BDR16/ARCHIBALD-the-battery-box/README.md

# ARCHIBALD-the-battery-box
*Before attempting to modify or alter any part or file within this assembly, please be sure to sync before and after any changes are made. After modification please be sure to commit changes as well.*
