BDR16/ARCHIBALD-the-battery-box/CURRENT.16-17/Accumulator/Stacks/Stack Design.xls

Sheet: Pressure
Pressure
The cells need to be compressed between 4 – 18 psi according to the A123 Amp20 Battery Pack Design Guide. This is particularly difficult because the cells expand as they are charged and as they age. In the design outlined below, an expansion limiter is used to fix the length of the stack, and compliant pads are placed between every other cell such that a pressure within the 4 – 18 psi range is maintained. The compliant pads need to be as thin as possible while still being able to expand and contract enough to keep a suitable pressure on the cell face. Additionally the compliant pad should be electrically insulating.
Repeating Cell Module
A two cell module is pictured to the right. The bottom part of the picture shows the module consisting of (left to right) an aluminum heat spreader, cell, compliant pad, cell, and Kapton tape. An analysis of the compliant pad's properties can be carried out at the two cell module level. The addition of an end module in the 21 cell stack will change the stack properties slightly, but not enough to warrant an analysis on the entire stack.
Cell Constants
Thickness (mm) | SOC expansion (mm) | Age expansion (mm) | Total expansion (mm) | Minimum pressure (kPa) | Maximum pressure (kPa)
7.1 | 0.05 | 0.36 | 0.41 | 27.58 | 124.11
Aluminum Constants
Thickness (mm) | Young's Modulus (kPa)
0.3 | 65000
Kapton Tape Constants
Thickness (mm) | Young's Modulus (kPa)
0.07 | 2500
Stack Constants
Minimum pressure (kPa) | Maximum pressure (kPa) | Total Length (mm)
35 | 100 | 15.4
System of Equations
We get the following system of equations by looking at the minimum pressure and maximum pressure operating points of the two cell stack module. We want to solve for compliant pad thickness and compliant pad Young's modulus. The following two equations are based off of Hooke's law, namely P = Eε. The aluminum, compliant pad, and Kapton tape thicknesses are calculated through Hooke's law, while the cell thickness is based on state of charge (SOC). The first equation is for 0% SOC with all new cells (minimum thickness), and the second equation is for 100% SOC with all old cells (maximum thickness).
(1 - P_min/E_aluminum) * L_aluminum + 2 * L_cell + (1 - P_min/E_kapton) * L_kapton + (1 – P_min/E_pad) * L_pad = L_total
(1 - P_max/E_aluminum) * L_aluminum + 2 * (L_cell + dL_cell_age + dL_cell_SOC) + (1 - P_max/E_kapton) * L_kapton + (1 – P_max/E_pad) * L_pad = L_total
Intermediate constant | E_pad (kPa) | L_pad (kPa)
0.0159558124 | 101.0539443 | 1.271538462
Design Choice
Neoprene and Polyurethane foam are two good choices for this application. However neoprene foam is much cheaper at the cost of slightly worse characteristics. A neoprene foam 1/16” thick and with a 9-13 psi firmness at 25% deflection was chosen. Its P_min and P_max are calculated below. Keep in mind that these batteries will not have time to age to the point that they have 3% to 5% deflection, therefore designing for only 1% or 2% to account for SOC is good enough.
E_pad (kPa) | L_pad (kPa)
75.8 | 1.5875
Minimum pressure (kPa) | 36.11289451
Maximum pressure (kPa) | 75.20540078
Size | 42” x 72”
Cost ($) | 16.06
Firmness (25%) | 9-13 psi (firm)
Link | http://www.mcmaster.com/#8647k109/=y4ipnx

Sheet: Thermal
Thermal
The cells will have hundreds of amperes of current running through them continuously. This means that they will heat up due to their internal resistance. This heat needs to be dissipated such that the cells do not overheat. Note that a two cell module will be used in the following design. The results can then be extended to the stack design because the stack is modular about the two cell module (for the most part).
Cell Constants
Internal Resistance (mOhm) | Preferred Temperature (ºC) | Max Temperature (ºC) | Continuous Current (A) | Peak Current (A)
3 | 50 | 60 | 200 | 600
Environment Constants
Ambient Temperature (ºC)
30
Thermal Design
The thermal load can be calculated from the continuous current and internal resistance. Then the required thermal resistance between the cells and their environment can be calculated for steady state. Note that this is for a two cell module, hence the constant factor of two.
Thermal Load (W) | Thermal Resistance (ºC/W) | Water Mass Flow (kg/s) | Water Volume Flow (L/min)
P = 2 * I^2 * R | R = ΔT / P | m/t = P / (c * ΔT) | V/t = m/t * 60
240 | 0.125 | 1.904761905 | 114.2857143
