BDR16/ARCHIBALD-the-battery-box/old.15-16/Firewall/Timeline.docx

Timeline for Firewall and Seat fabrication

Joshua Chang and Jordan Gardner

Updated February 20, 2016: Bullet points indicate actual completion of work.

Feb 3 – Feb 5: Fabricating firewall, ordering insulating material

- Feb 3 – 11: Fabrication
  - Cut and fit both firewalls

Feb 6 – Feb 7: Test fit firewalls, designate tab locations

- February 11: Test fit

Feb 9 – Feb 13: Acquire foam, glue it together, preliminary cut/shape

- Feb 13 – Feb 19: Foam acquired, individual sheets cut

Feb 14 – Feb 20: Refine shape, ensure we have vacuum bagging, other materials

Feb 21: Cover in fiberglass to create male mold

Feb 23 – Feb 25: Finish fiberglass, first layer of carbon

Feb 25 – Mar 1: More layers of carbon

Mar 1 – Mar 6: Finish carbon construction, test fit seat

Other tasks: Install tabs

Foam bead kit for seat

Fabrication times:
Tuesdays 10:15a – 11:30a

Tuesday and/or Thursday evenings
