BDR16/ARCHIBALD-the-battery-box/CURRENT.16-17/Accumulator/Battery Management System/BMS Controller/BMS Controller.SLDASM

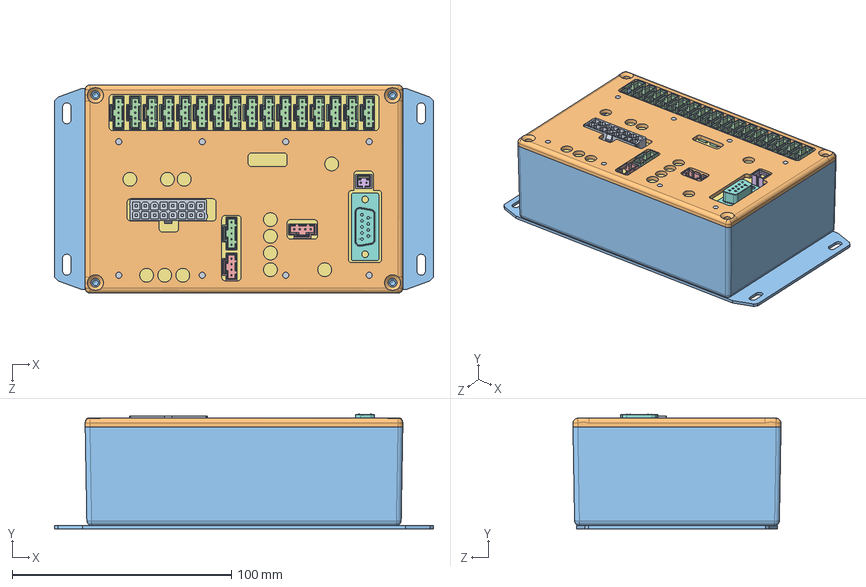
[picture p1: CAD file, 2016-11-20]
CURRENT.16-17/Accumulator/Battery Management System/BMS Controller/BMS Controller.SLDASM
173.0 x 52.3 x 95.0 mm
PEM FHS-440-4ZI x 8
1590J Lid
1590JF Box
Molex 705430004 x 17
Molex 705430003 x 2
Molex 705430001
Lithiumate Board
NorComp 171-009-213
Molex 039281163
