BDR16/ARCHIBALD-the-battery-box/CURRENT.16-17/Accumulator/Stacks/Cell Modules/Negative End Module Even.SLDASM

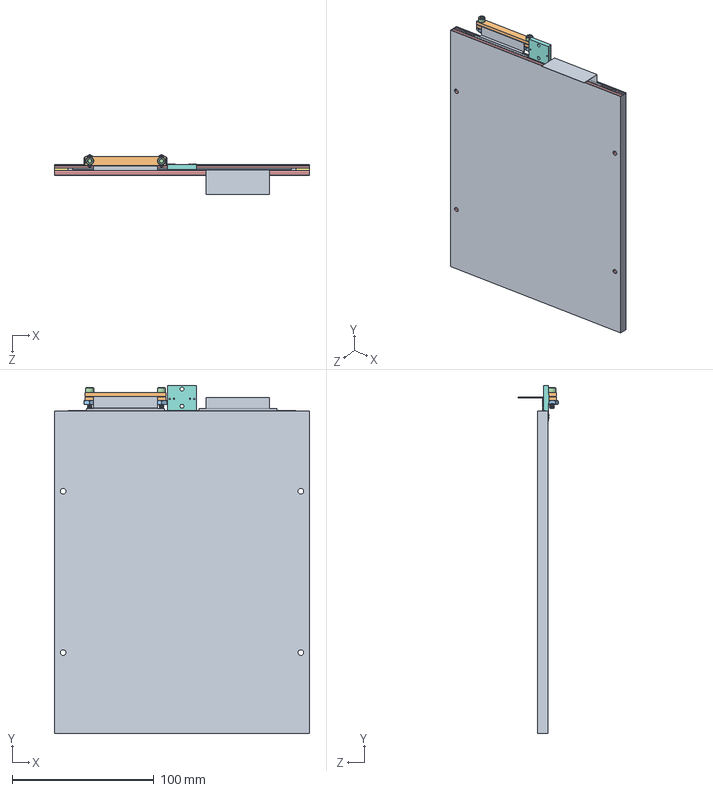
[picture p2: CAD file, 2016-11-20]
CURRENT.16-17/Accumulator/Stacks/Cell Modules/Negative End Module Even.SLDASM
179.7 x 245.1 x 28.3 mm
Cell Tab Config A Negative End
Tab Load Spreader x 2
Steel Toplock 6-32 Grade 2 x 2
Steel 6-32 0.4375in x 2
Repeating Frame Outer x 3
Insulation Film Back
Insulation Film Half
Cell Board End
Heat Sink Half
