BDR16/ARCHIBALD-the-battery-box/CURRENT.16-17/Accumulator/Stacks/Stack Parts/Insulation Film/Insulation Film Full.SLDPRT

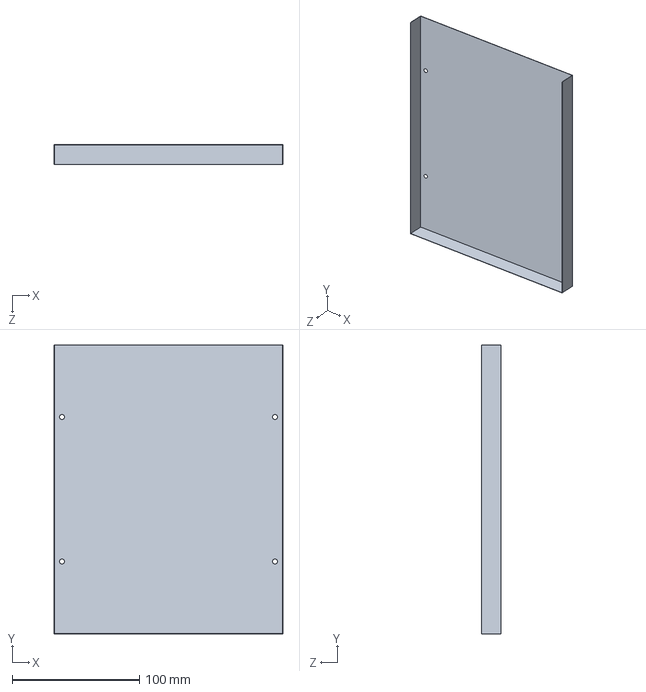
[picture p3: CAD file, 2016-11-20]
CURRENT.16-17/Accumulator/Stacks/Stack Parts/Insulation Film/Insulation Film Full.SLDPRT
179.7 x 227.2 x 15.5 mm
