BDR16/ARCHIBALD-the-battery-box/CURRENT.16-17/Accumulator/Charging/Charging.SLDASM

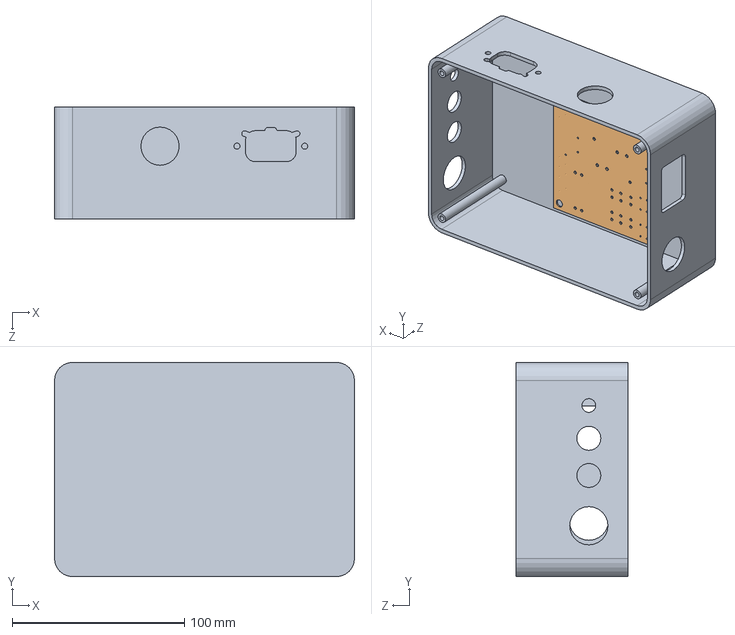
[picture p4: CAD file, 2016-11-20]
CURRENT.16-17/Accumulator/Charging/Charging.SLDASM
174.3 x 124.5 x 65.3 mm
Charging Box
Charging Board
