BDR16/ARCHIBALD-the-battery-box/CURRENT.16-17/Accumulator/HV Control/Current Sensor/Current Sensor.SLDASM

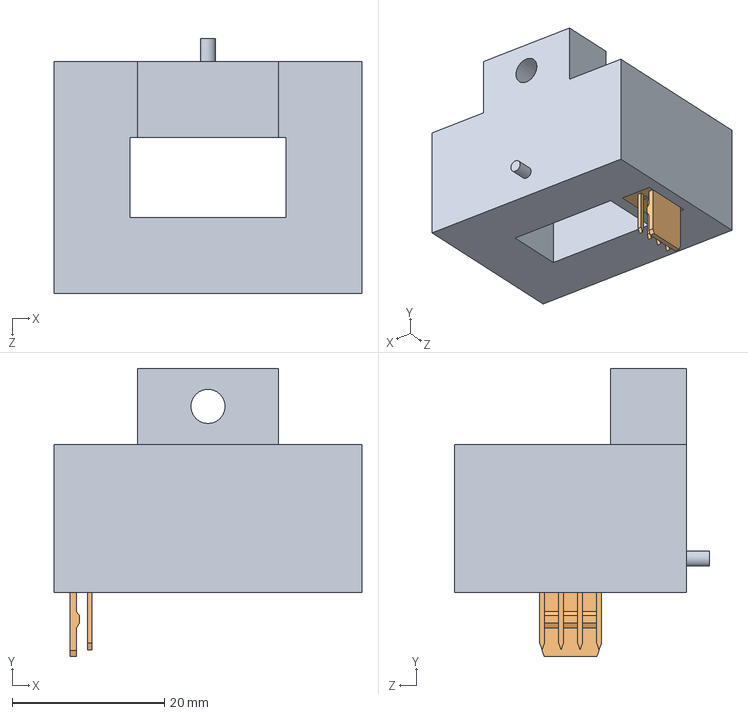
[picture p5: CAD file, 2016-11-20]
CURRENT.16-17/Accumulator/HV Control/Current Sensor/Current Sensor.SLDASM
40.5 x 37.9 x 33.5 mm
Current Sensor
Current Sensor Connector
