BDR16/ARCHIBALD-the-battery-box/CURRENT.16-17/Accumulator/Motor Controller/Motor Controller.SLDASM

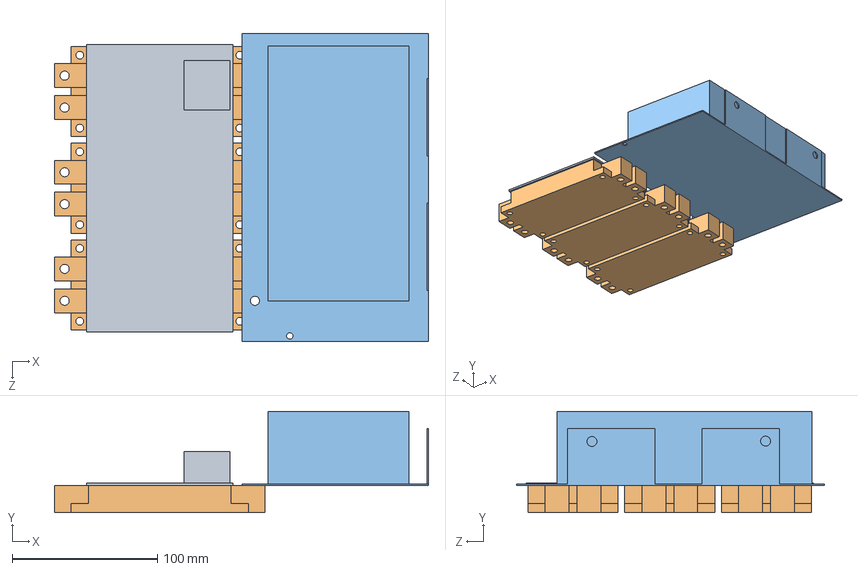
[picture p6: CAD file, 2016-11-20]
CURRENT.16-17/Accumulator/Motor Controller/Motor Controller.SLDASM
257.5 x 69.8 x 212.0 mm
HV Board
IGBT x 3
Capacitor Board
