BDR16/ARCHIBALD-the-battery-box/CURRENT.16-17/Accumulator/HV Control/HV Fusing/HV Fusing.SLDASM

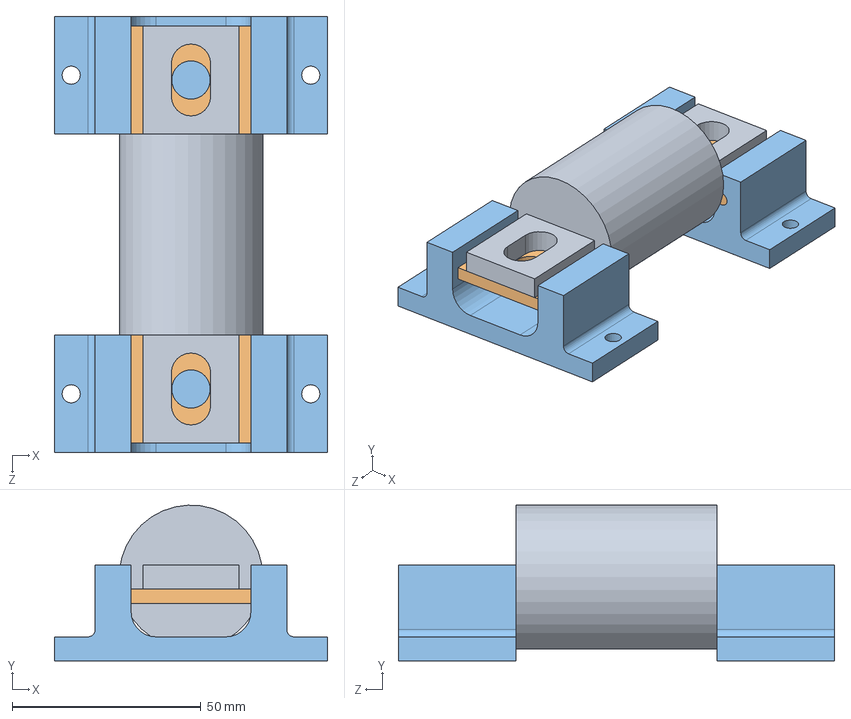
[picture p9: CAD file, 2016-11-20]
CURRENT.16-17/Accumulator/HV Control/HV Fusing/HV Fusing.SLDASM
72.4 x 41.3 x 115.6 mm
HV Fuse
HV Fuseholder Plate x 2
HV Fuseholder x 2
