BDR16/ARCHIBALD-the-battery-box/CURRENT.16-17/Accumulator/HV Control/Segment Maintenance Disconnect.SLDPRT

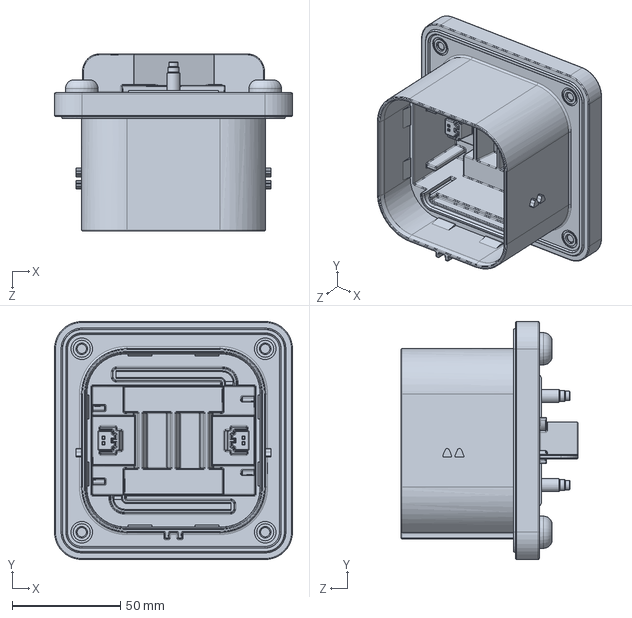
[picture p10: CAD file, 2016-11-20]
CURRENT.16-17/Accumulator/HV Control/Segment Maintenance Disconnect.SLDPRT
110.0 x 110.0 x 82.0 mm
