BDR16/ARCHIBALD-the-battery-box/new.16-17/BOX-LID-MOD.SLDASM

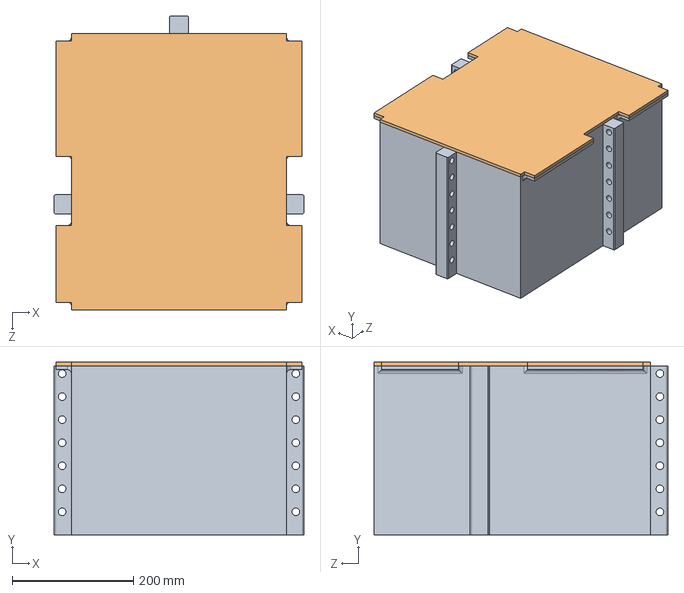
[picture p12: CAD file, 2016-12-18]
new.16-17/BOX-LID-MOD.SLDASM
412.8 x 285.8 x 485.8 mm
