BDR16/ARCHIBALD-the-battery-box/CURRENT.16-17/Accumulator/Covers/Covers.SLDASM

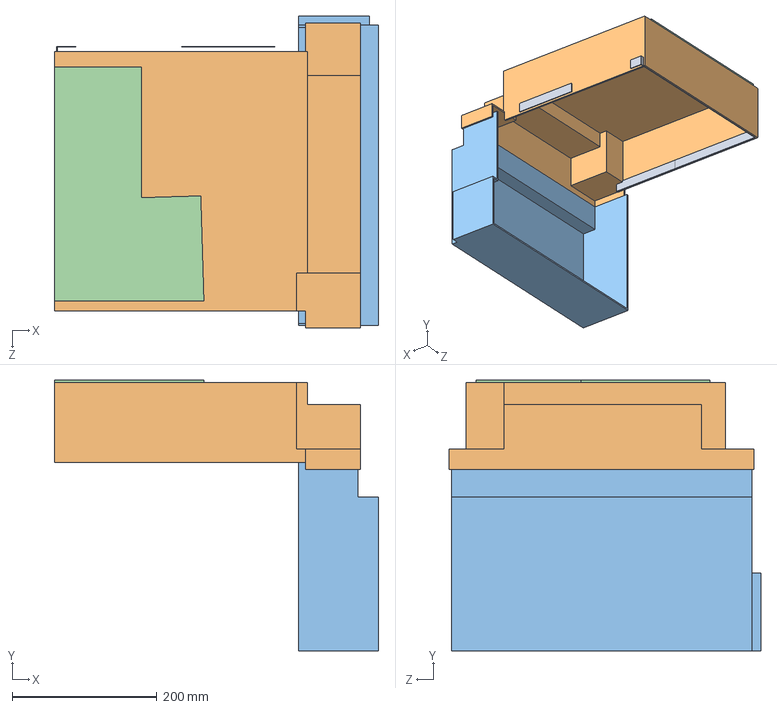
[picture p13: CAD file, 2016-11-20]
CURRENT.16-17/Accumulator/Covers/Covers.SLDASM
448.9 x 374.6 x 431.8 mm
Top Cover
Back Cover
