BDR16/ARCHIBALD-the-battery-box/CURRENT.16-17/Accumulator/Stacks/Cell Modules/Two Cell Module.SLDASM

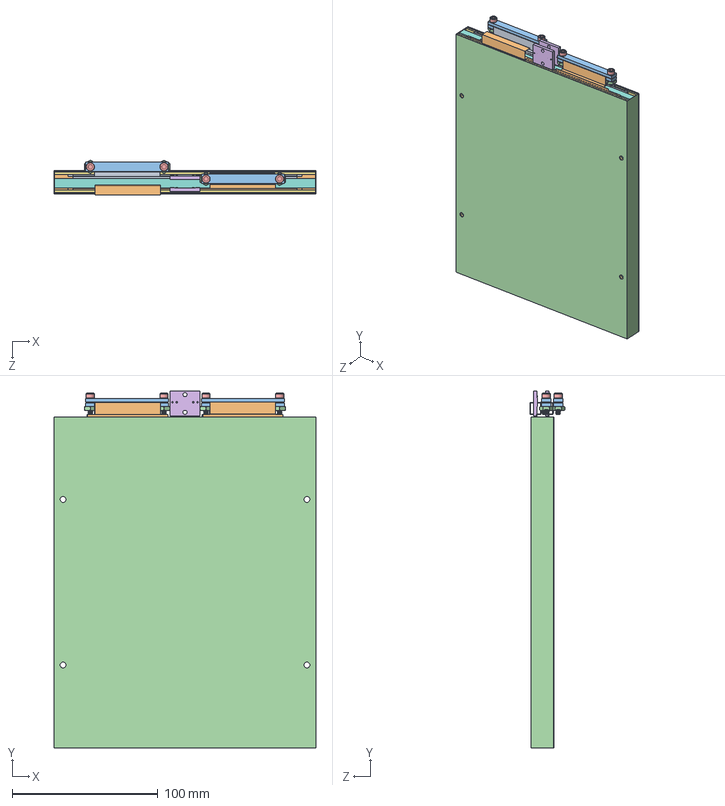
[picture p14: CAD file, 2016-11-20]
CURRENT.16-17/Accumulator/Stacks/Cell Modules/Two Cell Module.SLDASM
179.7 x 245.1 x 23.8 mm
Cell Tab Config A
Cell Tab Config B
Tab Load Spreader x 4
Steel Toplock 6-32 Grade 2 x 4
Steel 6-32 0.4375in x 4
Cell Board Middle x 2
Repeating Frame Outer x 2
Repeating Frame Inner
Insulation Film Back
Insulation Film Full
Cell Load Spreader
Heat Sink Full
