BDR16/ARCHIBALD-the-battery-box/CURRENT.16-17/Accumulator/Stacks/Thermal Simulation/Solidworks Model/Cell.SLDASM

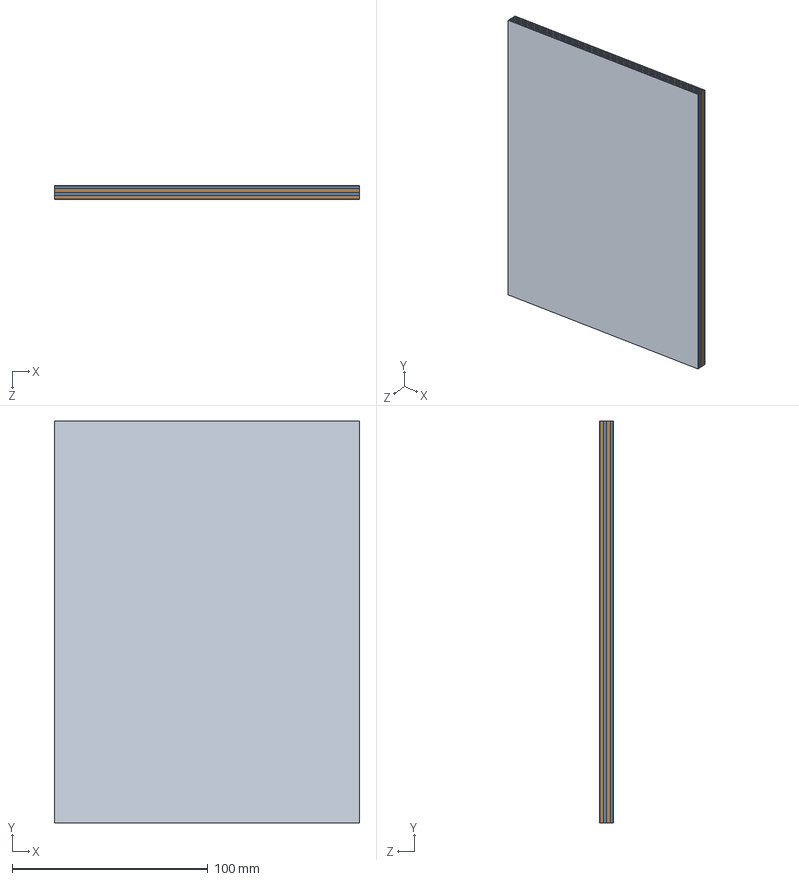
[picture p15: CAD file, 2016-11-20]
CURRENT.16-17/Accumulator/Stacks/Thermal Simulation/Solidworks Model/Cell.SLDASM
156.1 x 205.5 x 7.10 mm
Pouch x 2
Positive Layer x 25
Negative Layer x 25
