BDR16/ARCHIBALD-the-battery-box/new.16-17/BOX4simulatingmount2chassis.SLDASM

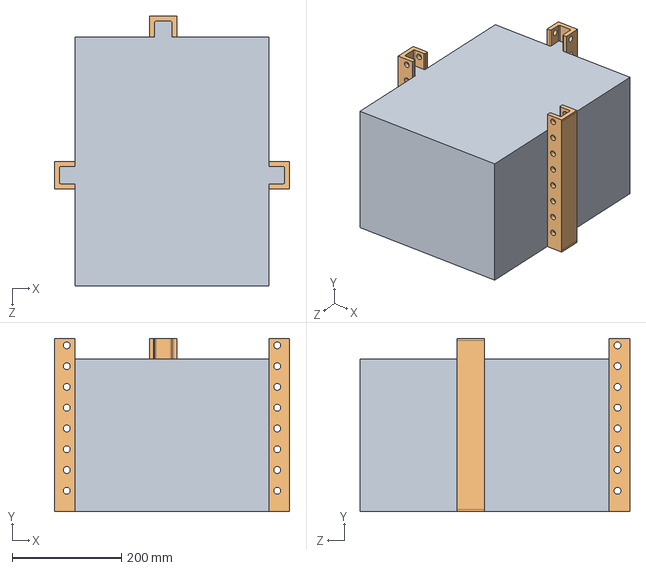
[picture p16: CAD file, 2016-12-18]
new.16-17/BOX4simulatingmount2chassis.SLDASM
431.8 x 317.5 x 495.3 mm
Aydin_working_box
Rail x 3
