BDR16/ARCHIBALD-the-battery-box/CURRENT.16-17/Accumulator/Motor Controller/Bamocar.SLDASM

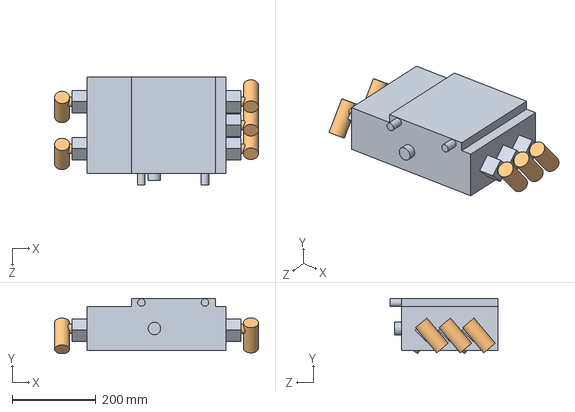
[picture p17: CAD file, 2016-11-20]
CURRENT.16-17/Accumulator/Motor Controller/Bamocar.SLDASM
486.0 x 132.1 x 258.0 mm
BamoCar
Pfisterer Elbow x 5
