BDR16/ARCHIBALD-the-battery-box/new.16-17/Chassis box working model.SLDASM

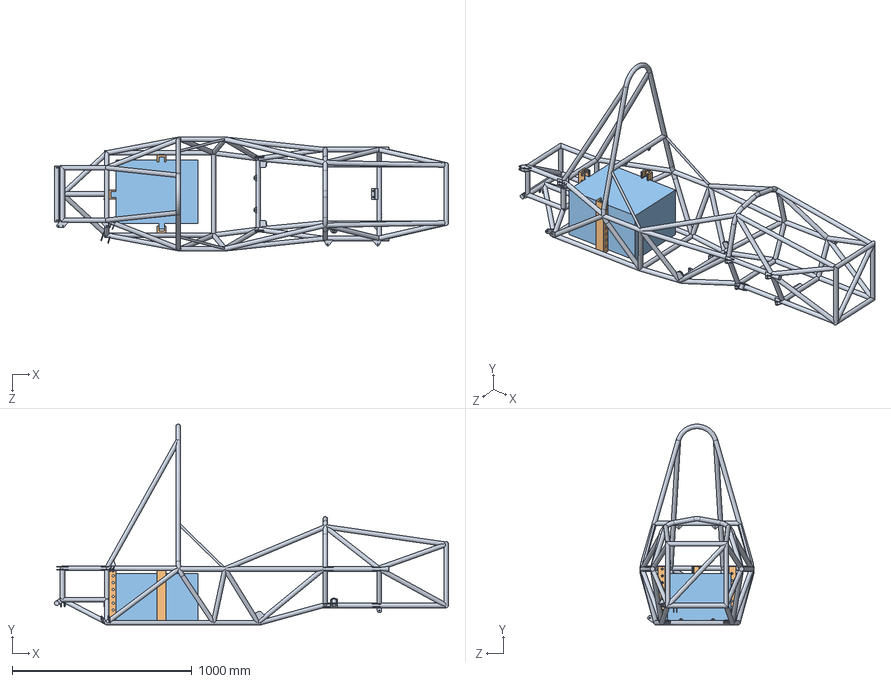
[picture p18: CAD file, 2016-12-18]
new.16-17/Chassis box working model.SLDASM
2192.5 x 1117.8 x 635.0 mm
Chassis
Rail x 3
Aydin_working_box
