BDR16/ARCHIBALD-the-battery-box/new.16-17/AccumulatorDesigns_12-18/Stack_Dividers.SLDASM

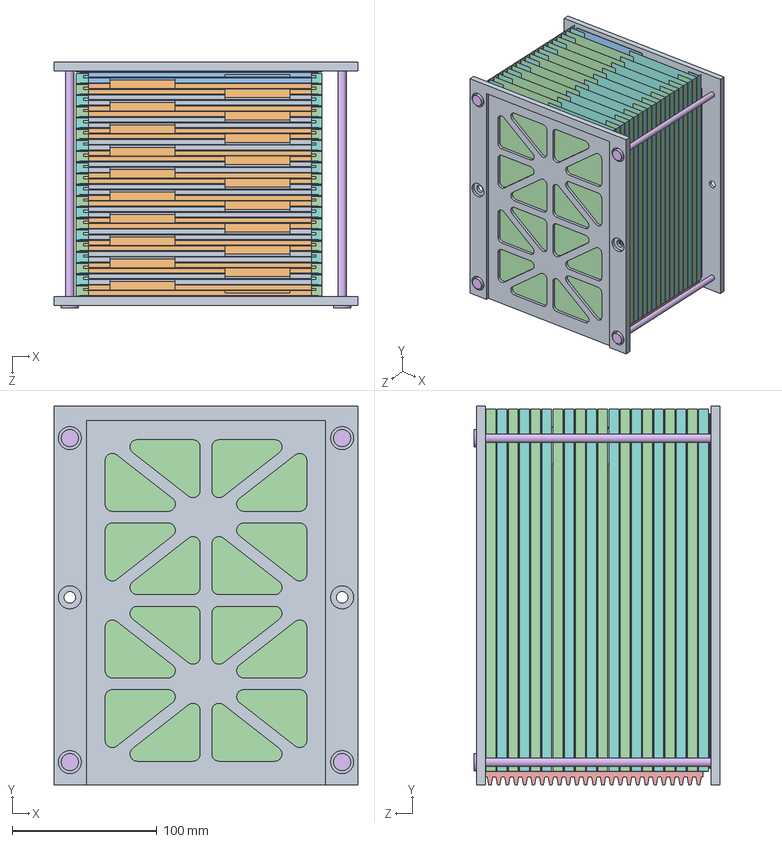
[picture p19: CAD file, 2016-12-18]
new.16-17/AccumulatorDesigns_12-18/Stack_Dividers.SLDASM
209.5 x 261.6 x 170.1 mm
End_Plate x 2
Cell_B_End
Neoprene_Insulation_B x 21
Copper_Divider_B x 10
Heatsink
Connecting_Rod x 4
Spacer
Copper_Divider_A x 10
Cell_A x 9
Cell_B x 9
Cell_A_End
