BDR16/ARCHIBALD-the-battery-box/new.16-17/AccumulatorDesigns/Stack.SLDASM

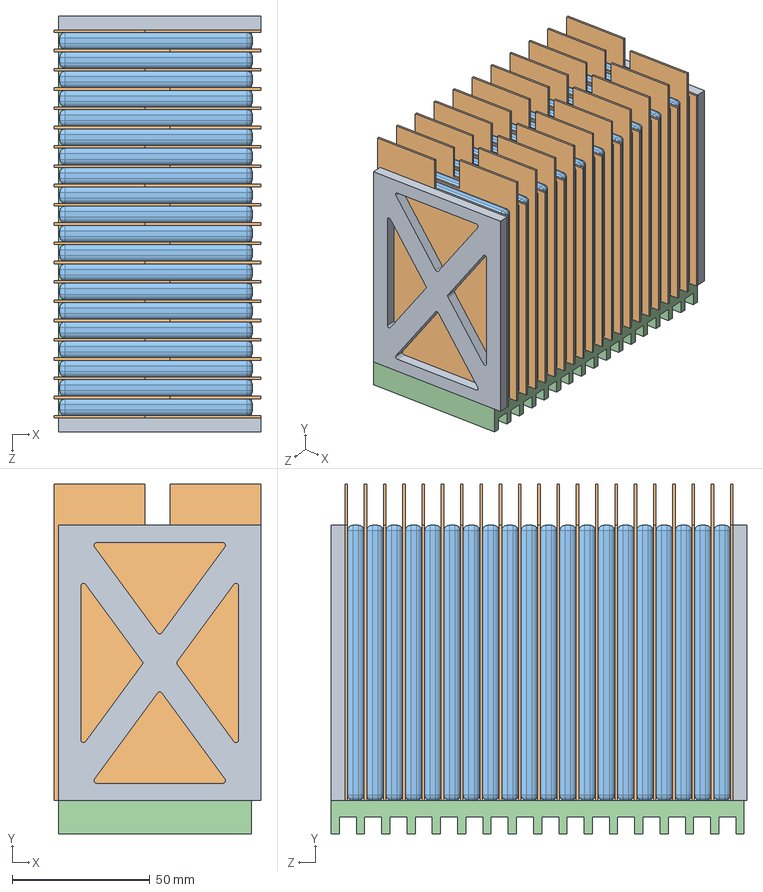
[picture p20: CAD file, 2016-12-09]
new.16-17/AccumulatorDesigns/Stack.SLDASM
75.0 x 126.9 x 151.0 mm
End_Plate x 2
Wall x 21
Cell x 20
Heatsink
