BDR16/ARCHIBALD-the-battery-box/new.16-17/Even Stack.SLDASM

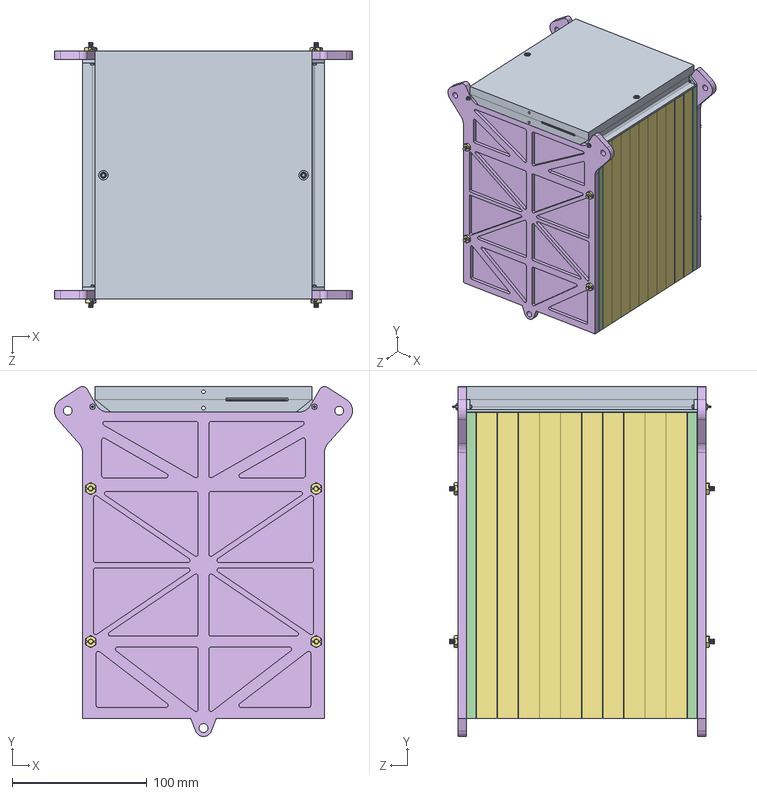
[picture p22: CAD file, 2016-11-20]
new.16-17/Even Stack.SLDASM
221.6 x 260.1 x 196.7 mm
Tab Cover Even
Steel Hex 4-40 Grade 2 x 2
Socket 4-40 0.625in x 2
Cell Tab Config A x 10
Cell Tab Config B x 10
Tab Load Spreader x 42
Steel Toplock 6-32 Grade 2 x 50
Steel 6-32 0.4375in x 42
Cell Board Middle x 20
Repeating Frame Outer x 26
Repeating Frame Inner x 10
Insulation Film Back x 11
Insulation Film Full x 10
Cell Load Spreader x 10
Heat Sink Full x 10
Cell Tab Config B Positive End
Cell Board End x 2
Insulation Film Half x 2
Insulation Film End
Heat Sink Half x 2
Cell Tab Config A Negative End
End Plate x 2
Even Threaded Rod x 4
Steel 0-80 1_2in x 4
Steel Hex 0-80 Grade 2 x 4
