BDR16/ARCHIBALD-the-battery-box/new.16-17/Sixer Stack.SLDASM

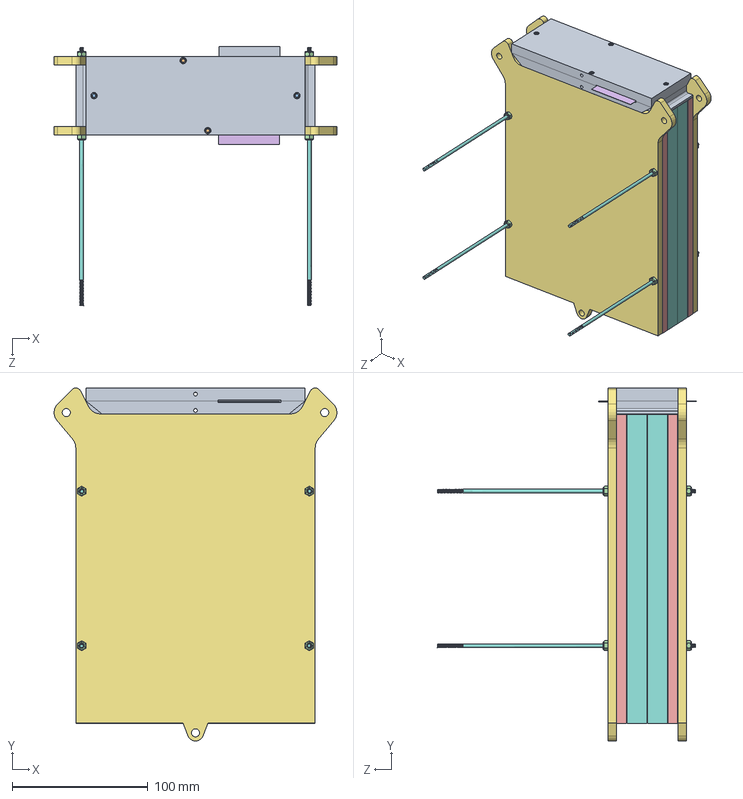
[picture p23: CAD file, 2016-11-20]
new.16-17/Sixer Stack.SLDASM
208.0 x 259.6 x 190.5 mm
Tab Cover Sixer
Steel 4-40 1in x 2
Socket 4-40 0.625in x 2
Steel Nylon-Insert Locknut 4-40 x 10
Cell Tab Config A x 2
Cell Tab Config B x 2
Tab Load Spreader x 10
Steel Toplock 6-32 Grade 2 x 10
Steel 6-32 0.4375in x 10
Cell Board Middle x 4
Repeating Frame Outer x 10
Repeating Frame Inner x 2
Insulation Film Back x 3
Insulation Film Full x 2
Cell Load Spreader x 2
Heat Sink Full x 2
Cell Tab Config B Positive End
Cell Board End x 2
Insulation Film Half x 2
Insulation Film End
Heat Sink Half x 2
Cell Tab Config A Negative End
End Plate x 2
Threaded Rod x 4
