BDR16/ARCHIBALD-the-battery-box/CURRENT.16-17/Accumulator/Battery Box Handle.SLDPRT

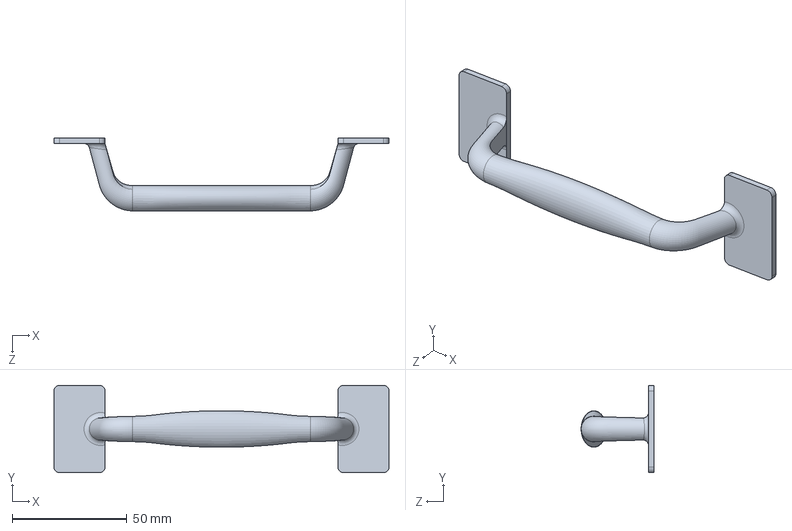
[picture p24: CAD file, 2016-11-20]
CURRENT.16-17/Accumulator/Battery Box Handle.SLDPRT
146.1 x 38.1 x 31.7 mm
