BDR16/ARCHIBALD-the-battery-box/CURRENT.16-17/Accumulator/Battery Management System/Cell Boards/Cell Board End.SLDPRT

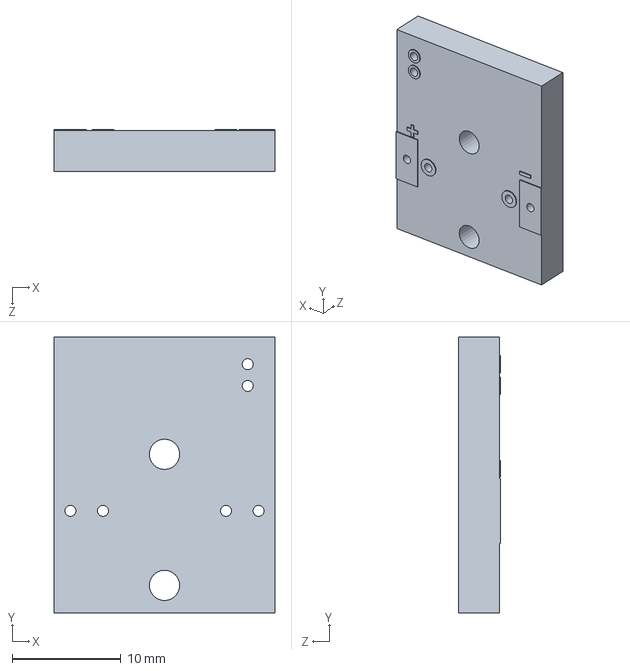
[picture p25: CAD file, 2016-11-20]
CURRENT.16-17/Accumulator/Battery Management System/Cell Boards/Cell Board End.SLDPRT
20.3 x 25.4 x 3.91 mm
