BDR16/ARCHIBALD-the-battery-box/CURRENT.16-17/Accumulator/Connectors/Amphenol Triple PowerLok/Amphenol Triple PowerLok Connector.SLDPRT

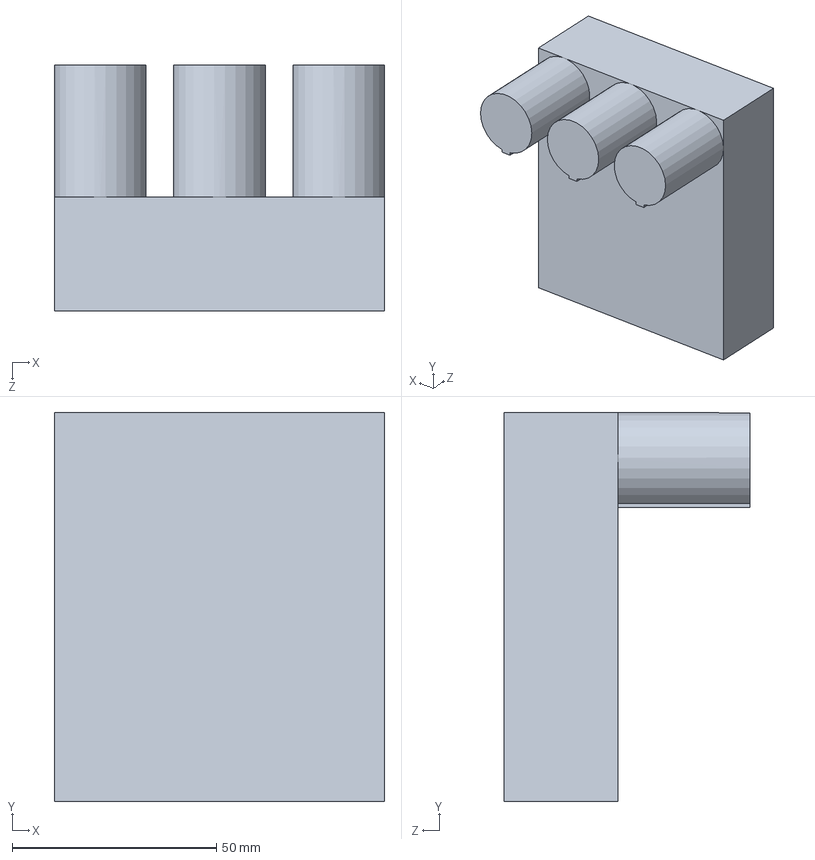
[picture p26: CAD file, 2016-11-20]
CURRENT.16-17/Accumulator/Connectors/Amphenol Triple PowerLok/Amphenol Triple PowerLok Connector.SLDPRT
80.8 x 95.2 x 60.3 mm
