BDR16/ARCHIBALD-the-battery-box/CURRENT.16-17/Accumulator/Covers/Bottom Seal.SLDPRT

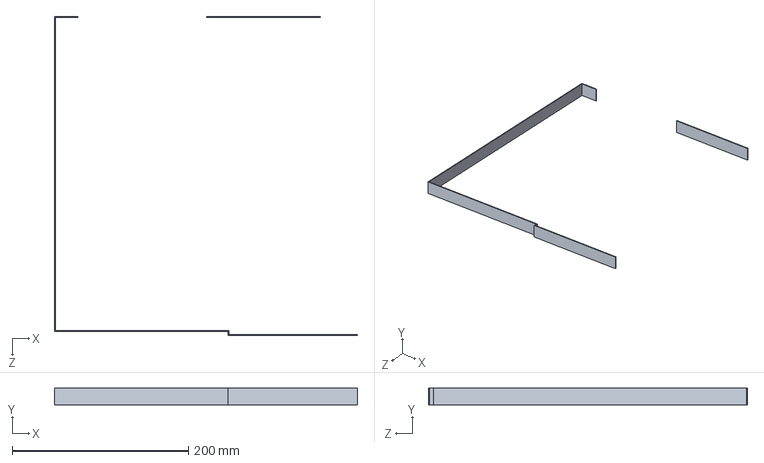
[picture p27: CAD file, 2016-11-20]
CURRENT.16-17/Accumulator/Covers/Bottom Seal.SLDPRT
344.2 x 19.1 x 362.9 mm
