BDR16/ARCHIBALD-the-battery-box/CURRENT.16-17/Accumulator/HV Control/Bus Bars/Positive Stack to HV Fuse.SLDPRT

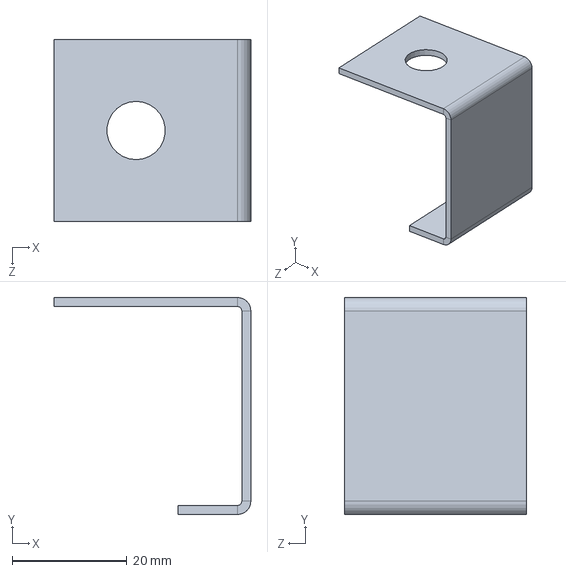
[picture p28: CAD file, 2016-11-20]
CURRENT.16-17/Accumulator/HV Control/Bus Bars/Positive Stack to HV Fuse.SLDPRT
34.3 x 37.8 x 31.8 mm
