BDR16/ARCHIBALD-the-battery-box/CURRENT.16-17/Accumulator/HV Control/Current Sensor/Current Sensor Connector.SLDPRT

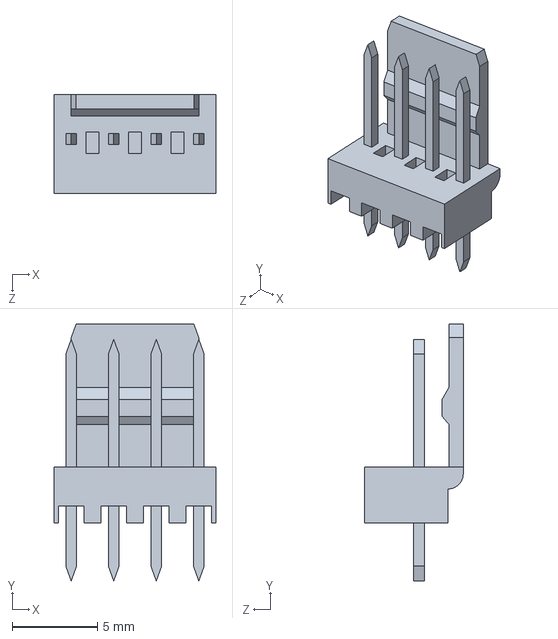
[picture p29: CAD file, 2016-11-20]
CURRENT.16-17/Accumulator/HV Control/Current Sensor/Current Sensor Connector.SLDPRT
9.50 x 15.1 x 5.80 mm
