BDR16/ARCHIBALD-the-battery-box/CURRENT.16-17/Accumulator/HV Control/HV Fusing/HV Fuse.SLDPRT

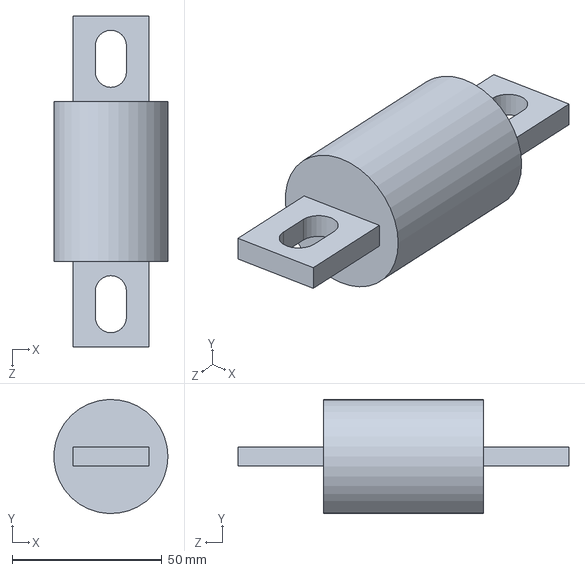
[picture p30: CAD file, 2016-11-20]
CURRENT.16-17/Accumulator/HV Control/HV Fusing/HV Fuse.SLDPRT
38.0 x 38.1 x 110.5 mm
