BDR16/ARCHIBALD-the-battery-box/CURRENT.16-17/Accumulator/Motor Controller/Current Shunt Bent Shorter.SLDPRT

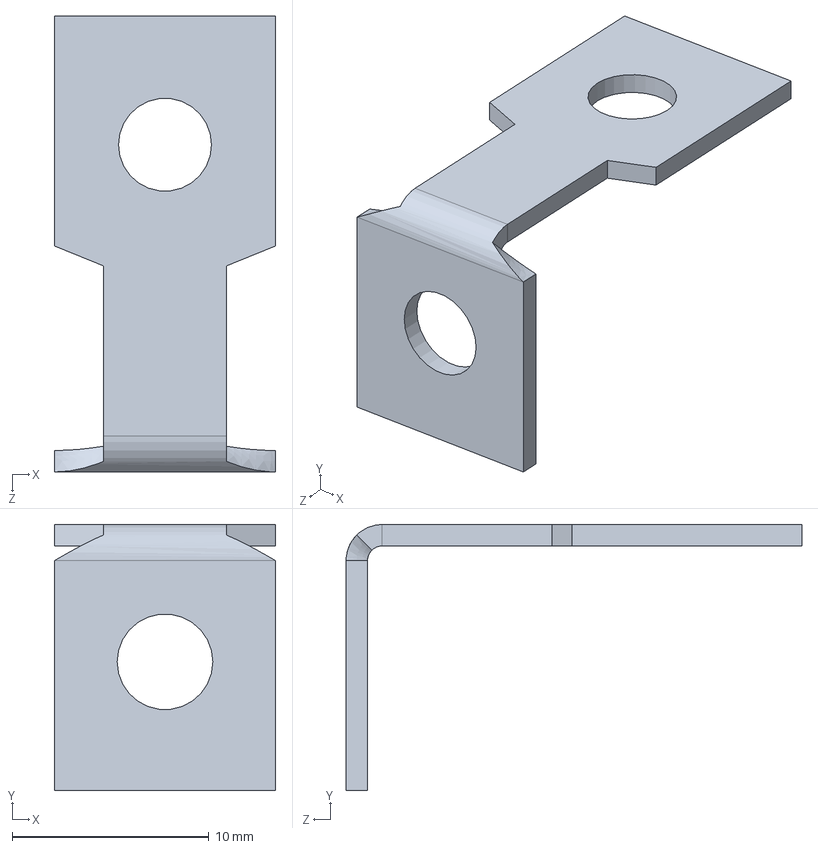
[picture p32: CAD file, 2016-11-20]
CURRENT.16-17/Accumulator/Motor Controller/Current Shunt Bent Shorter.SLDPRT
11.3 x 13.5 x 23.2 mm
