BDR16/ARCHIBALD-the-battery-box/CURRENT.16-17/Accumulator/Motor Controller/Motor Controller Board/Regular Tab.SLDPRT

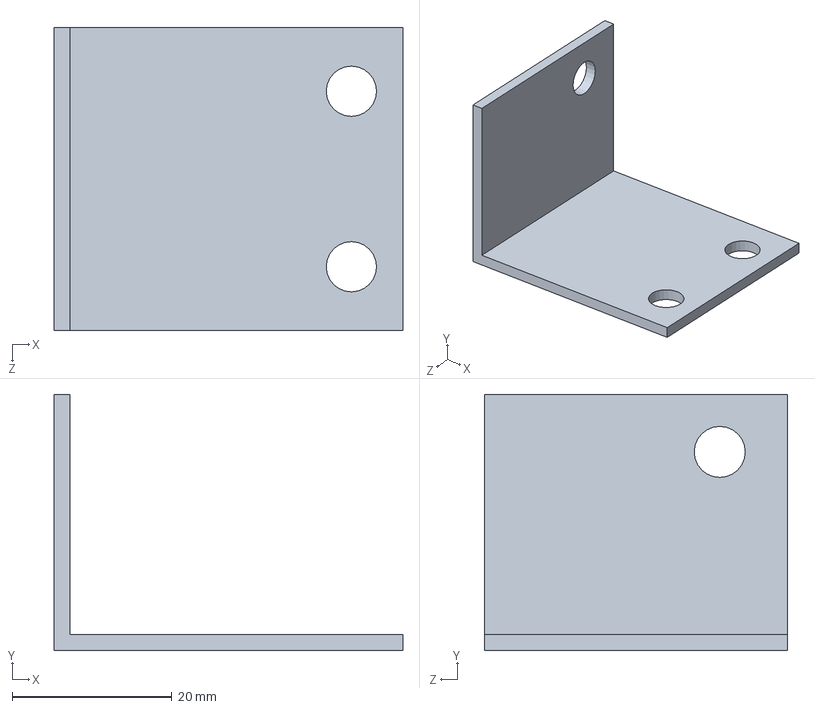
[picture p33: CAD file, 2016-11-20]
CURRENT.16-17/Accumulator/Motor Controller/Motor Controller Board/Regular Tab.SLDPRT
43.8 x 32.1 x 38.0 mm
