BDR16/ARCHIBALD-the-battery-box/CURRENT.16-17/Accumulator/Stacks/Cells/Cell Tab Config B Negative End.SLDPRT

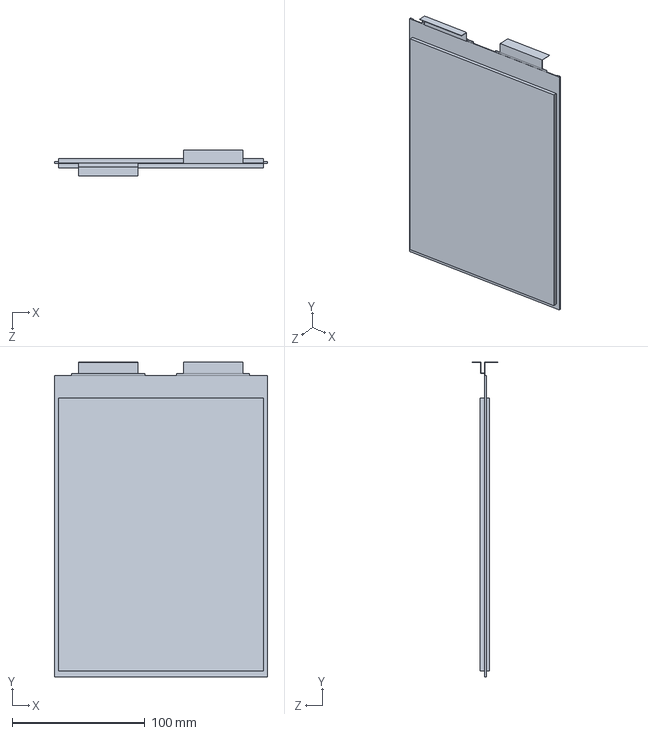
[picture p34: CAD file, 2016-11-20]
CURRENT.16-17/Accumulator/Stacks/Cells/Cell Tab Config B Negative End.SLDPRT
160.6 x 237.2 x 19.8 mm
