BDR16/ARCHIBALD-the-battery-box/CURRENT.16-17/Accumulator/Stacks/Stack Parts/Expansion Limiter/Even Threaded Rod.SLDPRT

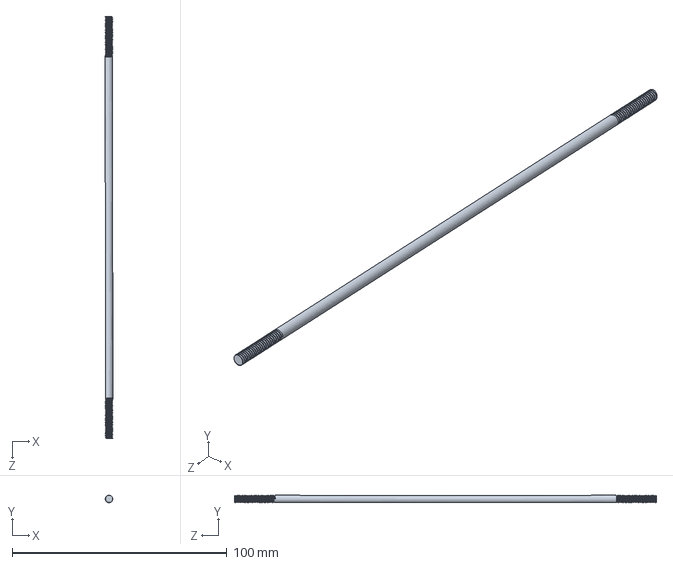
[picture p35: CAD file, 2016-11-20]
CURRENT.16-17/Accumulator/Stacks/Stack Parts/Expansion Limiter/Even Threaded Rod.SLDPRT
3.51 x 3.51 x 196.7 mm
