BDR16/ARCHIBALD-the-battery-box/CURRENT.16-17/Accumulator/Stacks/Stack Parts/Heat Sink/Heat Sink Half.SLDPRT

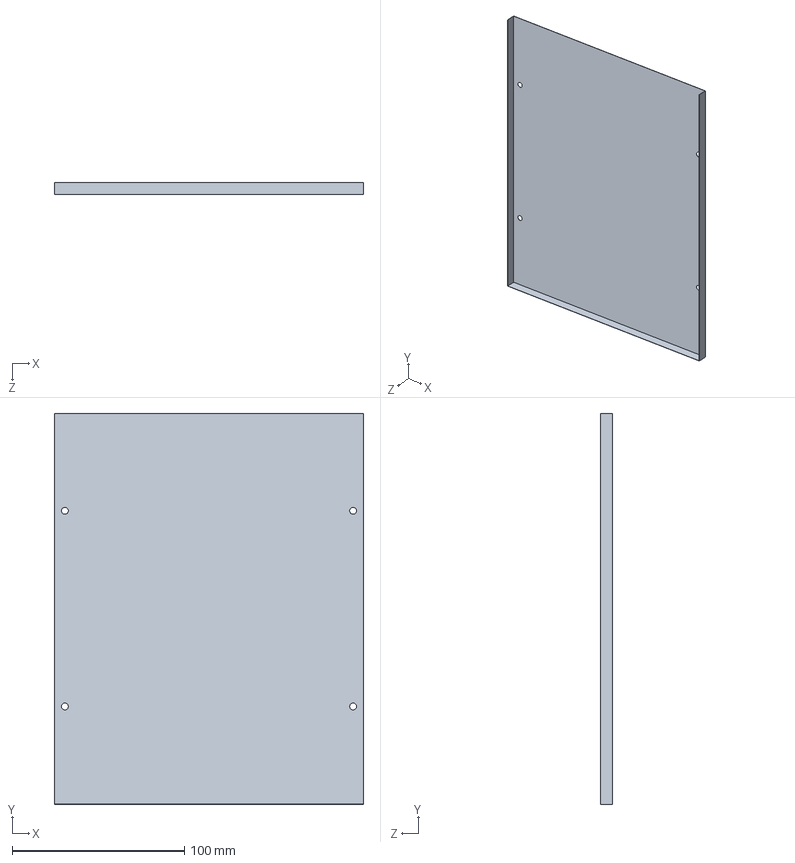
[picture p36: CAD file, 2016-11-20]
CURRENT.16-17/Accumulator/Stacks/Stack Parts/Heat Sink/Heat Sink Half.SLDPRT
179.7 x 227.2 x 7.20 mm
