BDR16/ARCHIBALD-the-battery-box/CURRENT.16-17/Accumulator/Stacks/Stack Parts/Repeating Frame/Repeating Frame Outer.SLDPRT

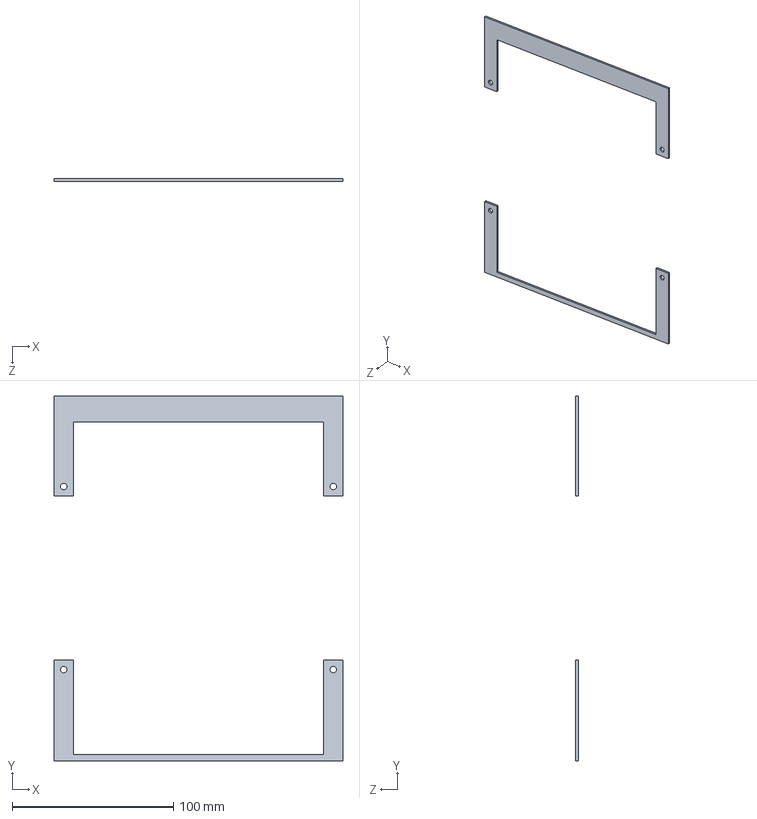
[picture p37: CAD file, 2016-11-20]
CURRENT.16-17/Accumulator/Stacks/Stack Parts/Repeating Frame/Repeating Frame Outer.SLDPRT
179.3 x 226.6 x 1.59 mm
