BDR16/ARCHIBALD-the-battery-box/CURRENT.16-17/Accumulator/Stacks/Stack Parts/Tab Cover/Tab Cover Even.SLDPRT

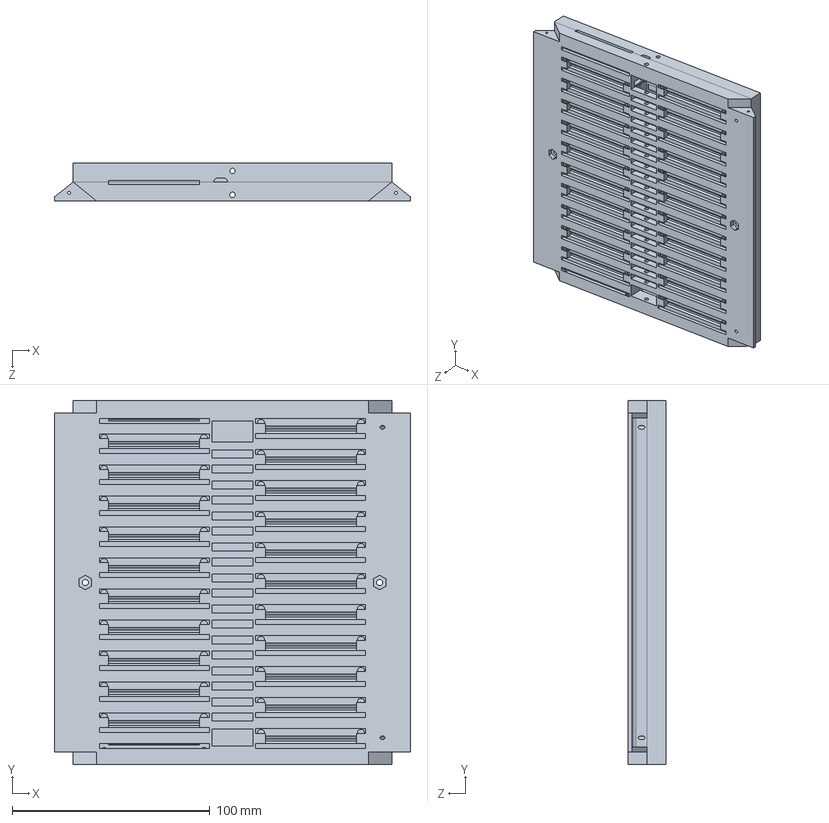
[picture p38: CAD file, 2016-11-20]
CURRENT.16-17/Accumulator/Stacks/Stack Parts/Tab Cover/Tab Cover Even.SLDPRT
180.0 x 184.3 x 19.1 mm
