BDR16/ARCHIBALD-the-battery-box/CURRENT.16-17/Accumulator/Stacks/Stack Parts/Tab Load Spreader.SLDPRT

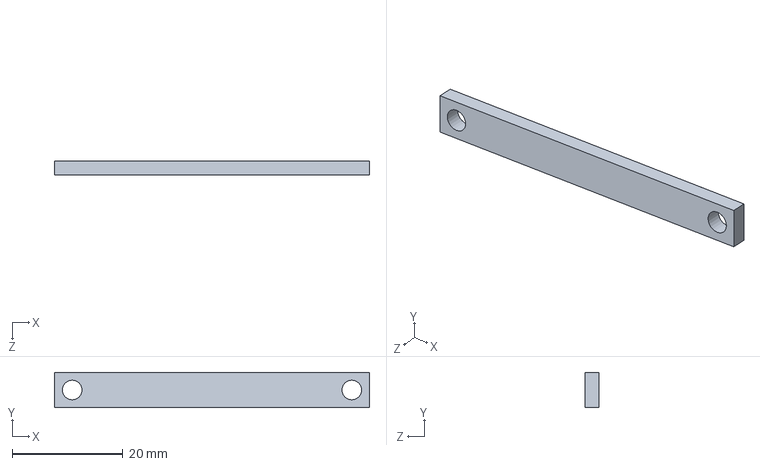
[picture p39: CAD file, 2016-11-20]
CURRENT.16-17/Accumulator/Stacks/Stack Parts/Tab Load Spreader.SLDPRT
57.0 x 6.41 x 2.54 mm
