BDR16/ARCHIBALD-the-battery-box/CURRENT.16-17/Accumulator/Thermal Analysis/Accumulator Box Thermal.SLDPRT

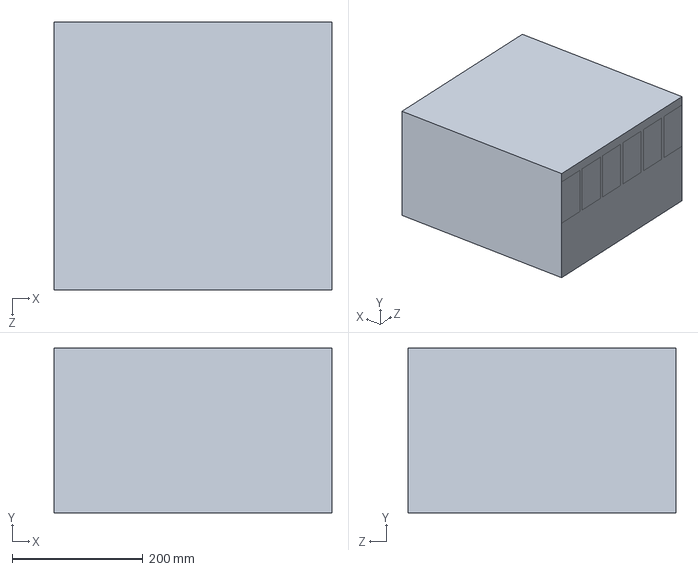
[picture p41: CAD file, 2016-11-20]
CURRENT.16-17/Accumulator/Thermal Analysis/Accumulator Box Thermal.SLDPRT
425.0 x 252.1 x 410.0 mm
