BDR16/ARCHIBALD-the-battery-box/CURRENT.16-17/Accumulator/Water Block/Water Block.SLDPRT

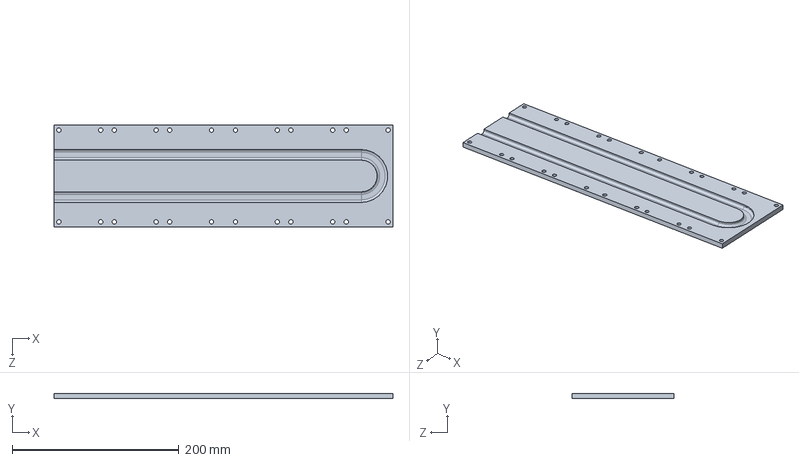
[picture p42: CAD file, 2016-11-20]
CURRENT.16-17/Accumulator/Water Block/Water Block.SLDPRT
407.0 x 6.35 x 122.0 mm
