BDR16/ARCHIBALD-the-battery-box/new.16-17/AccumulatorDesigns_12-18/Neoprene_Insulation_A.SLDPRT

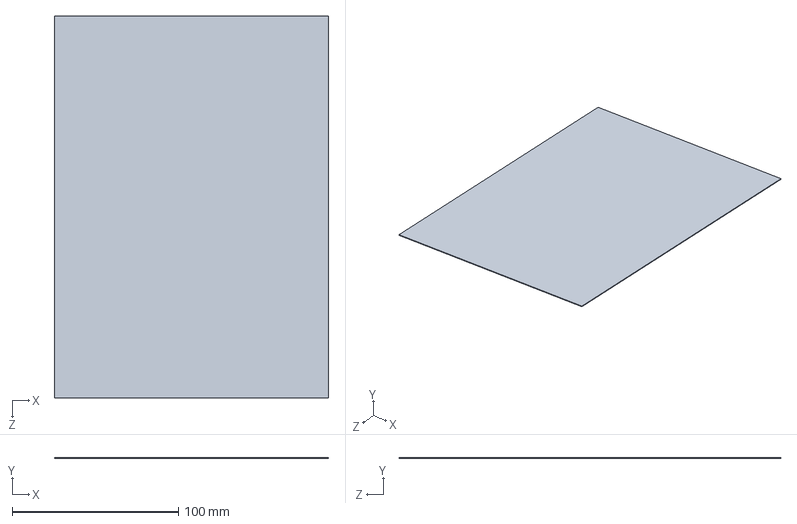
[picture p43: CAD file, 2016-12-18]
new.16-17/AccumulatorDesigns_12-18/Neoprene_Insulation_A.SLDPRT
165.0 x 0.5 x 230.0 mm
