BDR16/ARCHIBALD-the-battery-box/new.16-17/LID.SLDPRT

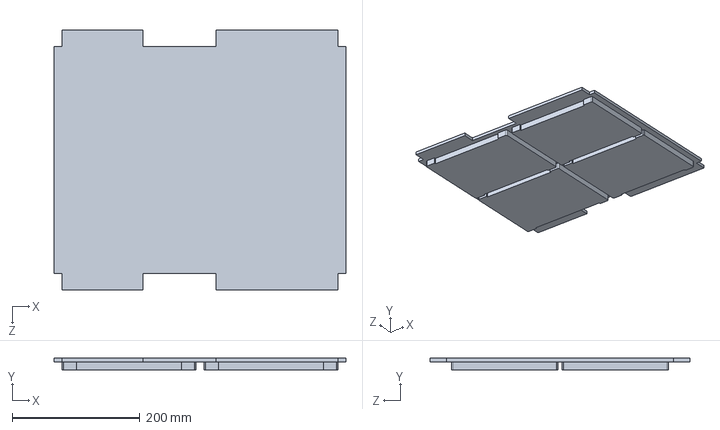
[picture p44: CAD file, 2016-12-18]
new.16-17/LID.SLDPRT
457.2 x 19.0 x 406.4 mm
