BDR16/ARCHIBALD-the-battery-box/CURRENT.16-17/Accumulator/Accumulator Box LV Panel CAM.SLDPRT

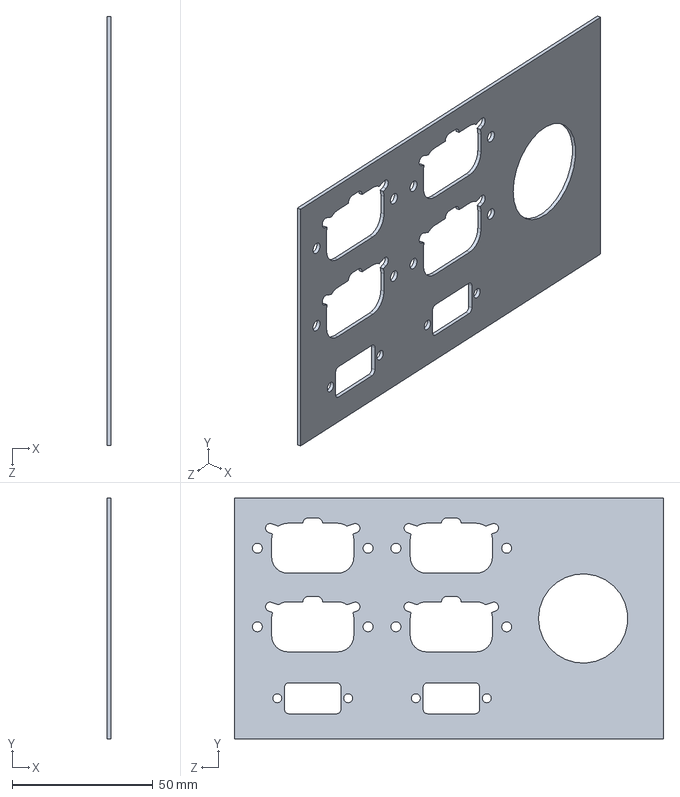
[picture p45: CAD file, 2016-11-20]
CURRENT.16-17/Accumulator/Accumulator Box LV Panel CAM.SLDPRT
1.27 x 85.5 x 152.5 mm
