BDR16/ARCHIBALD-the-battery-box/CURRENT.16-17/Accumulator/Battery Management System/Cell Boards/Cell Board Middle.SLDPRT

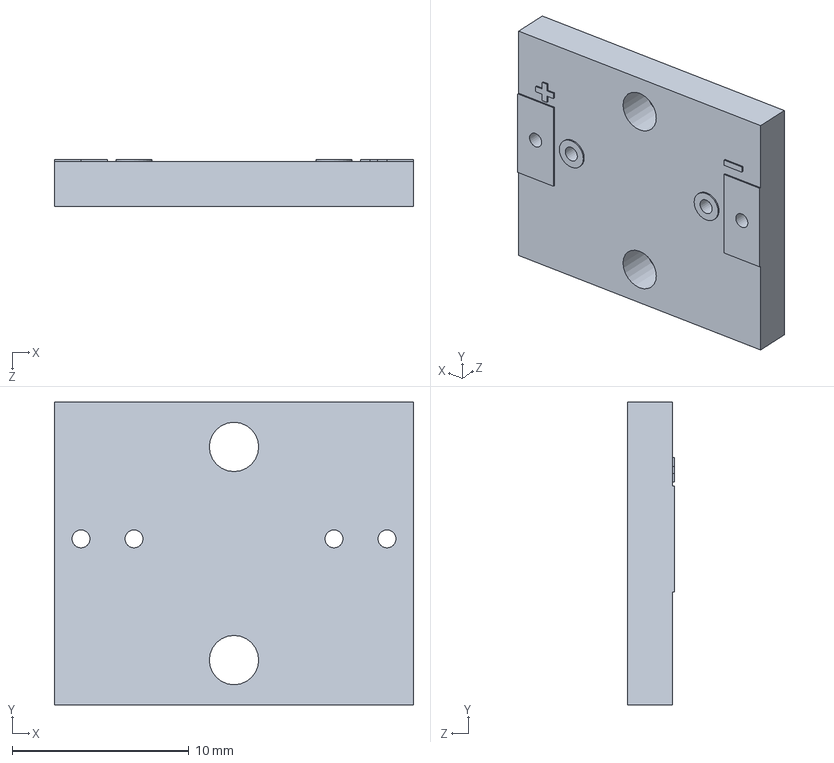
[picture p46: CAD file, 2016-11-20]
CURRENT.16-17/Accumulator/Battery Management System/Cell Boards/Cell Board Middle.SLDPRT
20.3 x 17.1 x 2.64 mm
