BDR16/ARCHIBALD-the-battery-box/CURRENT.16-17/Accumulator/Connectors/Amphenol Triple PowerLok/Amphenol Triple PowerLok Receptacle.SLDPRT

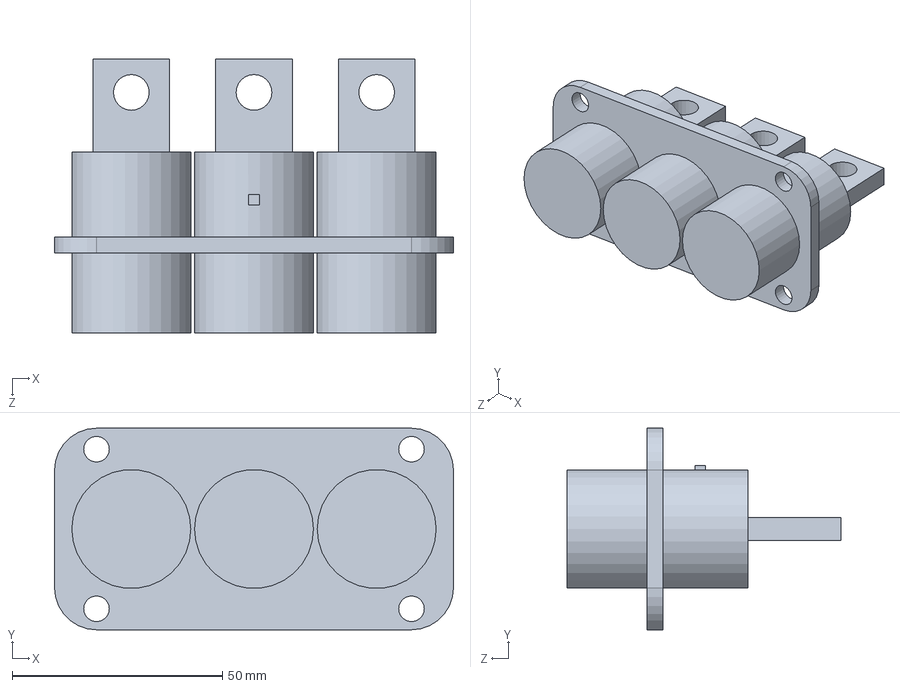
[picture p47: CAD file, 2016-11-20]
CURRENT.16-17/Accumulator/Connectors/Amphenol Triple PowerLok/Amphenol Triple PowerLok Receptacle.SLDPRT
95.0 x 48.0 x 65.3 mm
