BDR16/ARCHIBALD-the-battery-box/CURRENT.16-17/Accumulator/HV Control/Bus Bars/HV Fuse to Positive AIR.SLDPRT

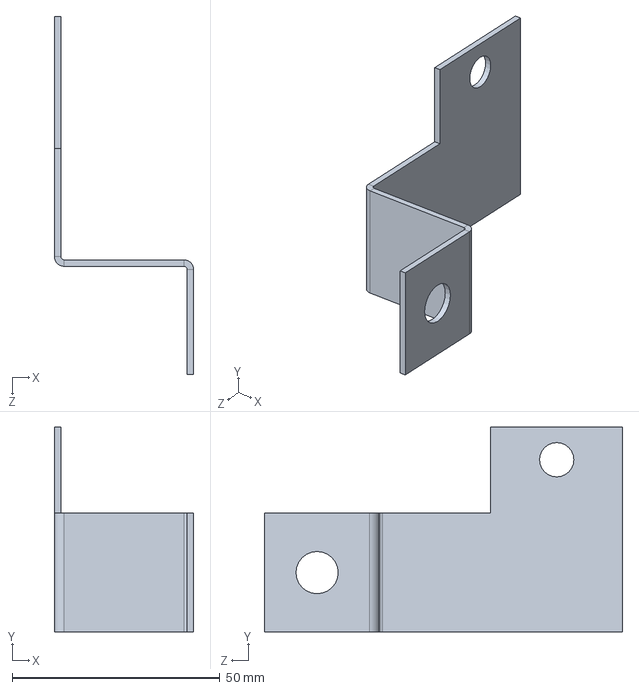
[picture p48: CAD file, 2016-11-20]
CURRENT.16-17/Accumulator/HV Control/Bus Bars/HV Fuse to Positive AIR.SLDPRT
33.5 x 49.3 x 86.2 mm
