BDR16/ARCHIBALD-the-battery-box/CURRENT.16-17/Accumulator/HV Control/High Voltage Disconnect.SLDPRT

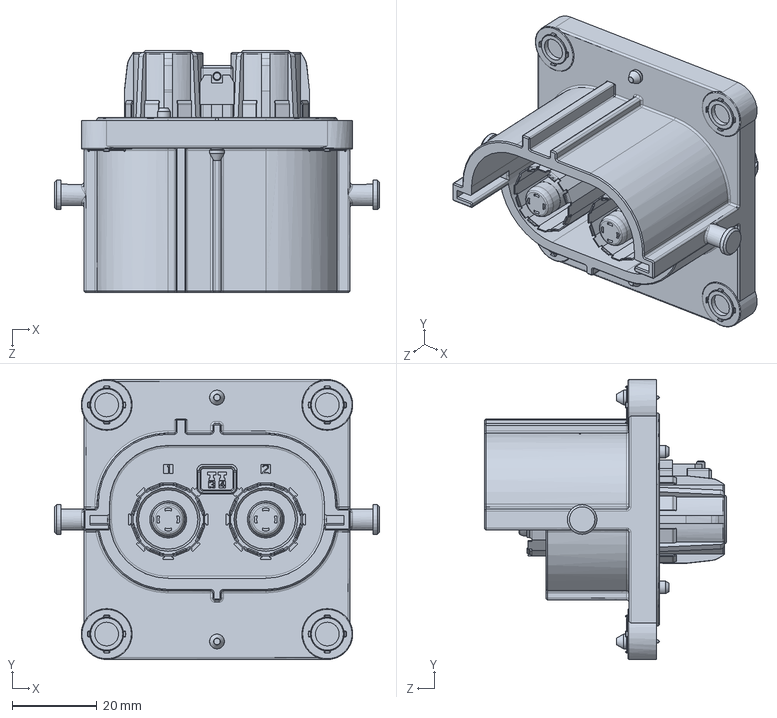
[picture p49: CAD file, 2016-11-20]
CURRENT.16-17/Accumulator/HV Control/High Voltage Disconnect.SLDPRT
76.6 x 66.0 x 57.0 mm
