BDR16/ARCHIBALD-the-battery-box/CURRENT.16-17/Accumulator/HV Control/HV Fusing/HV Fuseholder.SLDPRT

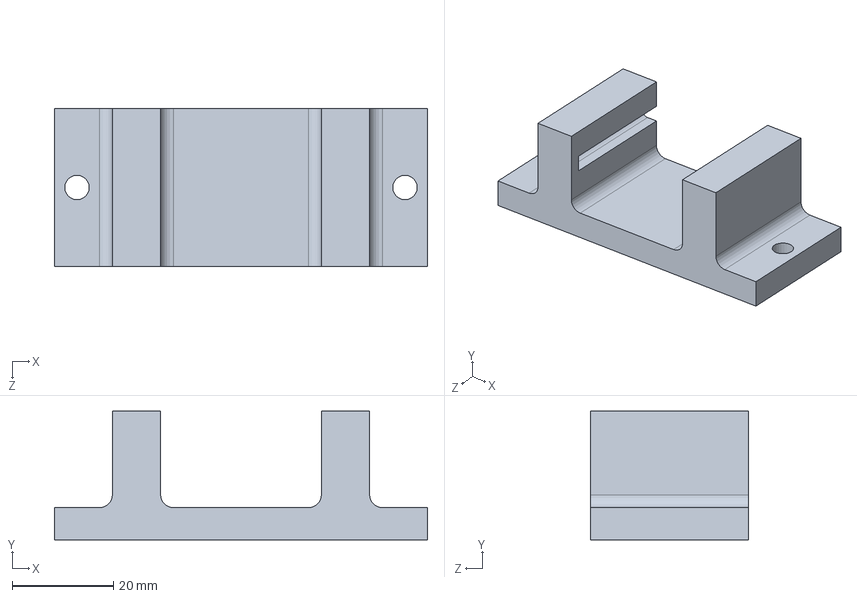
[picture p50: CAD file, 2016-11-20]
CURRENT.16-17/Accumulator/HV Control/HV Fusing/HV Fuseholder.SLDPRT
73.7 x 25.4 x 31.1 mm
