BDR16/ARCHIBALD-the-battery-box/CURRENT.16-17/Accumulator/Motor Controller/Motor Controller Board/HV Board.SLDPRT

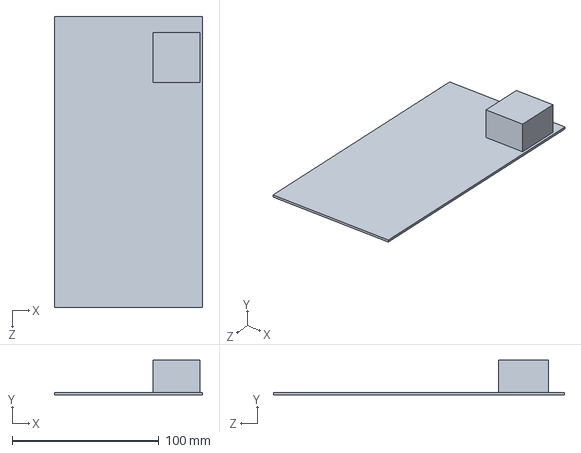
[picture p51: CAD file, 2016-11-20]
CURRENT.16-17/Accumulator/Motor Controller/Motor Controller Board/HV Board.SLDPRT
101.0 x 23.6 x 198.0 mm
