BDR16/ARCHIBALD-the-battery-box/CURRENT.16-17/Accumulator/Stacks/Cells/Cell Tab Config B Positive End.SLDPRT

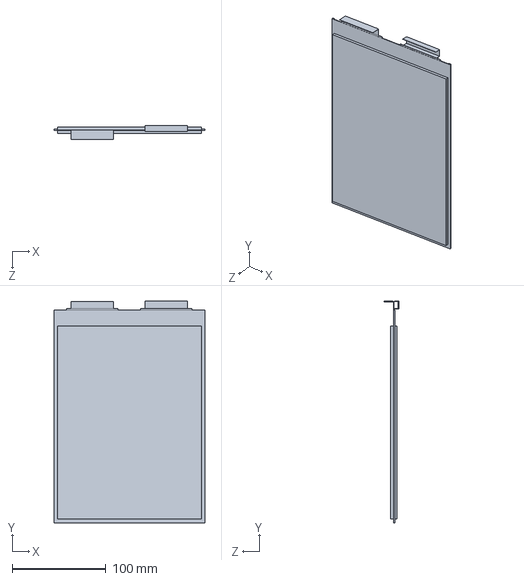
[picture p52: CAD file, 2016-11-20]
CURRENT.16-17/Accumulator/Stacks/Cells/Cell Tab Config B Positive End.SLDPRT
160.6 x 236.9 x 15.0 mm
