BDR16/ARCHIBALD-the-battery-box/CURRENT.16-17/Accumulator/Stacks/Stack Parts/Expansion Limiter/Odd Threaded Rod.SLDPRT

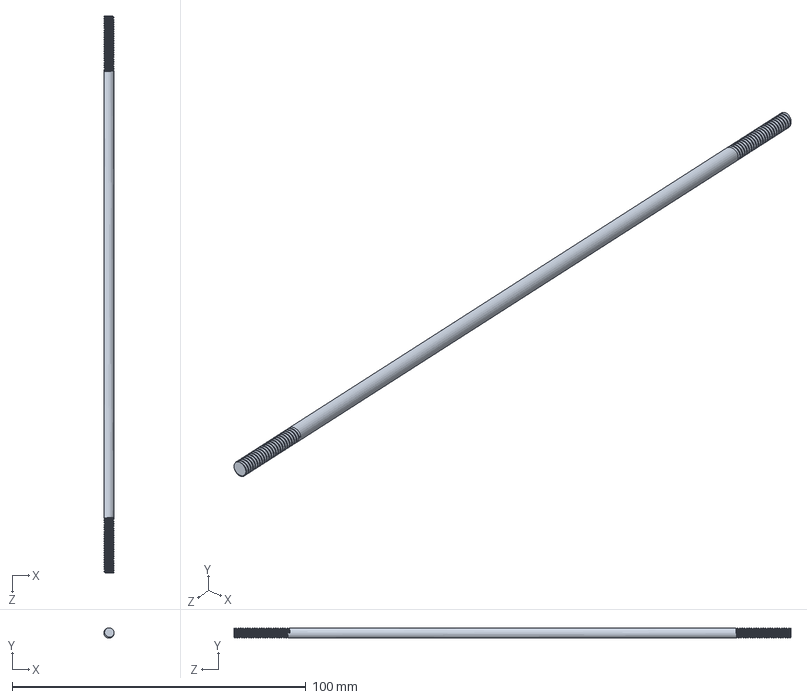
[picture p53: CAD file, 2016-11-20]
CURRENT.16-17/Accumulator/Stacks/Stack Parts/Expansion Limiter/Odd Threaded Rod.SLDPRT
3.51 x 3.51 x 189.6 mm
