BDR16/ARCHIBALD-the-battery-box/CURRENT.16-17/Accumulator/Stacks/Stack Parts/Insulation Film/Insulation Film Half.SLDPRT

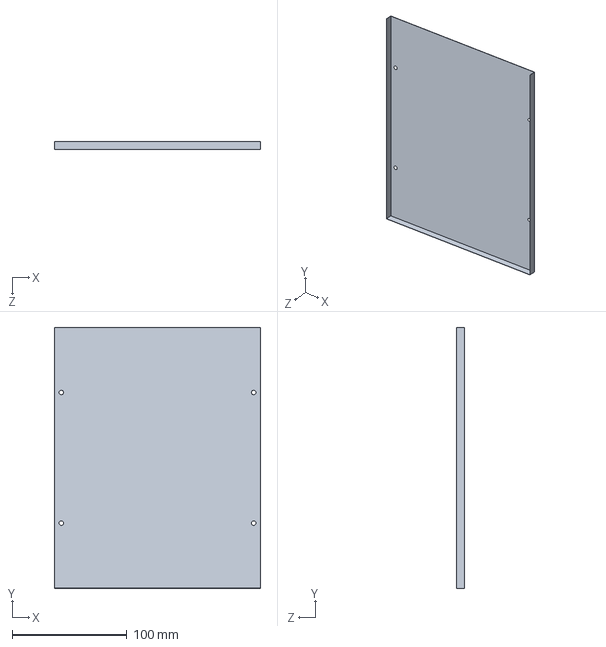
[picture p54: CAD file, 2016-11-20]
CURRENT.16-17/Accumulator/Stacks/Stack Parts/Insulation Film/Insulation Film Half.SLDPRT
179.7 x 227.2 x 7.27 mm
