BDR16/ARCHIBALD-the-battery-box/CURRENT.16-17/Accumulator/Stacks/Stack Parts/Repeating Frame/Repeating Frame Inner.SLDPRT

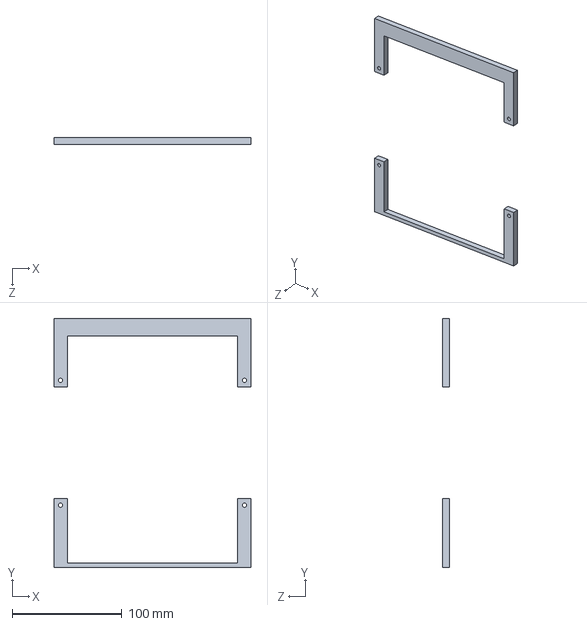
[picture p55: CAD file, 2016-11-20]
CURRENT.16-17/Accumulator/Stacks/Stack Parts/Repeating Frame/Repeating Frame Inner.SLDPRT
179.3 x 226.7 x 6.35 mm
