BDR16/ARCHIBALD-the-battery-box/CURRENT.16-17/Accumulator/Stacks/Stack Parts/Tab Cover/Tab Cover Odd.SLDPRT

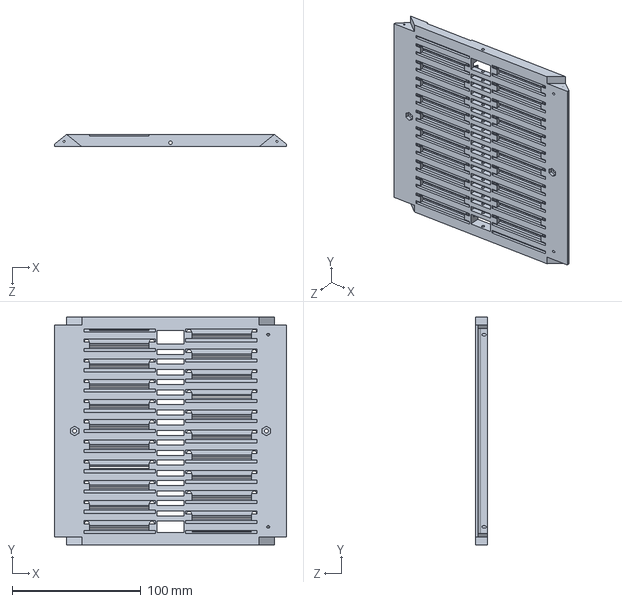
[picture p56: CAD file, 2016-11-20]
CURRENT.16-17/Accumulator/Stacks/Stack Parts/Tab Cover/Tab Cover Odd.SLDPRT
180.0 x 176.9 x 9.53 mm
