BDR16/ARCHIBALD-the-battery-box/CURRENT.16-17/Accumulator/Stacks/Thermal Simulation/Solidworks Model/Pouch.SLDPRT

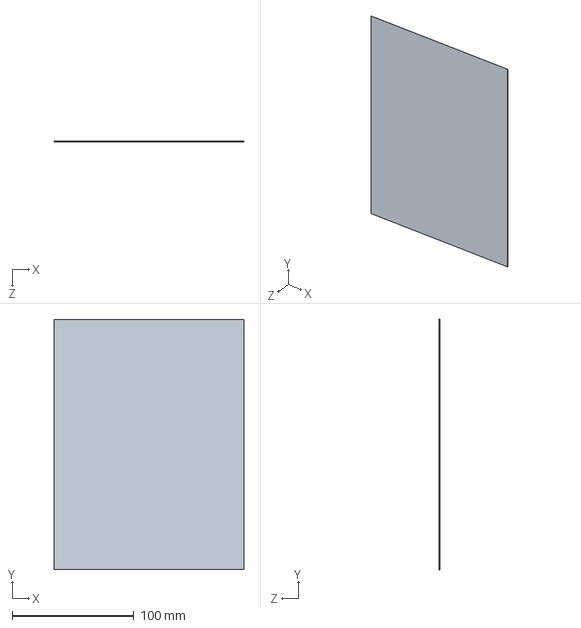
[picture p57: CAD file, 2016-11-20]
CURRENT.16-17/Accumulator/Stacks/Thermal Simulation/Solidworks Model/Pouch.SLDPRT
156.1 x 205.5 x 0.112 mm
