BDR16/ARCHIBALD-the-battery-box/CURRENT.16-17/Accumulator/Water Block/Pipe Press Test.SLDPRT

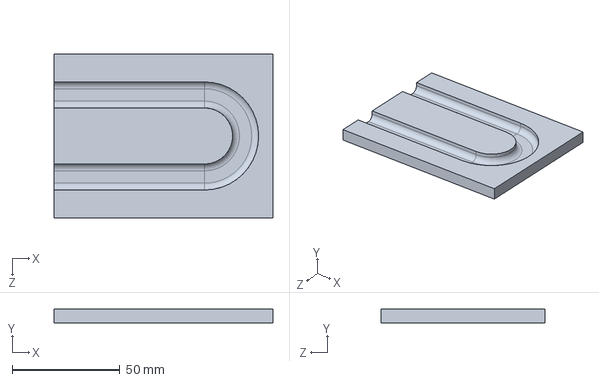
[picture p58: CAD file, 2016-11-20]
CURRENT.16-17/Accumulator/Water Block/Pipe Press Test.SLDPRT
101.6 x 6.35 x 76.2 mm
