BDR16/ARCHIBALD-the-battery-box/new.16-17/AccumulatorDesigns_12-18/Cell_B_End.sldprt

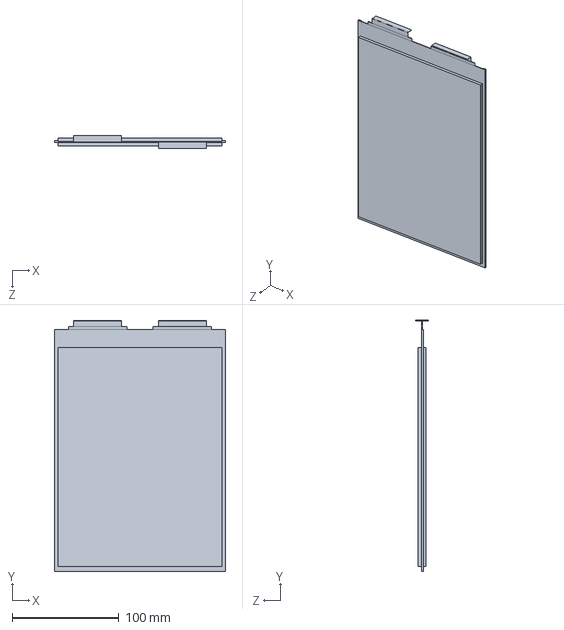
[picture p59: CAD file, 2016-12-18]
new.16-17/AccumulatorDesigns_12-18/Cell_B_End.sldprt
160.6 x 235.4 x 12.0 mm
