BDR16/ARCHIBALD-the-battery-box/new.16-17/Aydin_boxmodulefit.SLDPRT

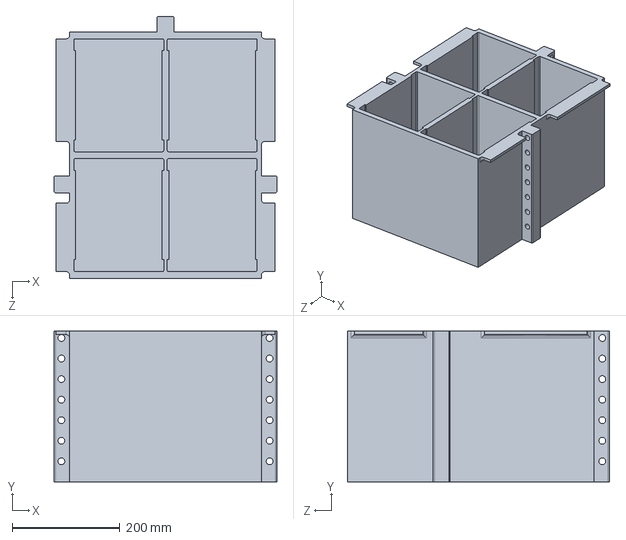
[picture p60: CAD file, 2016-12-18]
new.16-17/Aydin_boxmodulefit.SLDPRT
412.8 x 279.4 x 485.8 mm
