BDR16/ARCHIBALD-the-battery-box/CURRENT.16-17/Accumulator/Accumulator Box HV HC Panel CAM.SLDPRT

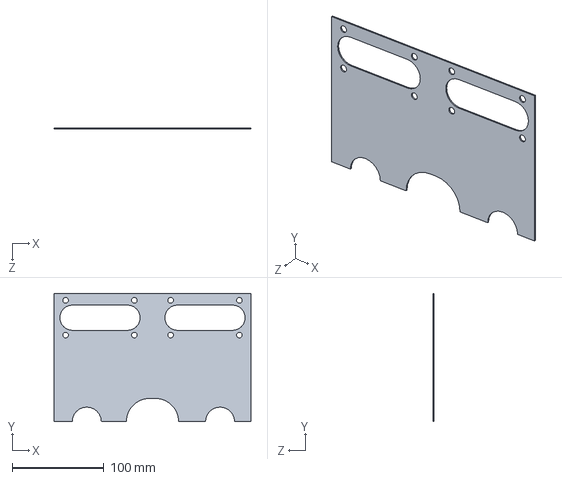
[picture p61: CAD file, 2016-11-20]
CURRENT.16-17/Accumulator/Accumulator Box HV HC Panel CAM.SLDPRT
215.0 x 140.0 x 1.24 mm
