BDR16/ARCHIBALD-the-battery-box/CURRENT.16-17/Accumulator/Charging/Charging Box.SLDPRT

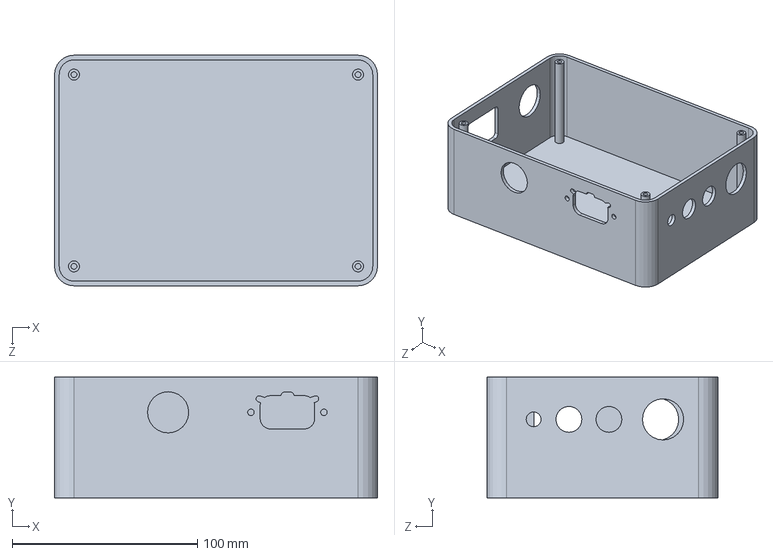
[picture p62: CAD file, 2016-11-20]
CURRENT.16-17/Accumulator/Charging/Charging Box.SLDPRT
174.3 x 65.3 x 124.5 mm
