BDR16/ARCHIBALD-the-battery-box/CURRENT.16-17/Accumulator/Covers/Top Cover.SLDPRT

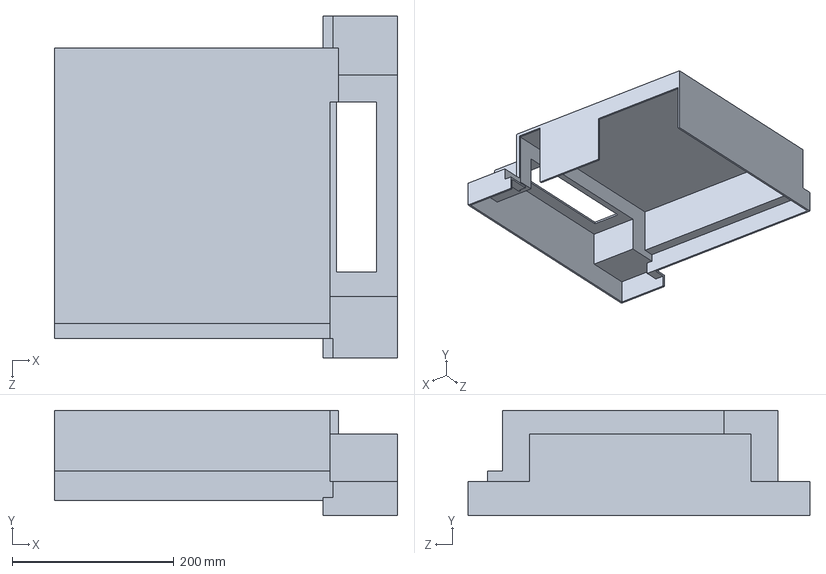
[picture p63: CAD file, 2016-11-20]
CURRENT.16-17/Accumulator/Covers/Top Cover.SLDPRT
423.5 x 130.2 x 422.3 mm
