BDR16/ARCHIBALD-the-battery-box/CURRENT.16-17/Accumulator/HV Control/Bus Bars/MC Negative.SLDPRT

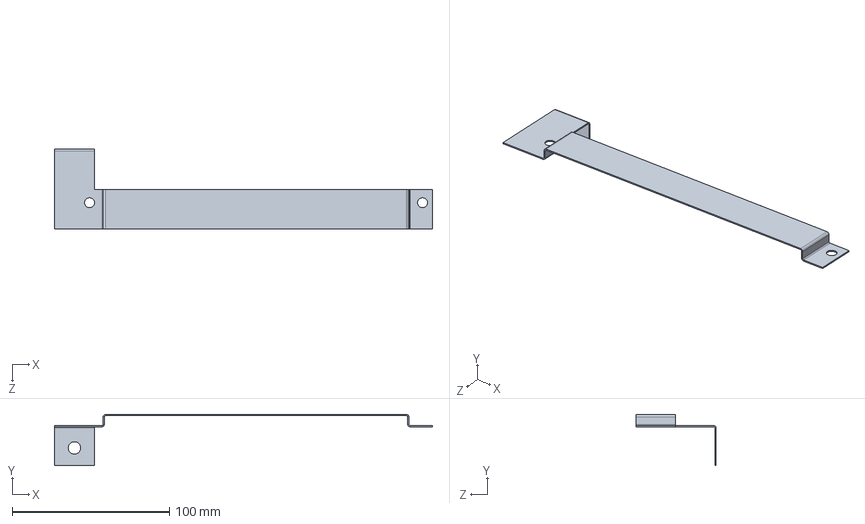
[picture p64: CAD file, 2016-11-20]
CURRENT.16-17/Accumulator/HV Control/Bus Bars/MC Negative.SLDPRT
240.7 x 32.5 x 51.2 mm
