BDR16/ARCHIBALD-the-battery-box/CURRENT.16-17/Accumulator/Motor Controller/Motor Controller Board/Control Board.SLDPRT

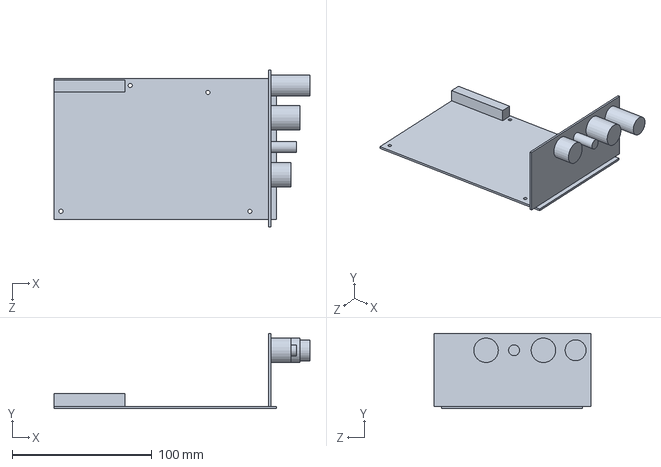
[picture p65: CAD file, 2016-11-20]
CURRENT.16-17/Accumulator/Motor Controller/Motor Controller Board/Control Board.SLDPRT
183.0 x 53.6 x 112.2 mm
