BDR16/ARCHIBALD-the-battery-box/CURRENT.16-17/Accumulator/Motor Controller/Right Side End Bus Bar.SLDPRT

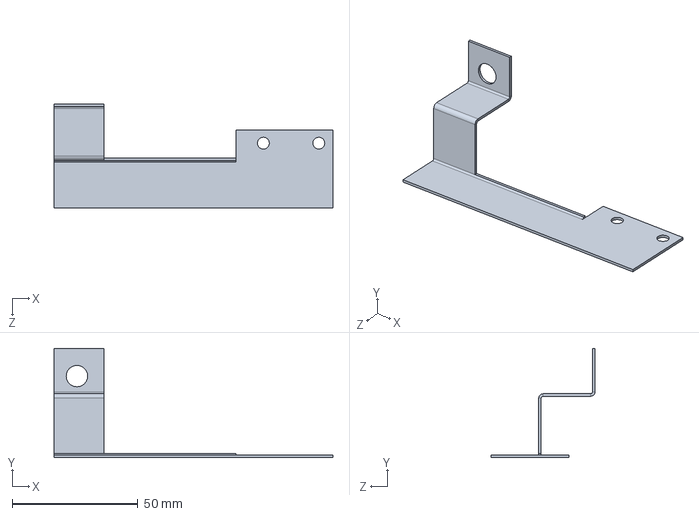
[picture p66: CAD file, 2016-11-20]
CURRENT.16-17/Accumulator/Motor Controller/Right Side End Bus Bar.SLDPRT
110.7 x 43.4 x 41.3 mm
