BDR16/ARCHIBALD-the-battery-box/CURRENT.16-17/Accumulator/Stacks/Cells/Cell.SLDPRT

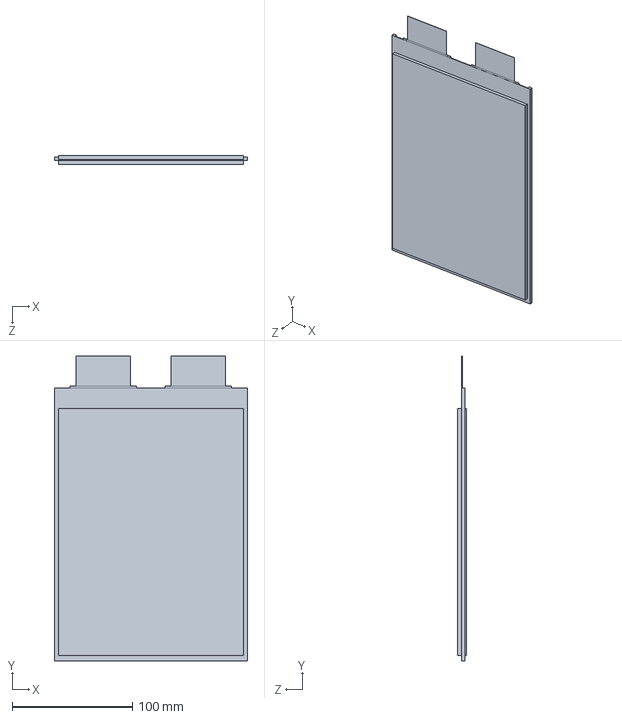
[picture p67: CAD file, 2016-11-20]
CURRENT.16-17/Accumulator/Stacks/Cells/Cell.SLDPRT
160.6 x 253.5 x 7.10 mm
