BDR16/ARCHIBALD-the-battery-box/CURRENT.16-17/Accumulator/Stacks/Stack Parts/Expansion Limiter/Cell Load Spreader.SLDPRT

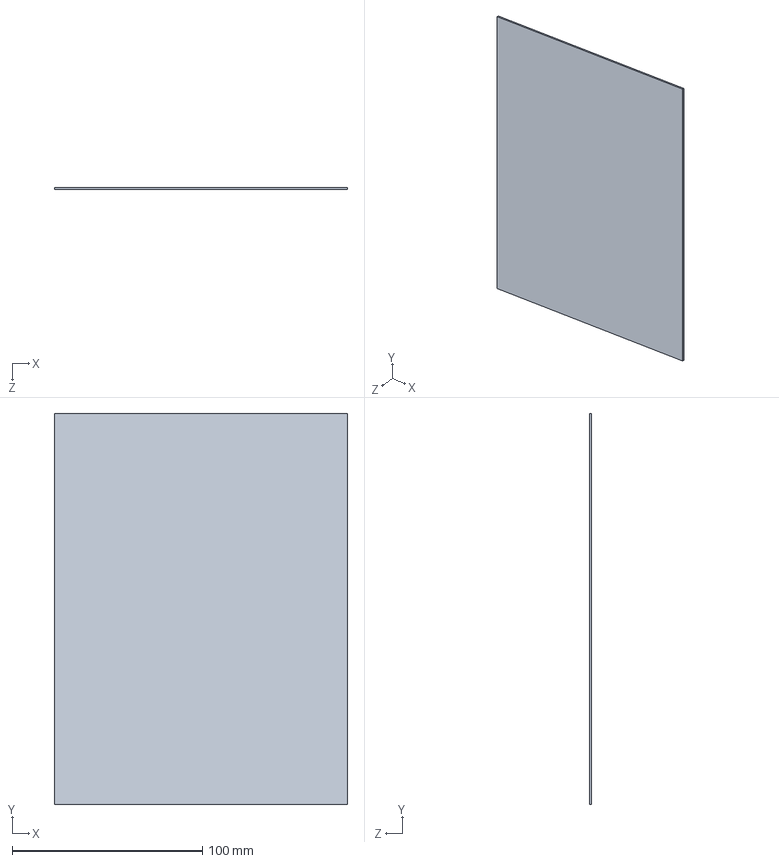
[picture p68: CAD file, 2016-11-20]
CURRENT.16-17/Accumulator/Stacks/Stack Parts/Expansion Limiter/Cell Load Spreader.SLDPRT
154.0 x 205.5 x 1.19 mm
