BDR16/ARCHIBALD-the-battery-box/CURRENT.16-17/Accumulator/Stacks/Stack Parts/Insulation Film/Insulation Film End.SLDPRT

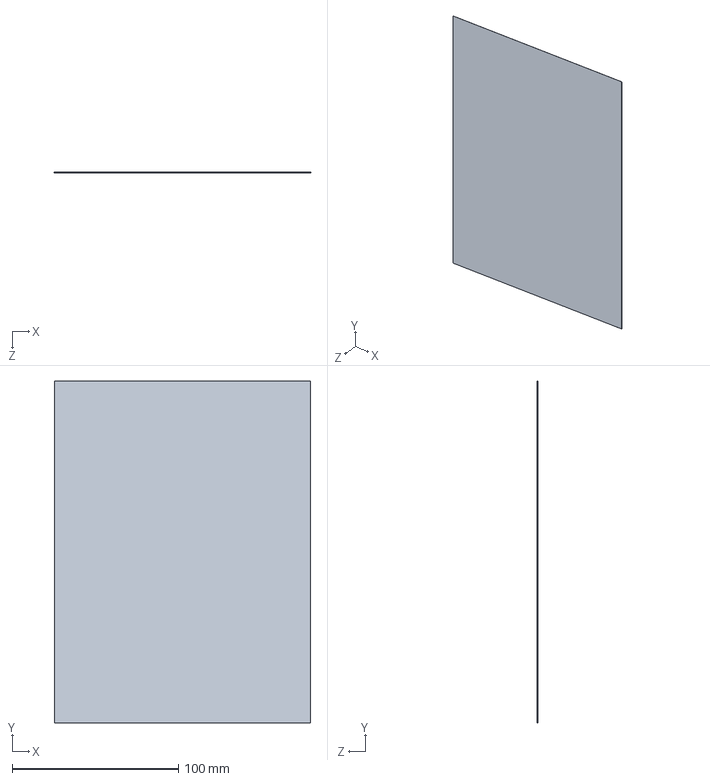
[picture p69: CAD file, 2016-11-20]
CURRENT.16-17/Accumulator/Stacks/Stack Parts/Insulation Film/Insulation Film End.SLDPRT
154.0 x 205.5 x 0.0686 mm
