BDR16/ARCHIBALD-the-battery-box/CURRENT.16-17/Accumulator/Stacks/Stack Parts/Tab Cover/ASTM D149 IEC 60243 Specimen.SLDPRT

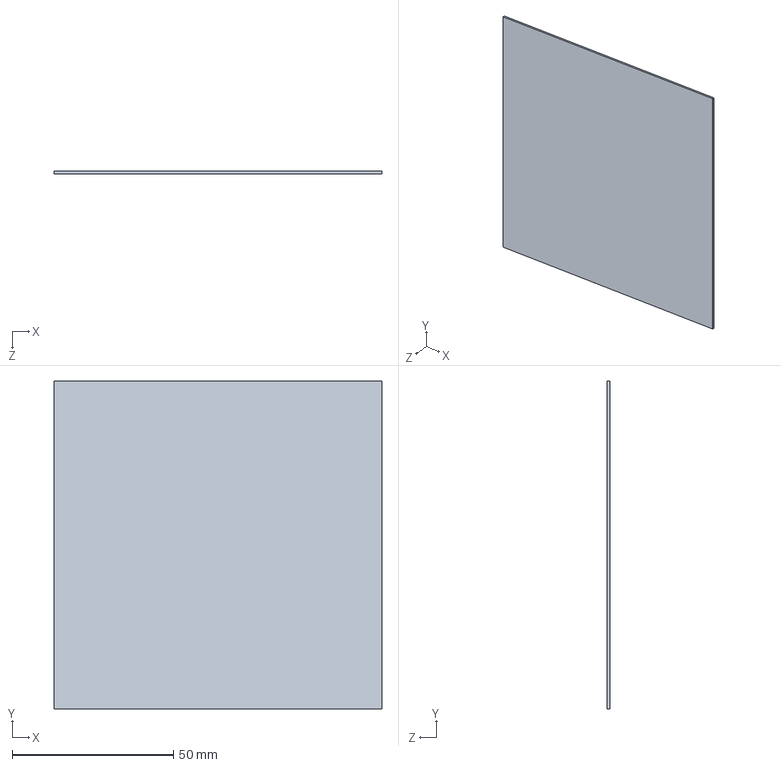
[picture p70: CAD file, 2016-11-20]
CURRENT.16-17/Accumulator/Stacks/Stack Parts/Tab Cover/ASTM D149 IEC 60243 Specimen.SLDPRT
101.6 x 101.6 x 0.794 mm
