BDR16/ARCHIBALD-the-battery-box/CURRENT.16-17/Accumulator/Stacks/Thermal Simulation/Solidworks Model/Positive Layer.SLDPRT

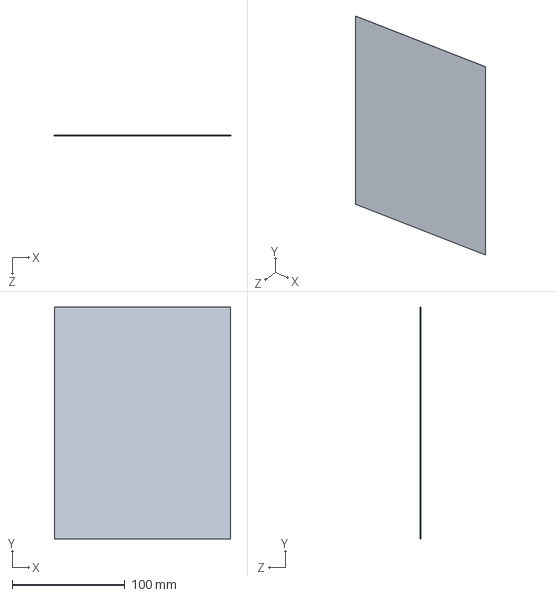
[picture p71: CAD file, 2016-11-20]
CURRENT.16-17/Accumulator/Stacks/Thermal Simulation/Solidworks Model/Positive Layer.SLDPRT
156.1 x 205.5 x 0.159 mm
