BDR16/ARCHIBALD-the-battery-box/new.16-17/AccumulatorDesigns_12-18/Connecting_Rod.SLDPRT

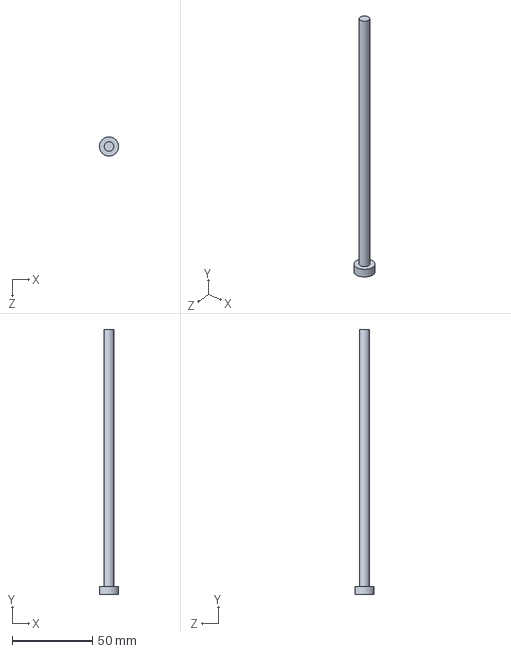
[picture p72: CAD file, 2016-12-18]
new.16-17/AccumulatorDesigns_12-18/Connecting_Rod.SLDPRT
12.0 x 165.0 x 12.0 mm
