BDR16/ARCHIBALD-the-battery-box/CURRENT.16-17/Accumulator/Accumulator Box.SLDPRT

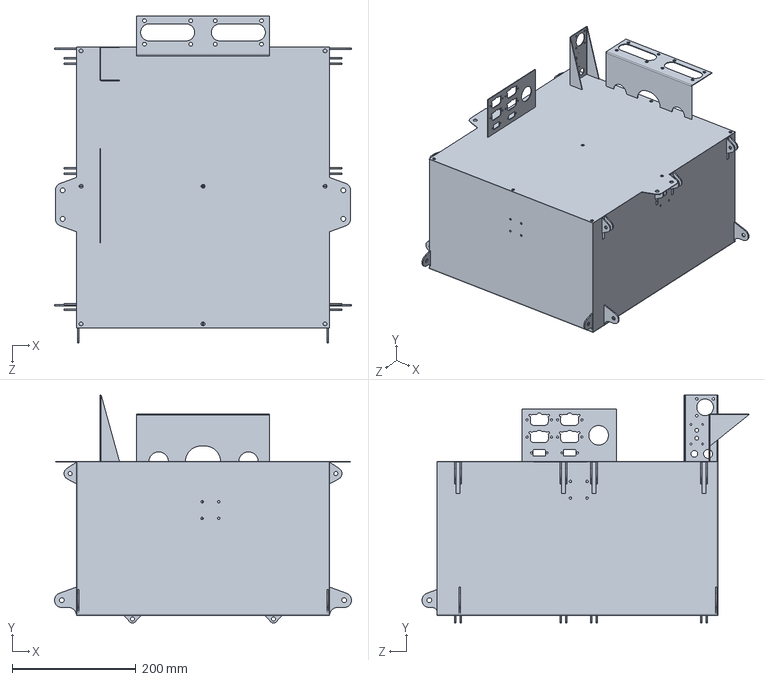
[picture p73: CAD file, 2016-11-20]
CURRENT.16-17/Accumulator/Accumulator Box.SLDPRT
481.0 x 369.1 x 529.5 mm
