BDR16/ARCHIBALD-the-battery-box/CURRENT.16-17/Accumulator/HV Control/Bus Bars/HVD to Negative Stack.SLDPRT

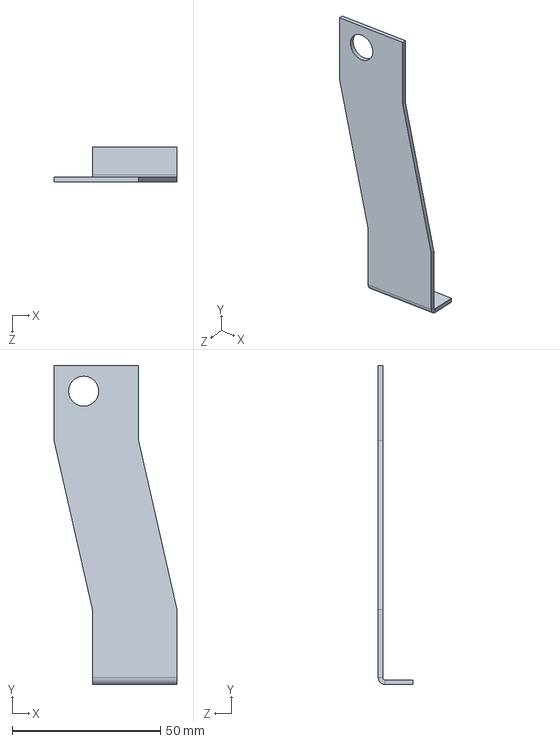
[picture p74: CAD file, 2016-11-20]
CURRENT.16-17/Accumulator/HV Control/Bus Bars/HVD to Negative Stack.SLDPRT
41.5 x 107.7 x 11.7 mm
