BDR16/ARCHIBALD-the-battery-box/CURRENT.16-17/Accumulator/HV Control/End Middle Bus Bar.SLDPRT

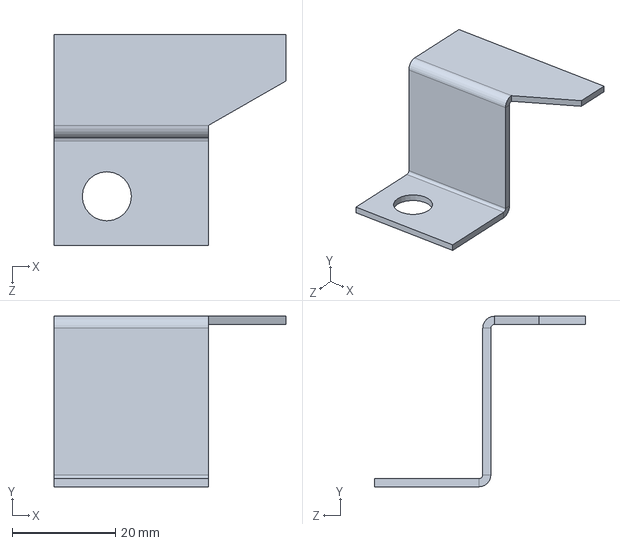
[picture p75: CAD file, 2016-11-20]
CURRENT.16-17/Accumulator/HV Control/End Middle Bus Bar.SLDPRT
45.0 x 33.1 x 40.9 mm
