BDR16/ARCHIBALD-the-battery-box/CURRENT.16-17/Accumulator/HV Control/HV Fusing/HV Fuseholder Plate.SLDPRT

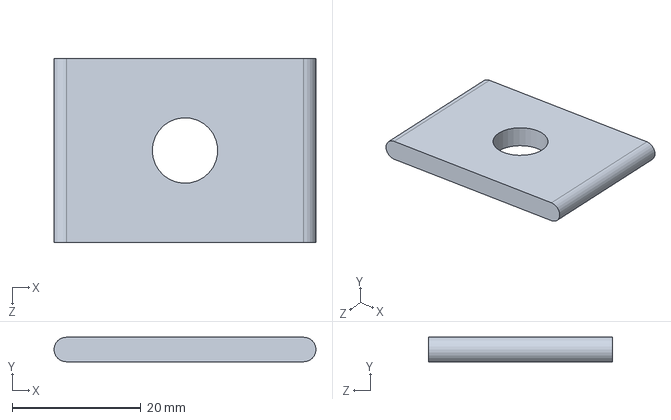
[picture p76: CAD file, 2016-11-20]
CURRENT.16-17/Accumulator/HV Control/HV Fusing/HV Fuseholder Plate.SLDPRT
40.6 x 3.81 x 28.6 mm
