BDR16/ARCHIBALD-the-battery-box/CURRENT.16-17/Accumulator/Motor Controller/Motor Controller Board/Current Shunt Tab.SLDPRT

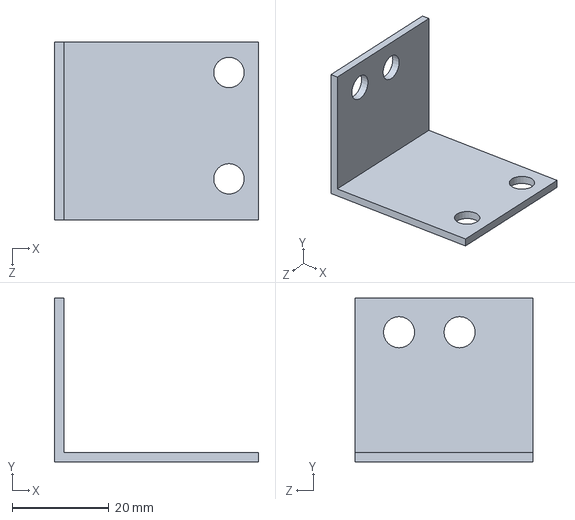
[picture p77: CAD file, 2016-11-20]
CURRENT.16-17/Accumulator/Motor Controller/Motor Controller Board/Current Shunt Tab.SLDPRT
42.2 x 33.9 x 36.8 mm
