BDR16/ARCHIBALD-the-battery-box/CURRENT.16-17/Accumulator/Motor Controller/Pfisterer Elbow.SLDPRT

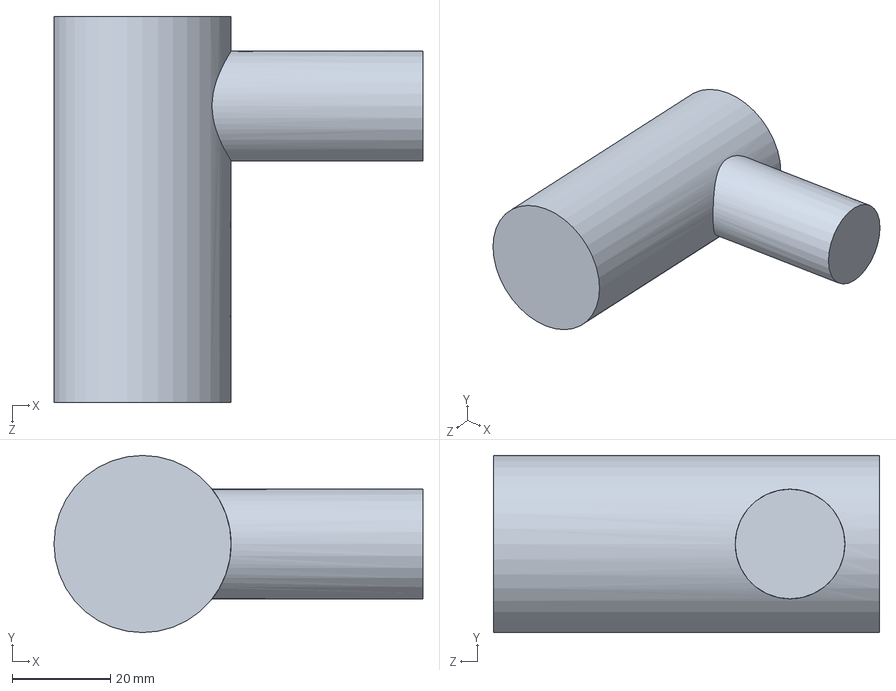
[picture p78: CAD file, 2016-11-20]
CURRENT.16-17/Accumulator/Motor Controller/Pfisterer Elbow.SLDPRT
75.0 x 36.0 x 78.5 mm
