BDR16/ARCHIBALD-the-battery-box/CURRENT.16-17/Accumulator/Stacks/Cells/Cell Tab Config A.SLDPRT

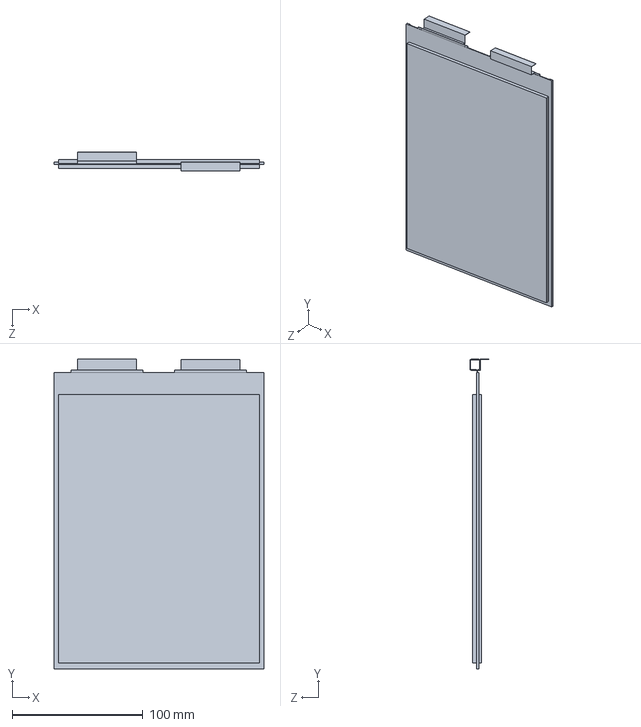
[picture p79: CAD file, 2016-11-20]
CURRENT.16-17/Accumulator/Stacks/Cells/Cell Tab Config A.SLDPRT
160.6 x 237.2 x 14.3 mm
