BDR16/ARCHIBALD-the-battery-box/CURRENT.16-17/Accumulator/Stacks/Stack Parts/Expansion Limiter/End Plate.SLDPRT

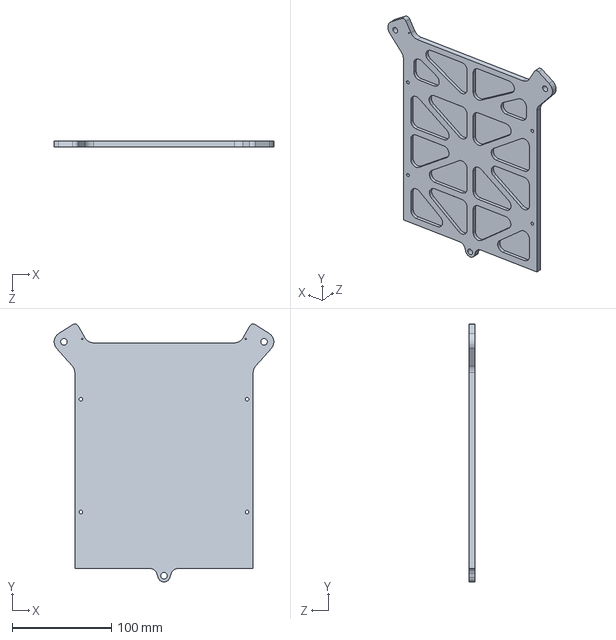
[picture p80: CAD file, 2016-11-20]
CURRENT.16-17/Accumulator/Stacks/Stack Parts/Expansion Limiter/End Plate.SLDPRT
221.6 x 260.0 x 6.35 mm
