BDR16/ARCHIBALD-the-battery-box/CURRENT.16-17/Accumulator/Stacks/Stack Parts/Insulation Film/Insulation Film Back.SLDPRT

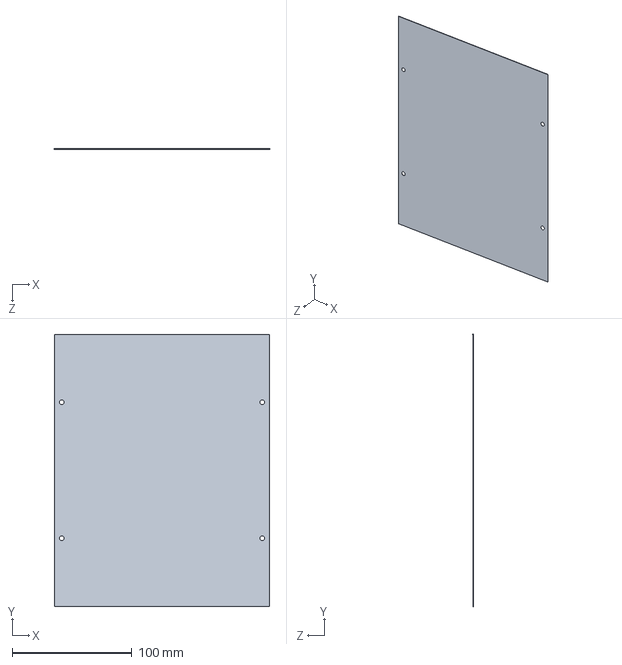
[picture p81: CAD file, 2016-11-20]
CURRENT.16-17/Accumulator/Stacks/Stack Parts/Insulation Film/Insulation Film Back.SLDPRT
179.7 x 227.3 x 0.358 mm
