BDR16/ARCHIBALD-the-battery-box/CURRENT.16-17/Accumulator/Stacks/Stack Parts/Tab Cover/UL94 Specimen.SLDPRT

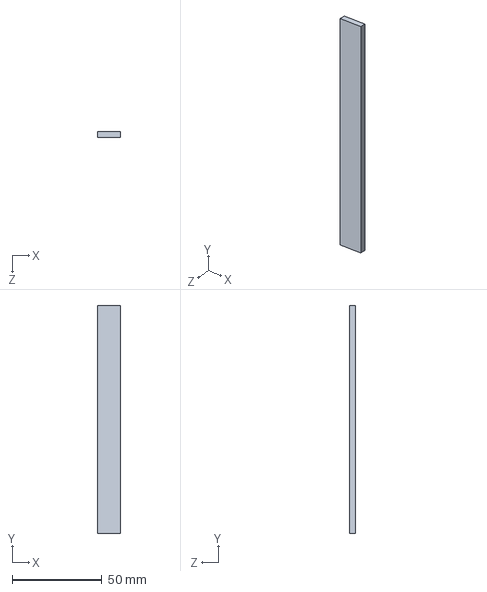
[picture p82: CAD file, 2016-11-20]
CURRENT.16-17/Accumulator/Stacks/Stack Parts/Tab Cover/UL94 Specimen.SLDPRT
12.7 x 127.0 x 3.17 mm
