BDR16/ARCHIBALD-the-battery-box/new.16-17/AccumulatorDesigns_12-18/Neoprene_Insulation_B.SLDPRT

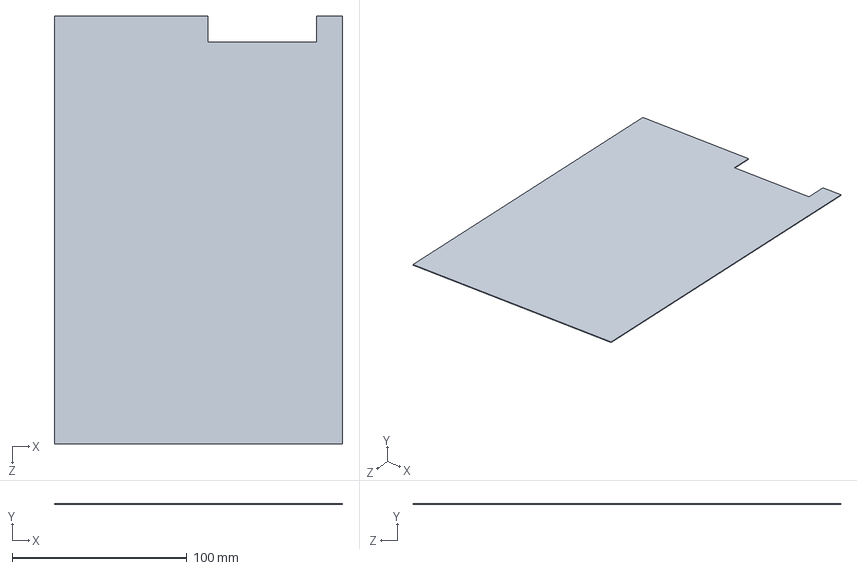
[picture p83: CAD file, 2016-12-18]
new.16-17/AccumulatorDesigns_12-18/Neoprene_Insulation_B.SLDPRT
165.0 x 0.5 x 245.0 mm
