BDR16/ARCHIBALD-the-battery-box/CURRENT.16-17/Accumulator/Covers/Back Cover.SLDPRT

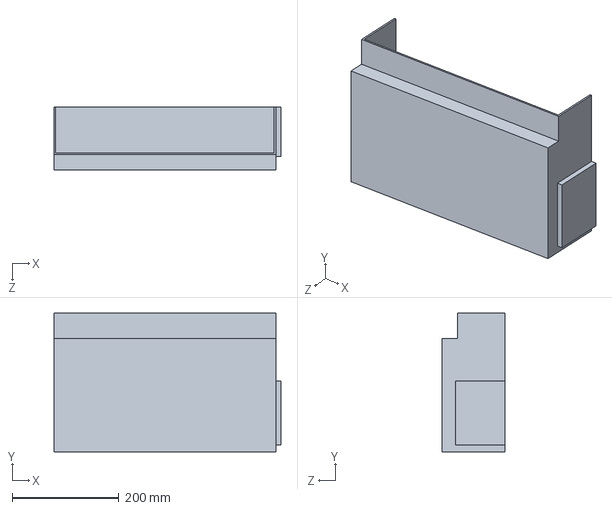
[picture p84: CAD file, 2016-11-20]
CURRENT.16-17/Accumulator/Covers/Back Cover.SLDPRT
425.5 x 260.4 x 117.5 mm
