BDR16/ARCHIBALD-the-battery-box/CURRENT.16-17/Accumulator/HV Control/Bus Bars/MC Positive.SLDPRT

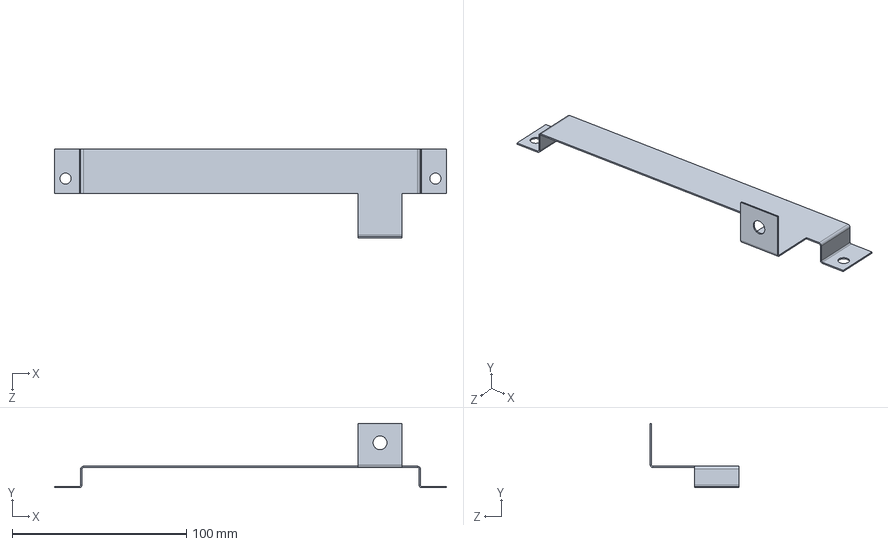
[picture p85: CAD file, 2016-11-20]
CURRENT.16-17/Accumulator/HV Control/Bus Bars/MC Positive.SLDPRT
224.7 x 36.9 x 50.8 mm
