BDR16/ARCHIBALD-the-battery-box/CURRENT.16-17/Accumulator/HV Control/End Lug Connector.SLDPRT

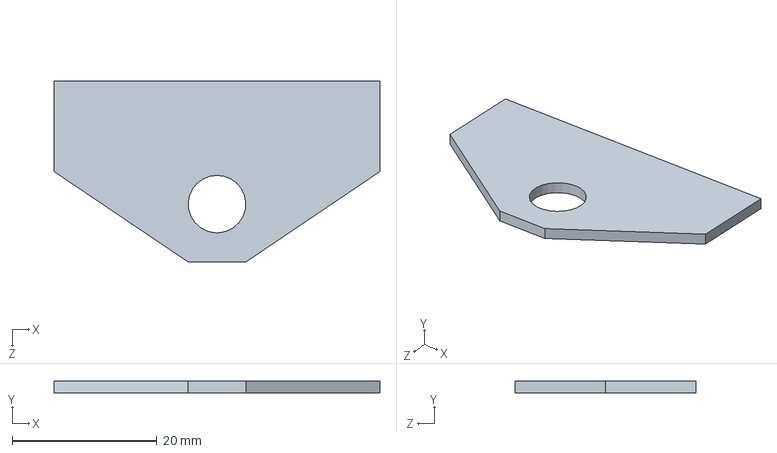
[picture p86: CAD file, 2016-11-20]
CURRENT.16-17/Accumulator/HV Control/End Lug Connector.SLDPRT
45.0 x 1.59 x 25.0 mm
