BDR16/ARCHIBALD-the-battery-box/CURRENT.16-17/Accumulator/Motor Controller/Motor Controller Board/IGBT.SLDPRT

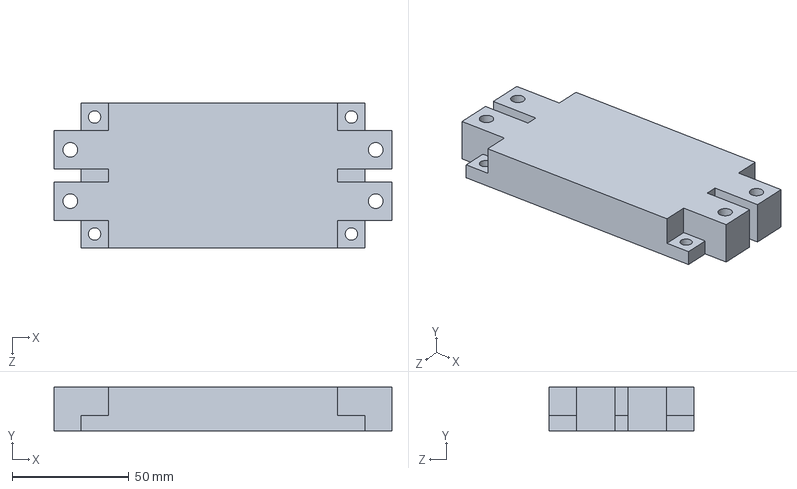
[picture p87: CAD file, 2016-11-20]
CURRENT.16-17/Accumulator/Motor Controller/Motor Controller Board/IGBT.SLDPRT
145.0 x 18.7 x 62.0 mm
