BDR16/ARCHIBALD-the-battery-box/CURRENT.16-17/Accumulator/Stacks/Stack Parts/Tab Cover/Tab Cover Sixer.SLDPRT

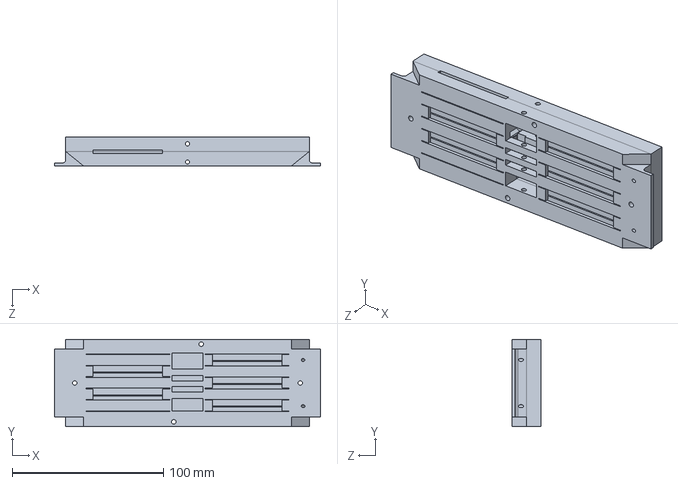
[picture p89: CAD file, 2016-11-20]
CURRENT.16-17/Accumulator/Stacks/Stack Parts/Tab Cover/Tab Cover Sixer.SLDPRT
176.0 x 57.9 x 19.1 mm
