BDR16/ARCHIBALD-the-battery-box/CURRENT.16-17/Accumulator/HV Control/Energy Meter.SLDPRT

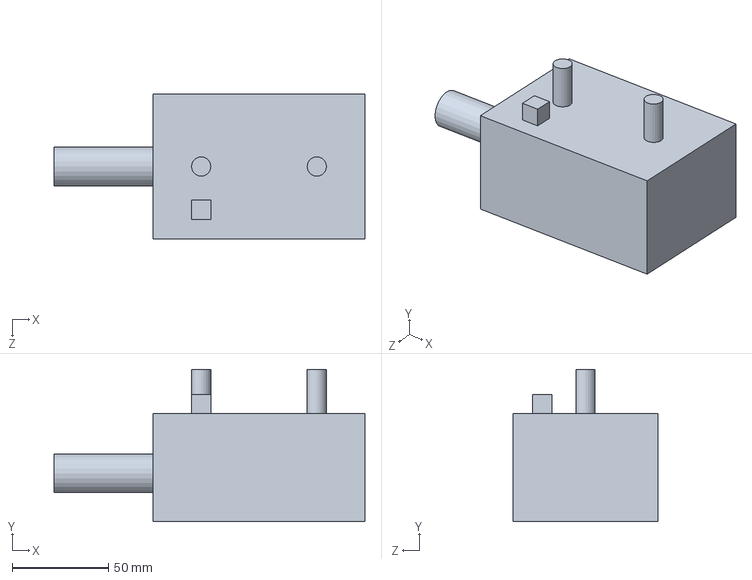
[picture p90: CAD file, 2016-11-20]
CURRENT.16-17/Accumulator/HV Control/Energy Meter.SLDPRT
161.4 x 79.0 x 75.0 mm
