BDR16/ARCHIBALD-the-battery-box/CURRENT.16-17/Accumulator/Motor Controller/Current Tab T.SLDPRT

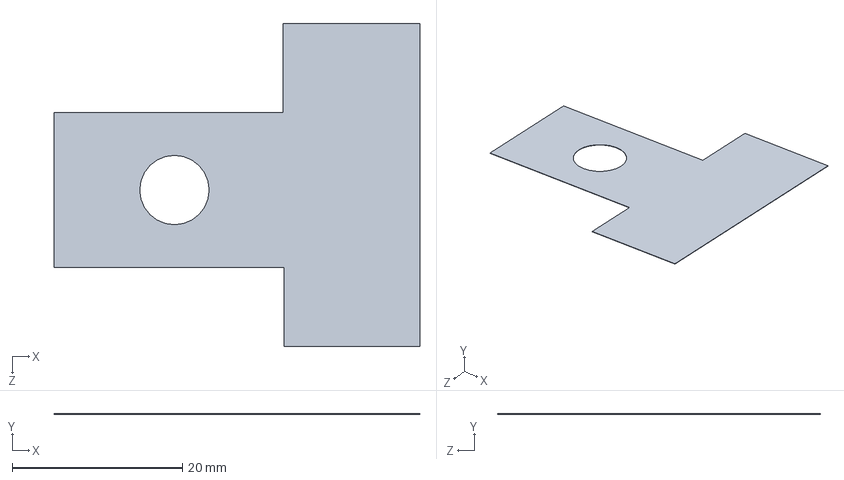
[picture p91: CAD file, 2016-11-20]
CURRENT.16-17/Accumulator/Motor Controller/Current Tab T.SLDPRT
43.0 x 0.0625 x 37.9 mm
