BDR16/ARCHIBALD-the-battery-box/CURRENT.16-17/Accumulator/Motor Controller/Motor Controller Board/Capacitor Board.SLDPRT

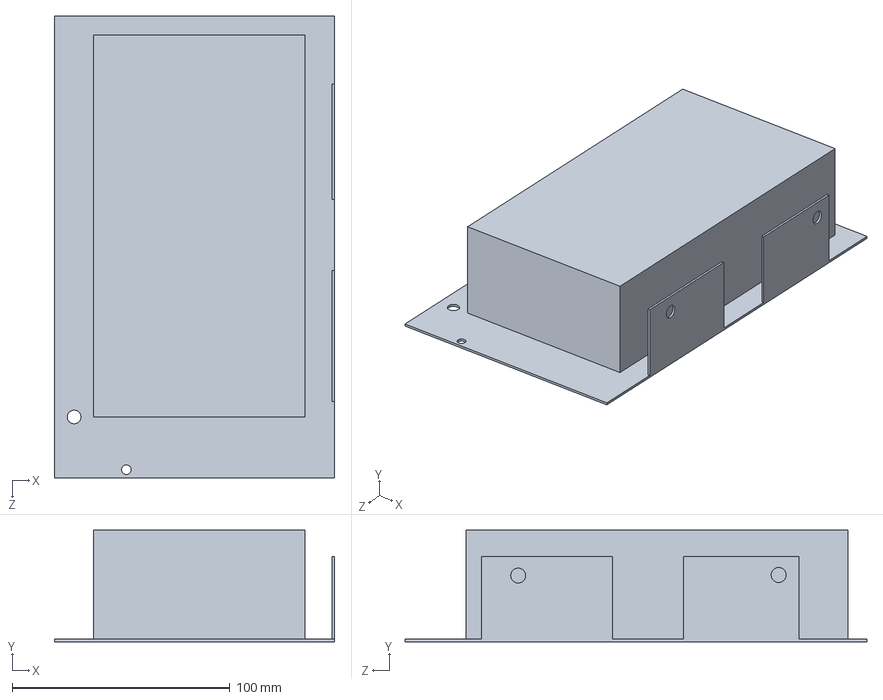
[picture p92: CAD file, 2016-11-20]
CURRENT.16-17/Accumulator/Motor Controller/Motor Controller Board/Capacitor Board.SLDPRT
128.5 x 51.2 x 212.0 mm
