BDR16/ARCHIBALD-the-battery-box/CURRENT.16-17/Accumulator/HV Control/IMD.SLDPRT

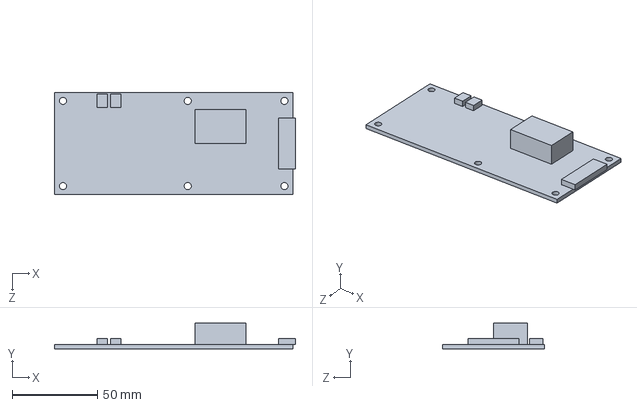
[picture p94: CAD file, 2016-11-20]
CURRENT.16-17/Accumulator/HV Control/IMD.SLDPRT
141.5 x 15.0 x 60.0 mm
