BDR16/ARCHIBALD-the-battery-box/CURRENT.16-17/Accumulator/Motor Controller/Current Shunt Cover.SLDPRT

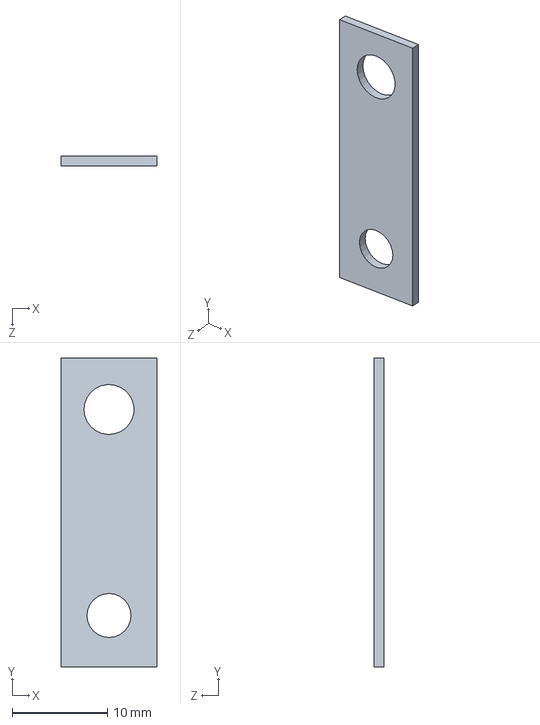
[picture p95: CAD file, 2016-11-20]
CURRENT.16-17/Accumulator/Motor Controller/Current Shunt Cover.SLDPRT
10.1 x 32.4 x 1.02 mm
