BDR16/ARCHIBALD-the-battery-box/new.16-17/AccumulatorDesigns_12-18/Spacer.SLDPRT

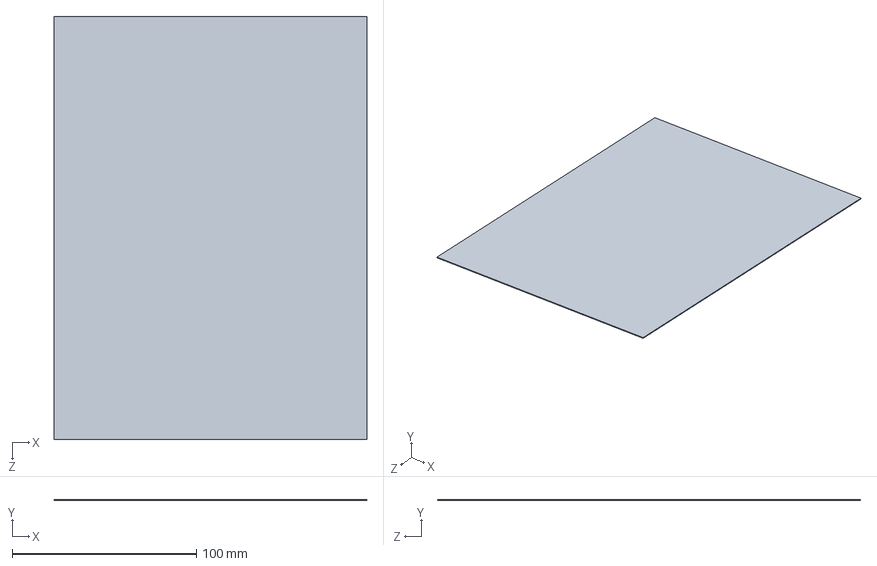
[picture p96: CAD file, 2016-12-18]
new.16-17/AccumulatorDesigns_12-18/Spacer.SLDPRT
170.0 x 0.535 x 230.0 mm
