BDR16/ARCHIBALD-the-battery-box/new.16-17/Rail.SLDPRT

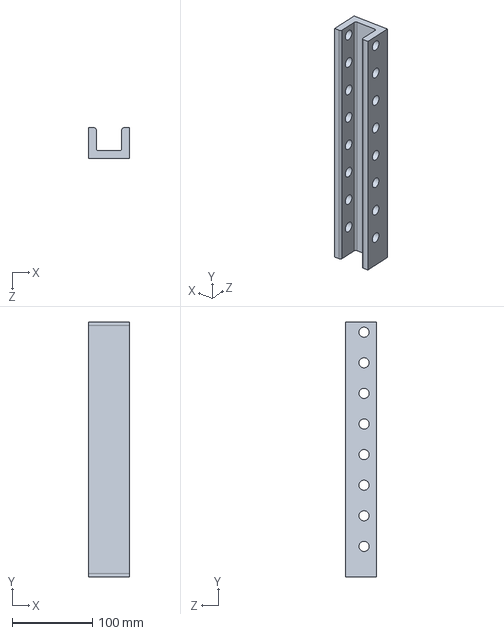
[picture p97: CAD file, 2016-12-18]
new.16-17/Rail.SLDPRT
50.8 x 317.5 x 38.1 mm
