BDR16/ARCHIBALD-the-battery-box/CURRENT.16-17/Accumulator/HV Control/Contactor.SLDPRT

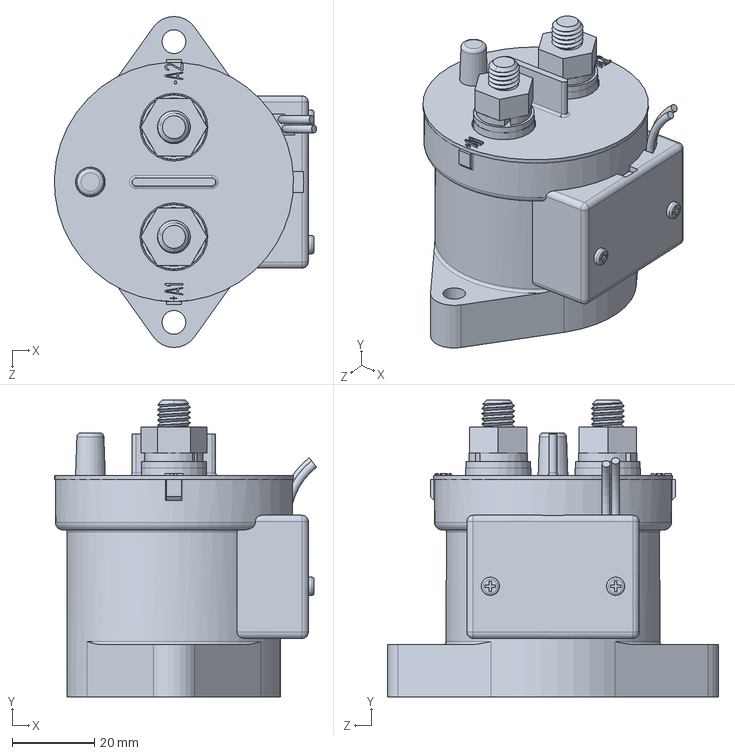
[picture p98: CAD file, 2016-11-20]
CURRENT.16-17/Accumulator/HV Control/Contactor.SLDPRT
63.8 x 72.2 x 80.5 mm
