BDR16/ARCHIBALD-the-battery-box/CURRENT.16-17/Accumulator/Motor Controller/Left Side End Bus Bar.SLDPRT

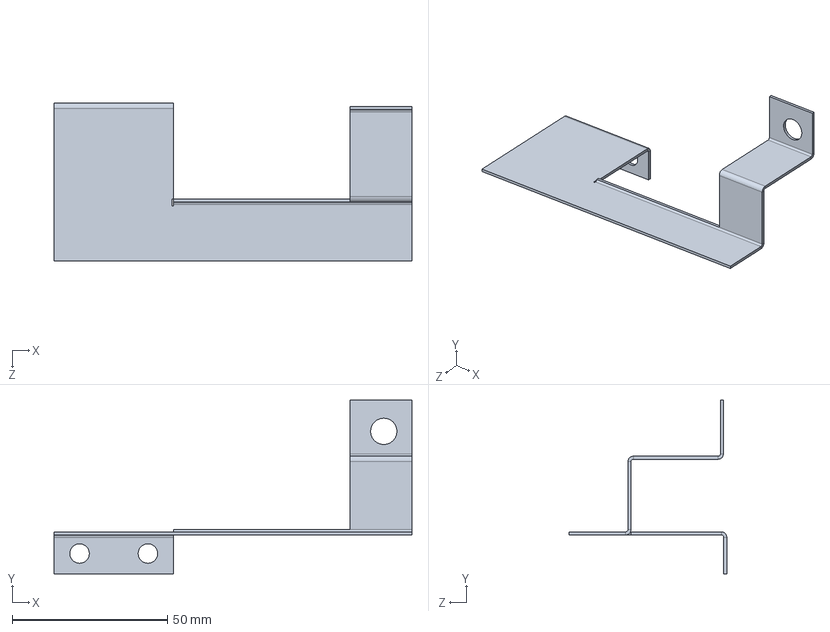
[picture p99: CAD file, 2016-11-20]
CURRENT.16-17/Accumulator/Motor Controller/Left Side End Bus Bar.SLDPRT
115.3 x 56.0 x 50.8 mm
