BDR16/ARCHIBALD-the-battery-box/new.16-17/AccumulatorDesigns_12-18/Heatsink.SLDPRT

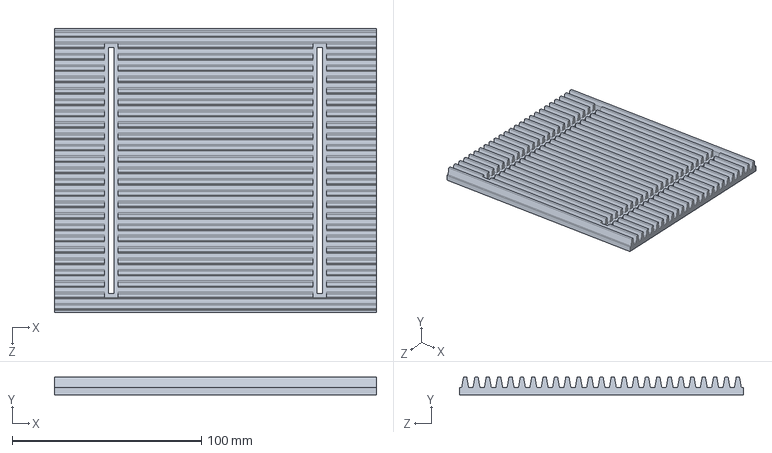
[picture p100: CAD file, 2016-12-18]
new.16-17/AccumulatorDesigns_12-18/Heatsink.SLDPRT
170.0 x 9.43 x 150.0 mm
