BDR16/ARCHIBALD-the-battery-box/CURRENT.16-17/Accumulator/HV Control/Precharge Relay.SLDPRT

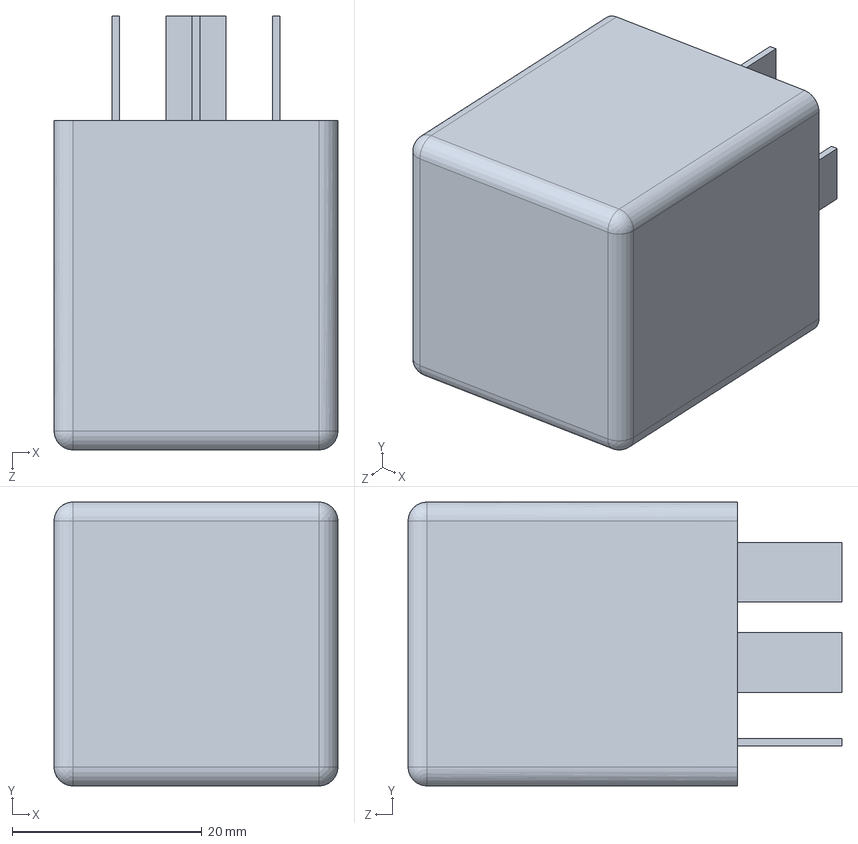
[picture p101: CAD file, 2016-11-20]
CURRENT.16-17/Accumulator/HV Control/Precharge Relay.SLDPRT
29.9 x 29.9 x 45.7 mm
