BDR16/ARCHIBALD-the-battery-box/CURRENT.16-17/Accumulator/Motor Controller/Bamocar Box.SLDPRT

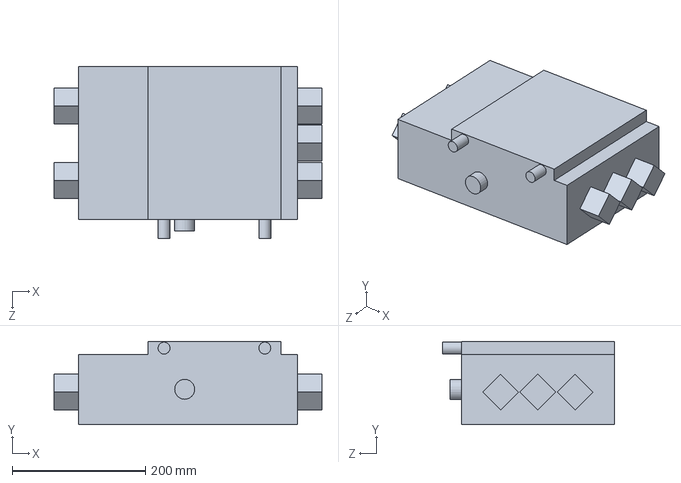
[picture p102: CAD file, 2016-11-20]
CURRENT.16-17/Accumulator/Motor Controller/Bamocar Box.SLDPRT
403.0 x 125.0 x 258.0 mm
