BDR16/ARCHIBALD-the-battery-box/new.16-17/AccumulatorDesigns/Copper_Divider.SLDPRT

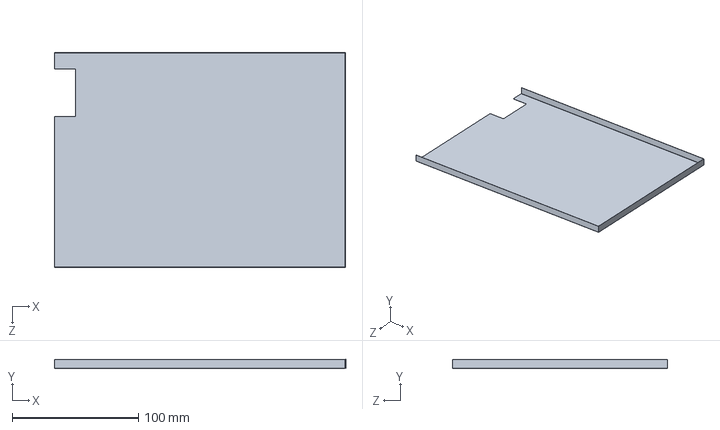
[picture p103: CAD file, 2016-12-13]
new.16-17/AccumulatorDesigns/Copper_Divider.SLDPRT
230.1 x 7.13 x 170.0 mm
