BDR16/ARCHIBALD-the-battery-box/new.16-17/AccumulatorDesigns_12-18/End_Plate.SLDPRT

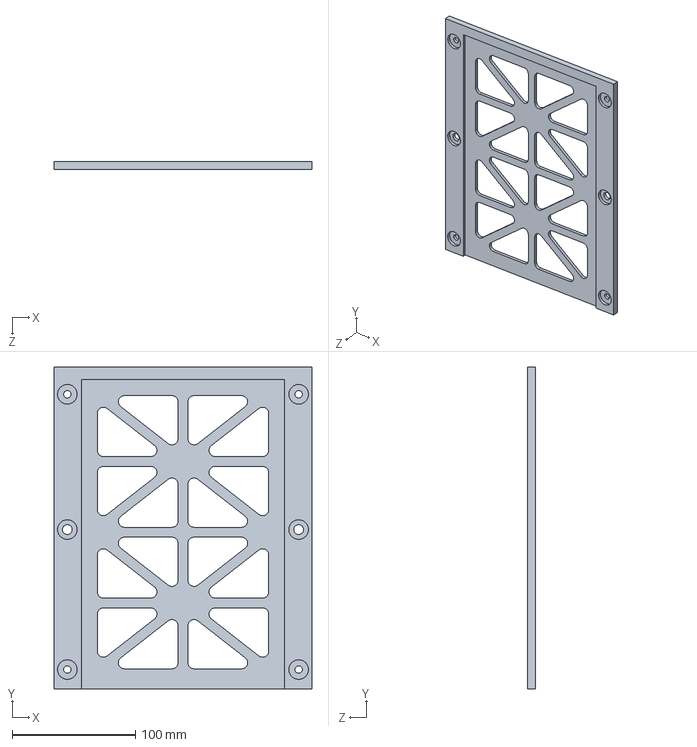
[picture p104: CAD file, 2016-12-18]
new.16-17/AccumulatorDesigns_12-18/End_Plate.SLDPRT
209.5 x 261.6 x 6.35 mm
