BDR16/ARCHIBALD-the-battery-box/new.16-17/Tall_Box.SLDPRT

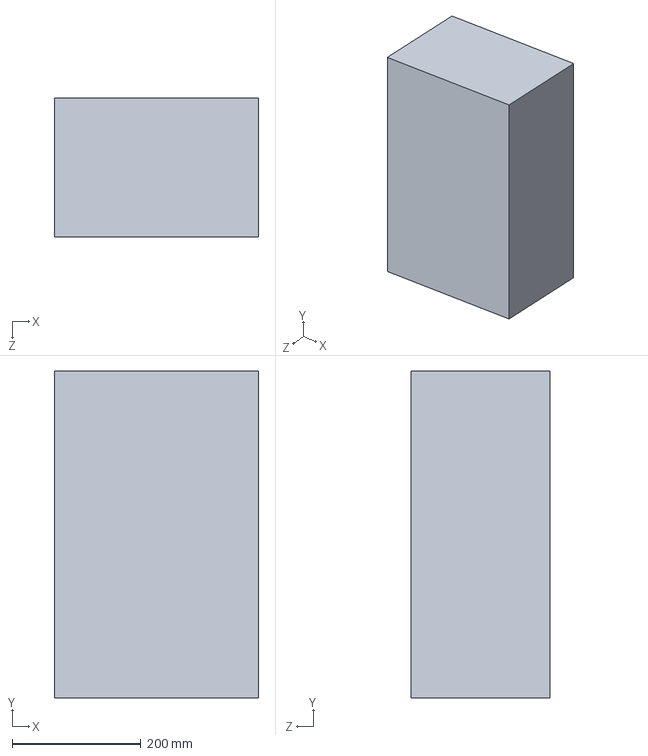
[picture p105: CAD file, 2016-12-09]
new.16-17/Tall_Box.SLDPRT
317.5 x 508.0 x 215.9 mm
