BDR16/ARCHIBALD-the-battery-box/CURRENT.16-17/Accumulator/Motor Controller/Motor Controller Standoff.SLDPRT

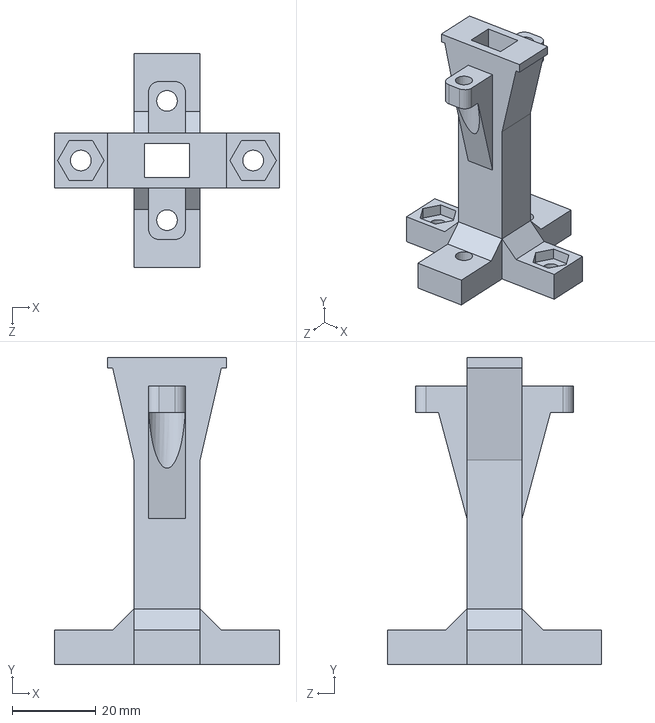
[picture p106: CAD file, 2016-11-20]
CURRENT.16-17/Accumulator/Motor Controller/Motor Controller Standoff.SLDPRT
54.0 x 73.5 x 51.3 mm
