BDR16/ARCHIBALD-the-battery-box/new.16-17/AccumulatorDesigns_12-18/Cell_A_End.SLDPRT

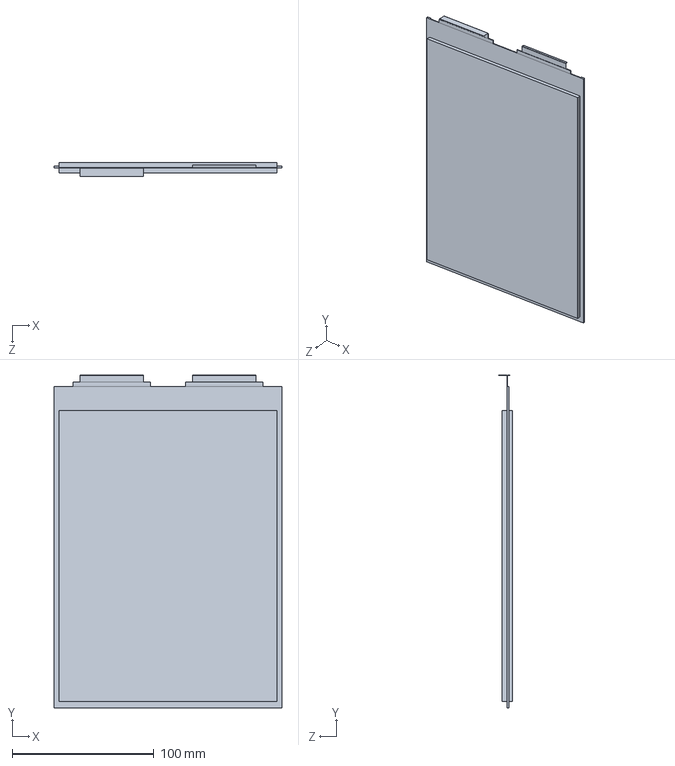
[picture p107: CAD file, 2016-12-18]
new.16-17/AccumulatorDesigns_12-18/Cell_A_End.SLDPRT
160.6 x 235.0 x 9.55 mm
