BDR16/ARCHIBALD-the-battery-box/new.16-17/Short_Box.SLDPRT

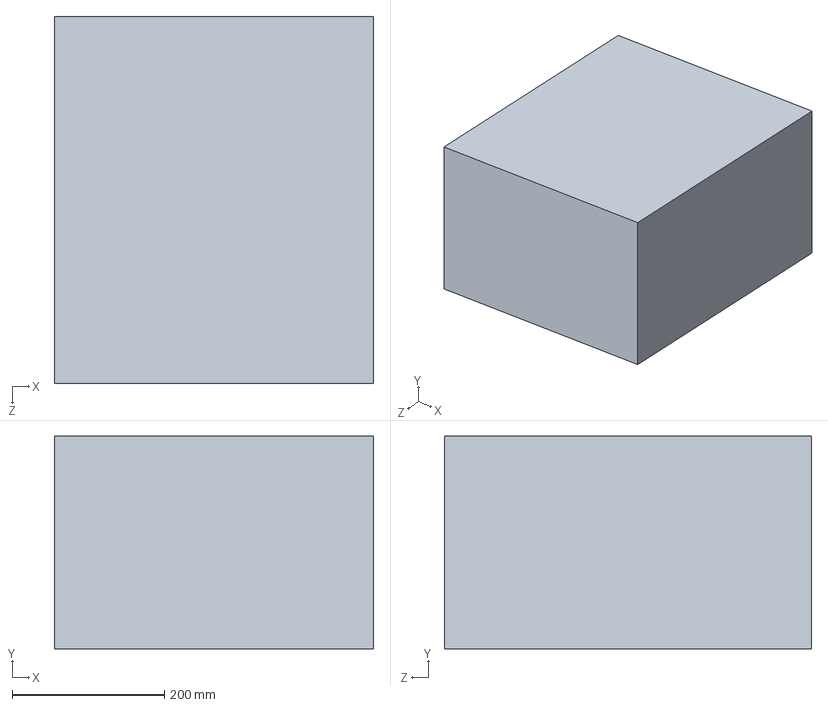
[picture p108: CAD file, 2016-12-09]
new.16-17/Short_Box.SLDPRT
419.1 x 279.4 x 482.6 mm
