BDR16/ARCHIBALD-the-battery-box/CURRENT.16-17/Accumulator/Motor Controller/Control Board Mount.SLDPRT

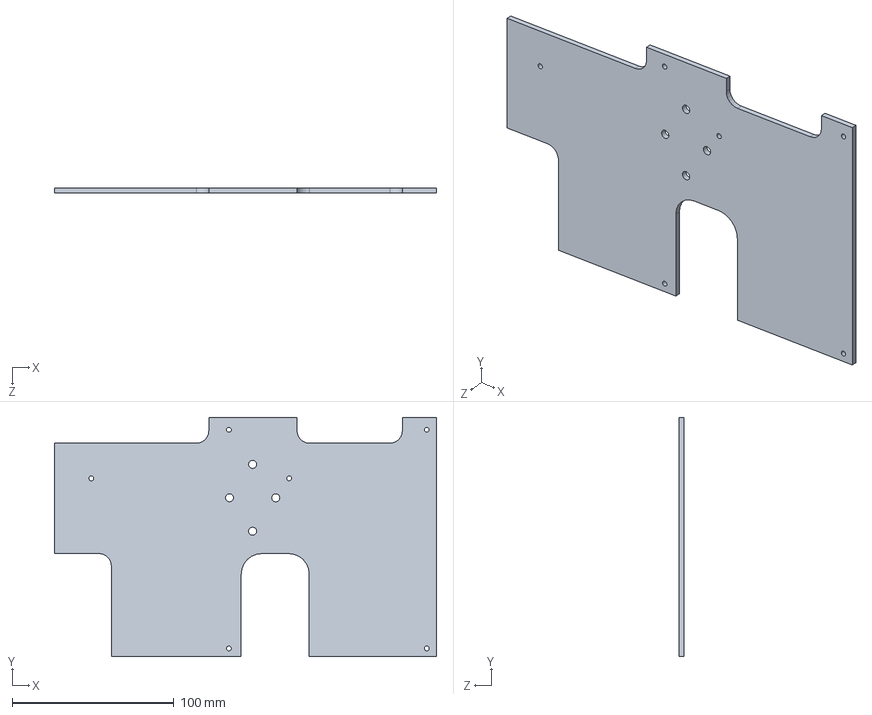
[picture p109: CAD file, 2016-11-20]
CURRENT.16-17/Accumulator/Motor Controller/Control Board Mount.SLDPRT
235.9 x 147.6 x 3.17 mm
