BDR16/ARCHIBALD-the-battery-box/new.16-17/AccumulatorDesigns/Wall.SLDPRT

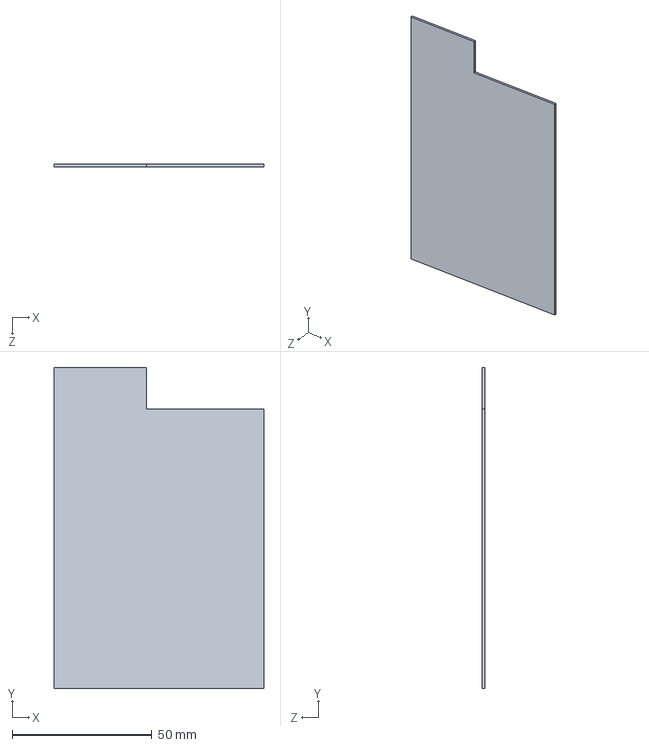
[picture p110: CAD file, 2016-12-09]
new.16-17/AccumulatorDesigns/Wall.SLDPRT
75.0 x 114.9 x 1.00 mm
