BDR16/ARCHIBALD-the-battery-box/new.16-17/AccumulatorDesigns_12-18/Copper_Divider_A.SLDPRT

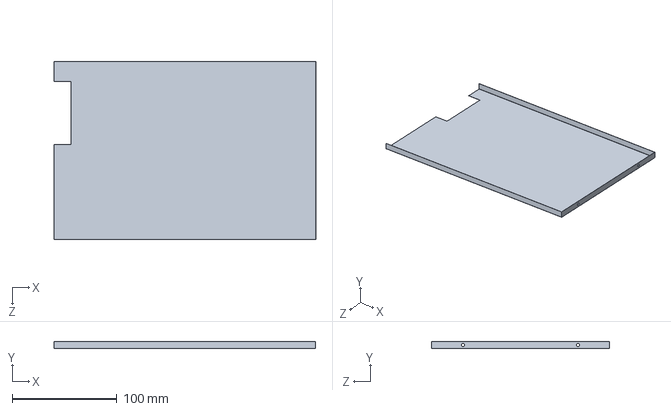
[picture p111: CAD file, 2016-12-18]
new.16-17/AccumulatorDesigns_12-18/Copper_Divider_A.SLDPRT
250.1 x 7.13 x 170.0 mm
