BDR16/ARCHIBALD-the-battery-box/new.16-17/Square_Box.SLDPRT

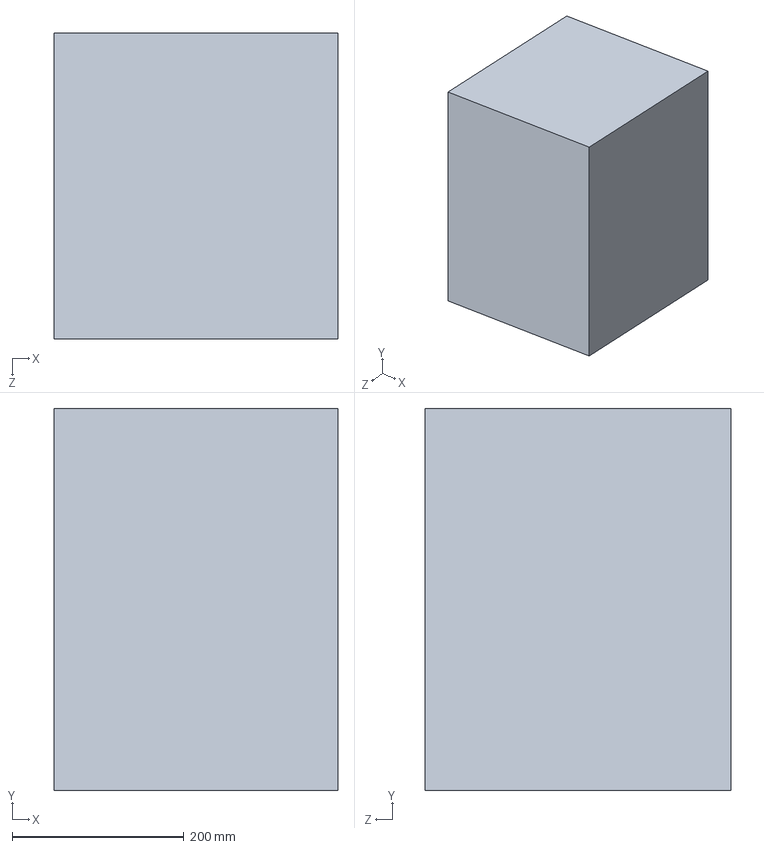
[picture p112: CAD file, 2016-12-09]
new.16-17/Square_Box.SLDPRT
330.2 x 444.5 x 355.6 mm
