BDR16/ARCHIBALD-the-battery-box/CURRENT.16-17/Accumulator/HV Control/0 Gauge Lug.SLDPRT

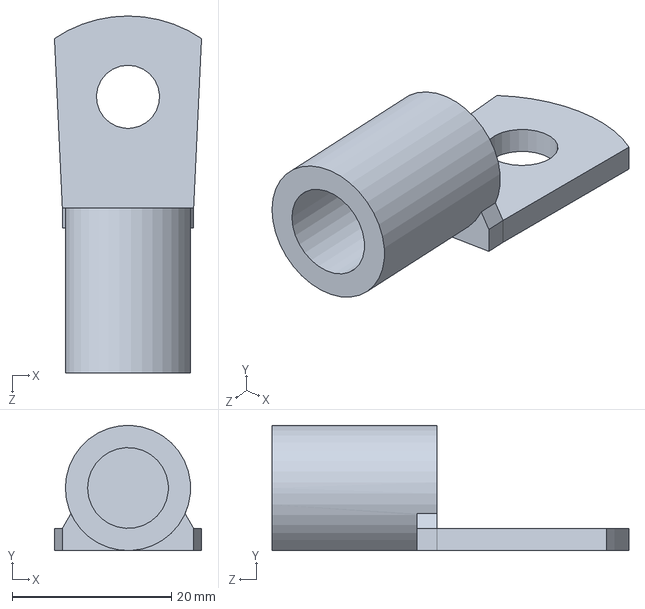
[picture p113: CAD file, 2016-11-20]
CURRENT.16-17/Accumulator/HV Control/0 Gauge Lug.SLDPRT
18.5 x 15.7 x 44.9 mm
