BDR16/ARCHIBALD-the-battery-box/CURRENT.16-17/Accumulator/Motor Controller/Current Shunt.SLDPRT

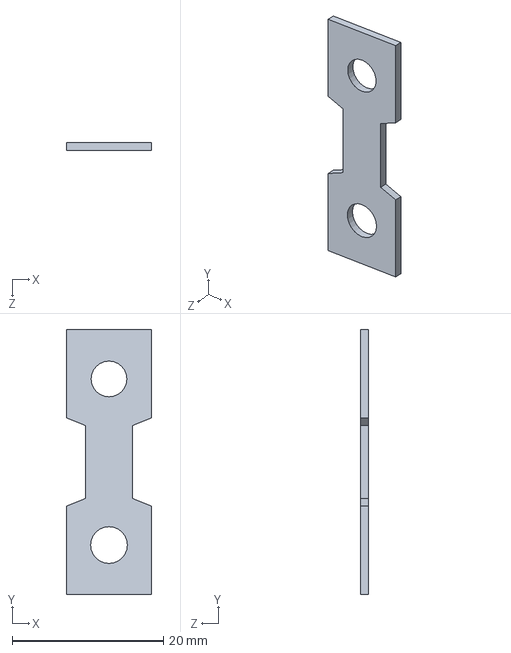
[picture p114: CAD file, 2016-11-20]
CURRENT.16-17/Accumulator/Motor Controller/Current Shunt.SLDPRT
11.3 x 35.1 x 1.09 mm
