BDR16/ARCHIBALD-the-battery-box/new.16-17/AccumulatorDesigns/Cell.SLDPRT

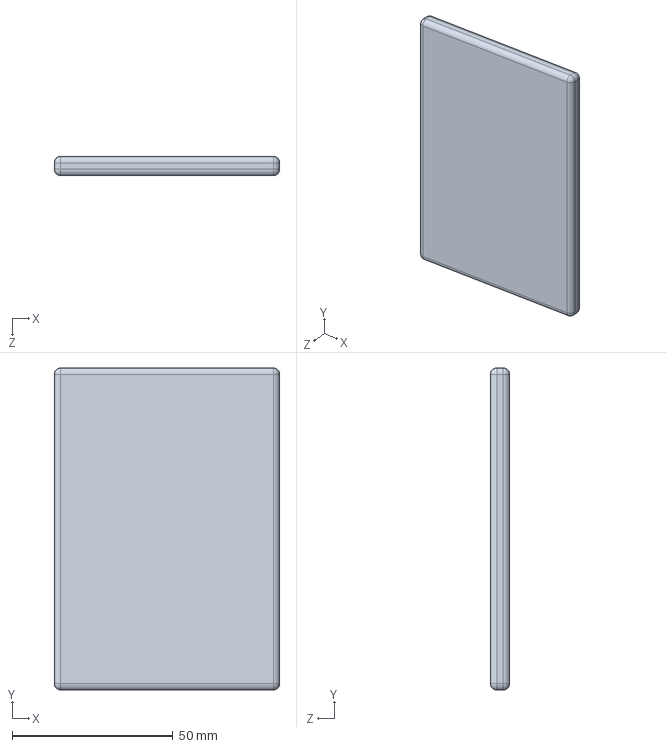
[picture p115: CAD file, 2016-12-09]
new.16-17/AccumulatorDesigns/Cell.SLDPRT
70.0 x 100.0 x 6.00 mm
