BDR16/ARCHIBALD-the-battery-box/new.16-17/FirewallAttachToBodyDante1.SLDPRT

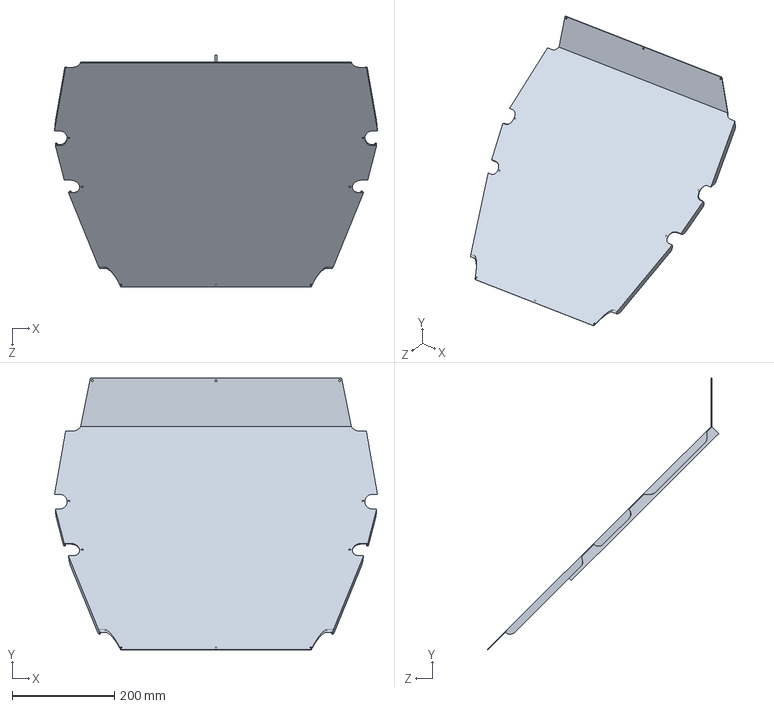
[picture p116: CAD file, 2016-11-20]
new.16-17/FirewallAttachToBodyDante1.SLDPRT
630.3 x 530.8 x 451.9 mm
