BDR16/ARCHIBALD-the-battery-box/CURRENT.16-17/Accumulator/HV Control/IMD Mounting Bracket.SLDPRT

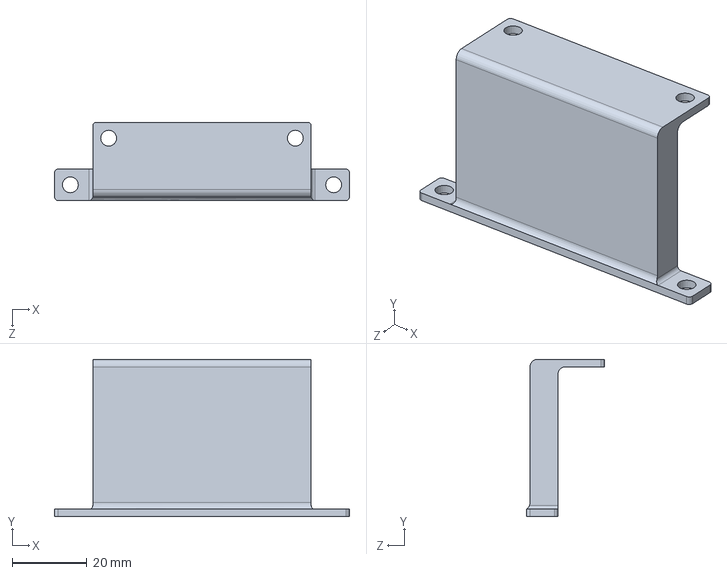
[picture p117: CAD file, 2016-11-20]
CURRENT.16-17/Accumulator/HV Control/IMD Mounting Bracket.SLDPRT
79.0 x 42.1 x 21.0 mm
