BDR16/ARCHIBALD-the-battery-box/CURRENT.16-17/Accumulator/Motor Controller/Current Shunt Bent.SLDPRT

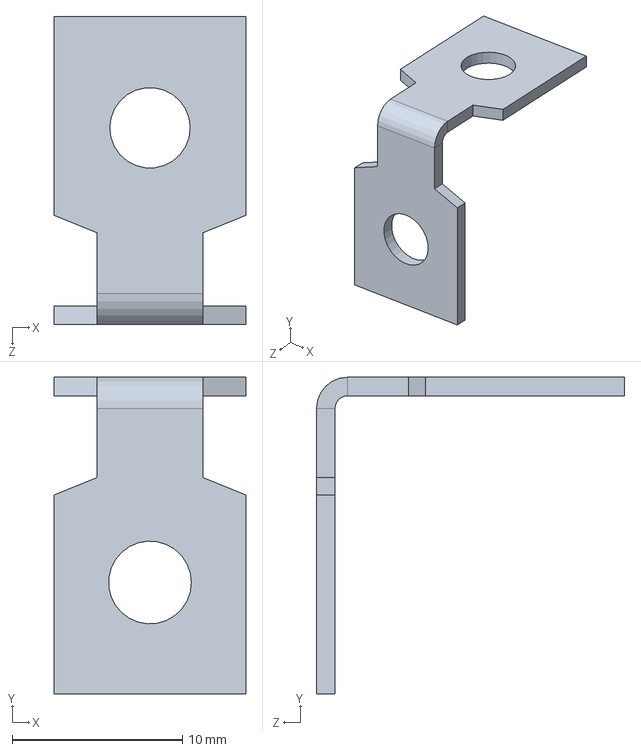
[picture p118: CAD file, 2016-11-20]
CURRENT.16-17/Accumulator/Motor Controller/Current Shunt Bent.SLDPRT
11.3 x 18.6 x 18.1 mm
