BDR16/ARCHIBALD-the-battery-box/CURRENT.16-17/Accumulator/HV Control/End End Bus Bar.SLDPRT

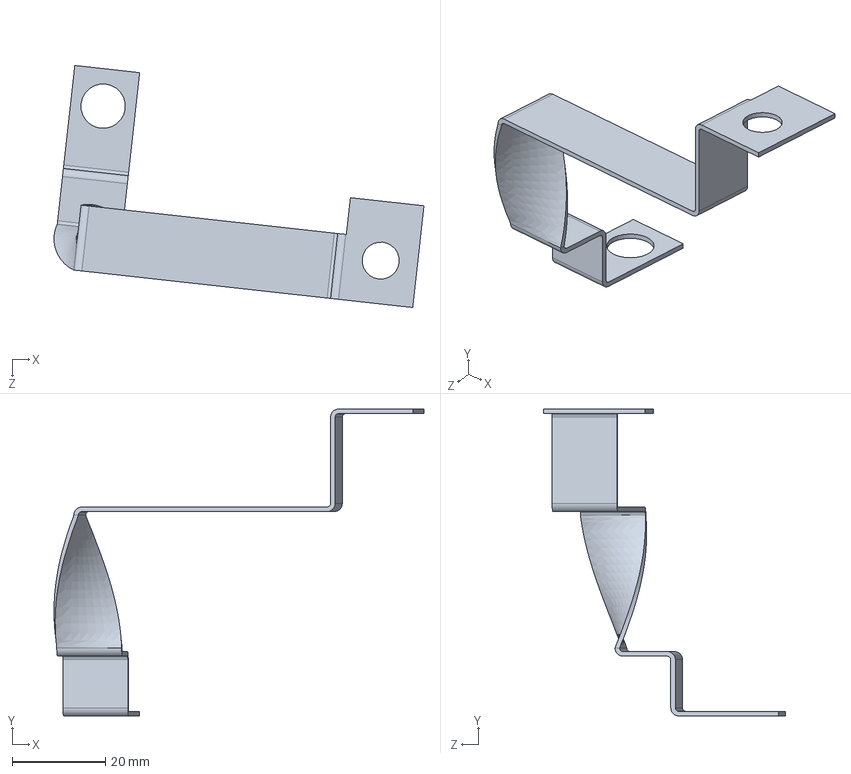
[picture p119: CAD file, 2016-11-20]
CURRENT.16-17/Accumulator/HV Control/End End Bus Bar.SLDPRT
79.3 x 65.8 x 51.9 mm
