BDR16/ARCHIBALD-the-battery-box/(list of files, cad)

Other CAD files:
CURRENT.16-17/Accumulator/Battery Management System/BMS Controller/BMS Controller Board.sldasm
CURRENT.16-17/Accumulator/HV Control/AMS/1590J Lid - Modified.sldasm
CURRENT.16-17/Accumulator/Battery Management System/BMS Controller/Lithiumate Pro Controller/1590J Lid - Modified.sldasm
CURRENT.16-17/Accumulator/HV Control/AMS/Lithiumate Board Assy.sldasm
CURRENT.16-17/Accumulator/HV Control/AMS/AMS.SLDASM
CURRENT.16-17/Accumulator/Battery Management System/BMS Controller/Lithiumate Pro Controller/Molex 705430001.sldprt
CURRENT.16-17/Accumulator/Charging/Charging Board.SLDPRT
CURRENT.16-17/Accumulator/HV Control/AMS/Molex 039281163.sldprt
CURRENT.16-17/Accumulator/Battery Management System/BMS Controller/Lithiumate Pro Controller/Molex 705430004.sldprt
CURRENT.16-17/Accumulator/Covers/LV Cover.sldprt
CURRENT.16-17/Accumulator/HV Control/AMS/PEM FHS-440-4ZI.sldprt
CURRENT.16-17/Accumulator/Battery Management System/BMS Controller/Lithiumate Pro Controller/1590JF Box.sldprt
CURRENT.16-17/Accumulator/HV Control/AMS/NorComp 171-009-213.sldprt
CURRENT.16-17/Accumulator/Battery Management System/BMS Controller/Lithiumate Pro Controller/Molex 039281163.sldprt
CURRENT.16-17/Accumulator/HV Control/AMS/1590J Lid.sldprt
new.16-17/AccumulatorDesigns_12-18/Cell_A.SLDPRT
CURRENT.16-17/Accumulator/Battery Management System/BMS Controller/Lithiumate Pro Controller/PEM FHS-440-4ZI.sldprt
CURRENT.16-17/Accumulator/HV Control/AMS/Lithiumate Board.sldprt
CURRENT.16-17/Accumulator/Stacks/Cells/Cell Tab Config B.SLDPRT
new.16-17/AccumulatorDesigns_12-18/Cell_B.SLDPRT
CURRENT.16-17/Accumulator/Battery Management System/BMS Controller/Lithiumate Pro Controller/1590J Lid.sldprt
CURRENT.16-17/Accumulator/Battery Management System/BMS Controller/Lithiumate Pro Controller/NorComp 171-009-213.sldprt
CURRENT.16-17/Accumulator/HV Control/AMS/Molex 705430003.sldprt
CURRENT.16-17/Accumulator/Battery Management System/BMS Controller/Lithiumate Pro Controller/Lithiumate Board.sldprt
CURRENT.16-17/Accumulator/Battery Management System/BMS Controller/Lithiumate Pro Controller/Molex 705430003.sldprt
CURRENT.16-17/Accumulator/HV Control/AMS/Molex 705430001.sldprt
CURRENT.16-17/Accumulator/HV Control/PowerLok Connector.SLDPRT
CURRENT.16-17/Accumulator/HV Control/AMS/Molex 705430004.sldprt
CURRENT.16-17/Accumulator/HV Control/Board.sldprt
CURRENT.16-17/Accumulator/HV Control/AMS/1590JF Box.sldprt
new.16-17/AccumulatorDesigns_12-18/Copper_Divider_B.SLDPRT
CURRENT.16-17/Accumulator/HV Control/Current Sensor/Current Sensor.SLDPRT
CURRENT.16-17/Accumulator/HV Control/PowerLok Receptacle.SLDPRT
CURRENT.16-17/Accumulator/Motor Controller/Bamocar Board.SLDPRT
CURRENT.16-17/Accumulator/Motor Controller/Left Side Middle Bus Bar.SLDPRT
CURRENT.16-17/Accumulator/Stacks/Stack Parts/Tab Load Spreader.SLDDRW
new.16-17/AccumulatorDesigns/Cell_A.SLDPRT
new.16-17/AccumulatorDesigns/Cell_B.SLDPRT
new.16-17/AccumulatorDesigns/Copper_Divider_A.SLDPRT
new.16-17/AccumulatorDesigns/Copper_Divider_B.SLDPRT
new.16-17/AccumulatorDesigns/End_Plate.SLDPRT
new.16-17/AccumulatorDesigns/Heatsink.SLDPRT
new.16-17/AccumulatorDesigns/Neoprene_Insulation_A.SLDPRT
new.16-17/AccumulatorDesigns/Neoprene_Insulation_B.SLDPRT
new.16-17/AccumulatorDesigns/Stack_Dividers.SLDASM
new.16-17/AccumulatorDesigns_12-15/Cell_A.SLDPRT
new.16-17/AccumulatorDesigns_12-15/Cell_B.SLDPRT
new.16-17/AccumulatorDesigns_12-15/Connecting_Rod.SLDPRT
new.16-17/AccumulatorDesigns_12-15/Copper_Divider_A.SLDPRT
new.16-17/AccumulatorDesigns_12-15/Copper_Divider_B.SLDPRT
new.16-17/AccumulatorDesigns_12-15/End_Plate.SLDPRT
new.16-17/AccumulatorDesigns_12-15/Heatsink.SLDPRT
new.16-17/AccumulatorDesigns_12-15/Neoprene_Insulation_A.SLDPRT
new.16-17/AccumulatorDesigns_12-15/Neoprene_Insulation_B.SLDPRT
new.16-17/AccumulatorDesigns_12-15/Stack_Dividers.SLDASM
new.16-17/rail-mk.2.SLDPRT
old.15-16/Accumulator/Battery Management System/BMS Controller/BMS Controller Board.sldasm
old.15-16/Accumulator/Battery Management System/BMS Controller/Lithiumate Pro Controller/1590J Lid - Modified.sldasm
old.15-16/Accumulator/Battery Management System/BMS Controller/Lithiumate Pro Controller/1590J Lid.sldprt
old.15-16/Accumulator/Battery Management System/BMS Controller/Lithiumate Pro Controller/1590JF Box.sldprt
old.15-16/Accumulator/Battery Management System/BMS Controller/Lithiumate Pro Controller/Lithiumate Board.sldprt
old.15-16/Accumulator/Battery Management System/BMS Controller/Lithiumate Pro Controller/Molex 039281163.sldprt
old.15-16/Accumulator/Battery Management System/BMS Controller/Lithiumate Pro Controller/Molex 705430001.sldprt
old.15-16/Accumulator/Battery Management System/BMS Controller/Lithiumate Pro Controller/Molex 705430003.sldprt
old.15-16/Accumulator/Battery Management System/BMS Controller/Lithiumate Pro Controller/Molex 705430004.sldprt
old.15-16/Accumulator/Battery Management System/BMS Controller/Lithiumate Pro Controller/NorComp 171-009-213.sldprt
old.15-16/Accumulator/Battery Management System/BMS Controller/Lithiumate Pro Controller/PEM FHS-440-4ZI.sldprt
old.15-16/Accumulator/Charging/Charging Board.SLDPRT
old.15-16/Accumulator/Covers/LV Cover.sldprt
old.15-16/Accumulator/HV Control/AMS/1590J Lid - Modified.sldasm
old.15-16/Accumulator/HV Control/AMS/1590J Lid.sldprt
old.15-16/Accumulator/HV Control/AMS/1590JF Box.sldprt
old.15-16/Accumulator/HV Control/AMS/AMS.SLDASM
old.15-16/Accumulator/HV Control/AMS/Lithiumate Board Assy.sldasm
old.15-16/Accumulator/HV Control/AMS/Lithiumate Board.sldprt
old.15-16/Accumulator/HV Control/AMS/Molex 039281163.sldprt
old.15-16/Accumulator/HV Control/AMS/Molex 705430001.sldprt
old.15-16/Accumulator/HV Control/AMS/Molex 705430003.sldprt
old.15-16/Accumulator/HV Control/AMS/Molex 705430004.sldprt
old.15-16/Accumulator/HV Control/AMS/NorComp 171-009-213.sldprt
old.15-16/Accumulator/HV Control/AMS/PEM FHS-440-4ZI.sldprt
old.15-16/Accumulator/HV Control/Board.sldprt
old.15-16/Accumulator/HV Control/Current Sensor/Current Sensor.SLDPRT
old.15-16/Accumulator/HV Control/PowerLok Connector.SLDPRT
old.15-16/Accumulator/HV Control/PowerLok Receptacle.SLDPRT
old.15-16/Accumulator/Motor Controller/Bamocar Board.SLDPRT
old.15-16/Accumulator/Motor Controller/Left Side Middle Bus Bar.SLDPRT
old.15-16/Accumulator/Stacks/Cells/A123 Amp20 Old.SLDPRT
old.15-16/Accumulator/Stacks/Cells/Cell Tab Config B.SLDPRT
old.15-16/Accumulator/Stacks/Stack Parts/Tab Load Spreader.SLDDRW
old.15-16/BreadBoxBoard&housing/BBB Board.SLDPRT
old.15-16/BreadBoxBoard&housing/BBB Box.SLDPRT
old.15-16/BreadBoxBoard&housing/BBB.SLDASM
old.15-16/Chassis/Accumulator Upper Tab.SLDPRT
old.15-16/Chassis/Tabs/Extra Tab.SLDPRT
old.15-16/Chassis/Tabs/Planetary Outer Tabs.sldprt
old.15-16/Chassis/Tabs/Tab 55.sldprt
old.15-16/Chassis/Tabs/Tab 56.sldprt
old.15-16/Chassis/Tabs/Tab 57.sldprt
old.15-16/Chassis/Tabs/Tab 58.sldprt
old.15-16/Chassis/Tabs/Tab 59.sldprt
old.15-16/Chassis/Tabs/Tab 60.sldprt
old.15-16/Chassis/Tabs/Tab 61.sldprt
old.15-16/Chassis/Tabs/Tab 62.sldprt
old.15-16/Chassis/Tabs/Tab 63.sldprt
old.15-16/Chassis/Tabs/Tab 64.sldprt
old.15-16/Chassis/Tabs/Tab 65.sldprt
old.15-16/Chassis/Tabs/Tab 66.sldprt
old.15-16/Chassis/Tabs/Tab 67.sldprt
old.15-16/Chassis/Tabs/Tab 68.sldprt
old.15-16/Chassis/Tabs/Tab 69.sldprt
old.15-16/Chassis/Tabs/Tab 70.sldprt
old.15-16/Chassis/Tabs/Tab 71.sldprt
old.15-16/Chassis/Tabs/Tab 73.sldprt
old.15-16/Chassis/Tabs/Tab 75 (76 on cut list).sldprt
old.15-16/Chassis/Tabs/Tabs_Bulldogs_Racing_Rev02.DXF
old.15-16/Chassis/Tabs/Tabs_Bulldogs_Racing_Rev02.SLDASM
old.15-16/Chassis/Tabs/Tabs_Bulldogs_Racing_Rev02.SLDDRW
old.15-16/Firewall/Firewall.SLDPRT
