BDR16/ARCHIBALD-the-battery-box/new.16-17/Measurements.xlsm

Square Box |  |  |  | all in inches
 | height | length | width | Volume
 | 14 | 14 | 13 | 2548
Long Box
 | height | length | width
 | 12 | 19 | 13 | 2964
Tall Box
 | height | length | width
 | 20 | 8.5 | 12.5 | 2125
Short Box
 | height | length | width |  | Modified short box for rails
 | 11 | 19 | 16.5 | 3448.5 |  | height | length | width
 |  |  |  |  |  | 11 | 18 | 14 | 2772
Balanced Box
 | height | length | width
 | 13 | 17.5 | 14 | 3185
Aydin measured box
 | height | length | width
 | 20 | 14.3 | 10.5 | 3003
