BDR16/ARCHIBALD-the-battery-box/old.15-16/Chassis/Tabs/Chassis Tabs.PDF

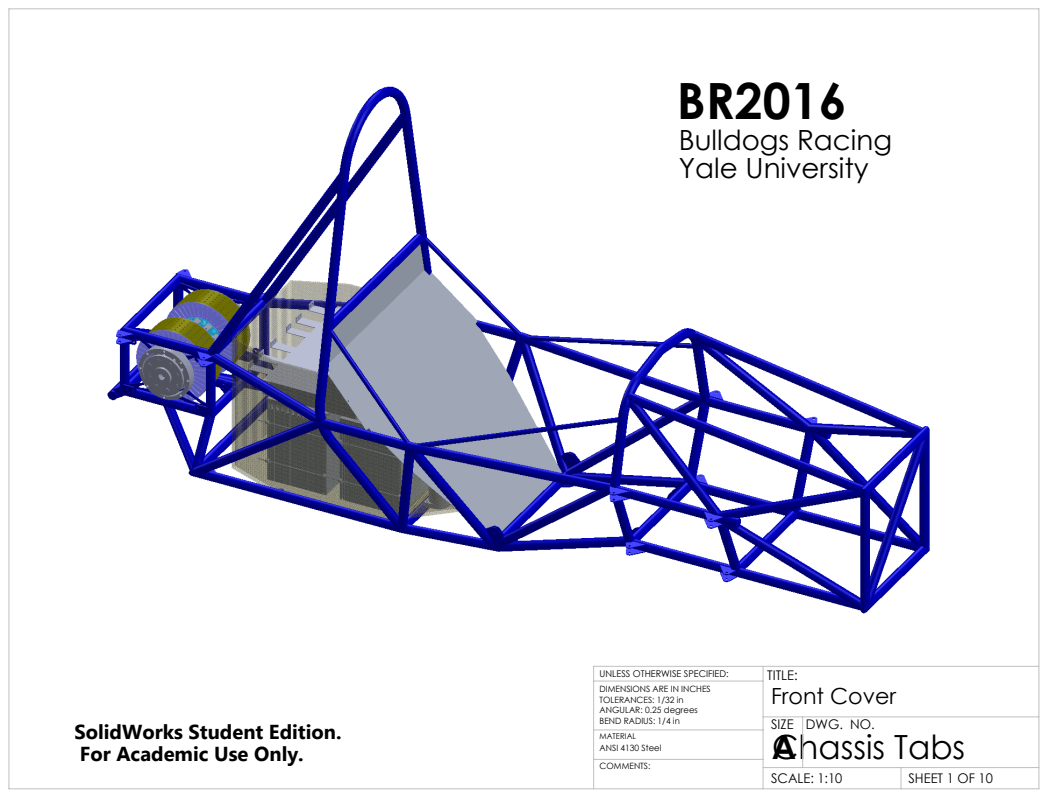
[picture p120: page 1]
Bulldogs Racing Yale University; Front Cover

UNLESS OTHERWISE SPECIFIED:
DIMENSIONS ARE IN INCHES
TOLERANCES: 1/32 in
ANGULAR: 0.25 degrees
BEND RADIUS: 1/4 in
MATERIAL
ANSI 4130 Steel
COMMENTS:

SolidWorks Student Edition.
For Academic Use Only.

SIZE A Chassis Tabs | DWG. NO.

SCALE: 1:10 | SHEET 1 OF 10

# Phone Number

## Philip Piper: 7135012744

# Email Addresses

## taha.ramazanoglu@yale.edu philip.piper@yale.edu dante.archangeli@yale.edu joseph.zinter@yale.edu

# People

## Taha Ramazanoglu - President Philip Piper - Chassis Designer Dante Archangeli - Chassis Designer Dr. Joseph Zinter - Faculty Advisor

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

# Chassis Tabs

UNLESS OTHERWISE SPECIFIED:

DWG. NO.
A

### SIZE

### TITLE:

MATERIAL

# Notes

ANSI 4130 Steel

SolidWorks Student Edition. For Academic Use Only.

72 | 1 | Front Torsional Rigidity | 0.5 x 0.035 | 22.18
45 | 1 | Front Box Final Diagonal | 1 x 0.049 | 15.84 | 73 | 4 | End Caps | N/A x 0.1
11 | 1 | Side Front Diagonal | 1 x 0.065 | 18.58
46 | 1 | Main Roll Hoop Brace | 1 x 0.065 | 30.12 | 74 | 8 | Planetary Outer Tabs | N/A x 0.1
12 | 1 | Side Middle Diagonal | 1 x 0.065 | 14.43
47 | 1 | Rear Box Rear Lowering | 1 x 0.049 | 14.18 | 75 | 1 | Rear Torsional Rigidity | 0.5 x 0.035 | 13.6
13 | 2 | Side Rear Lower | 1 x 0.065 | 10.41 | 48 | 1 | Side Front Diagonal | 1 x 0.065 | 18.58 | 76 | 2 | Rear Sus Rear Upper Tabs 2 | N/A x 0.1
14 | 1 | Side Rear Diagonal | 1 x 0.065 | 12.35
15 | 1 | Shoulder Harness Mount | 1 x 0.095 | 20.13 | | | | | | 77 | 1 | Rear Box Vertical | 1 x 0.049 | 6.85
16 | 4 | Rear Box Longitudinal | 1 x 0.049 | 10.73
17 | 4 | Rear Box Horizontal | 1 x 0.049 | 12.5
18 | 1 | Rear Box Middle | 1 x 0.049 | 9.73
19 | 3 | Rear Box Vertical | 1 x 0.049 | 6.85
| | | | | 54 | 1 | Front Roll Hoop Brace | 1 x 0.065 | 26.63
20 | 1 | Rear Bracing Longitudinal | 1 x 0.049 | 16.92
| | | | | 55 | 2 | Jacking Point Tabs | N/A x 0.1
21 | 2 | Rear Lower Longitudinal | 1 x 0.049 | 23.92
| | | | | 56 | 4 | Front Sus Front Upper Tabs | N/A x 0.1
22 | 1 | Rear Bracing Diagonal | 1 x 0.049 | 20.06
| | | | | 57 | 4 | Firewall Tabs | N/A x 0.1
23 | 1 | Rear Box Front Lowering | 1 x 0.049 | 5.93
| | | | | 58 | 4 | Front Sus Front Lower Tabs | N/A x 0.1
24 | 1 | Rear Torsional Rigidity | 0.5 x 0.035 | 13.6
25 | 1 | Front Torsional Rigidity | 0.5 x 0.035 | 22.18
| | | | | 59 | 2 | Rear Sus Rear Upper Tabs 1 | N/A x 0.1
26 | 1 | Rear Lower Horizontal | 1 x 0.049 | 19
27 | 1 | Seat Belt Mount | 1 x 0.065 | 15.5 | 60 | 2 | Rear Sus Front Upper Tabs 1 | N/A x 0.1
28 | 2 | Front Lower Horizontal | 1 x 0.049 | 12.75
29 | 2 | Front Box Longitudinal | 1 x 0.049 | 14.44
30 | 1 | Jacking Point | 1 x 0.035 | 12
31 | 1 | Rear Box Diagonal | 1 x 0.049 | 13.39
32 | 1 | Front Box Lower Diagonal | 1 x 0.049 | 16.97
33 | 1 | Front Lower Sus Mount | 1 x 0.049 | 27.07
34 | 1 | Front Bulkhead Diagonal | 1 x 0.035 | 18.57

## Tab 76 will be referred to as tab

75 throughout this document.

ITEM NO. | QTY. | DESCRIPTION | OD x THICK (INCHES) | LENGTH | ITEM NO. | QTY. | DESCRIPTION | OD x THICK (INCHES) | LENGTH | ITEM NO. | QTY. | DESCRIPTION | OD x THICK (INCHES) | LENGTH
1 | 2 | Front Bulkhead Horizontal | 1 x 0.065 | 13.75 | 36 | 1 | Front Box Rear Diagonal | 1 x 0.049 | 15.33 | 65 | 2 | Anti Sub Lower Tabs | N/A x 0.1
2 | 2 | Front Bulkhead Vertical | 1 x 0.065 | 14.5 | 37 | 1 | Front Box Vertical | 1 x 0.049 | 8.56 | 66 | 2 | Anti Sub Upper Tabs | N/A x 0.1
3 | 1 | Front Lower Sus Mount | 1 x 0.049 | 27.07 | 38 | 1 | Main Roll Hoop Base | 1 x 0.035 | 18 | 67 | 2 | Lap Belt Outer Tabs | N/A x 0.1
4 | 1 | Front Box Vertical | 1 x 0.049 | 8.56 | 39 | 1 | Main Roll Hoop Brace | 1 x 0.065 | 30.12 | 68 | 2 | Lap Belt Inner Tabs | N/A x 0.1
5 | 2 | Front Roll Hoop Support | 1 x 0.095 | 8.68
35 | 1 | Front Box Final Diagonal | 1 x 0.049 | 15.84
40 | 1 | Rear Box Rear Lowering | 1 x 0.049 | 14.18 | 69 | 8 | Motor Tabs | N/A x 0.1
6 | 1 | Front Box Rear Diagonal | 1 x 0.049 | 15.33 | 41 | 1 | Side Front Lower | 1 x 0.049 | 14.47 | 70 | 4 | Front Shock Tabs | N/A x 0.1
7 | 1 | Front Box Lower Diagonal | 1 x 0.049 | 16.97 | 42 | 1 | Front Roll Hoop | 1 x 0.095 | 33.94 | 71 | 2 | Rear Sus Front Upper Tabs 2 | N/A x 0.1
8 | 2 | Side Front Longitudinal | 1 x 0.065 | 21.59
| | | | | 43 | 1 | Front Roll Hoop Brace | 1 x 0.065 | 26.63
9 | 1 | Side Front Lower | 1 x 0.065 | 14.47 | 44 | 1 | Main Roll Hoop | 1 x 0.095 | 99.94
10 | 2 | Side Rear Longitudinal | 1 x 0.065 | 10.07
49 | 1 | Side Middle Diagonal | 1 x 0.065 | 14.43
50 | 1 | Side Rear Diagonal | 1 x 0.065 | 12.35
51 | 1 | Rear Bracing Diagonal | 1 x 0.049 | 20.06
52 | 1 | Rear Bracing Longitudinal | 1 x 0.049 | 16.92
53 | 1 | Rear Box Front Lowering | 1 x 0.049 | 5.93
61 | 4 | Front Sus Rear Upper Tabs | N/A x 0.1
62 | 4 | Front Sus Rear Lower Tabs | N/A x 0.1
63 | 4 | Battery Box Tabs | N/A x 0.1
64 | 2 | Battery Box Middle Tabs | N/A x 0.1

DIMENSIONS ARE IN INCHES
TOLERANCES: 1/32 in
ANGULAR: 0.25 degrees
BEND RADIUS: 1/4 in
SIZE A Chassis Tabs | DWG. NO.

### SCALE: N/A

UNLESS OTHERWISE SPECIFIED:

### TITLE:

MATERIAL

# Cut List

ANSI 4130 Steel

SolidWorks Student Edition. For Academic Use Only.

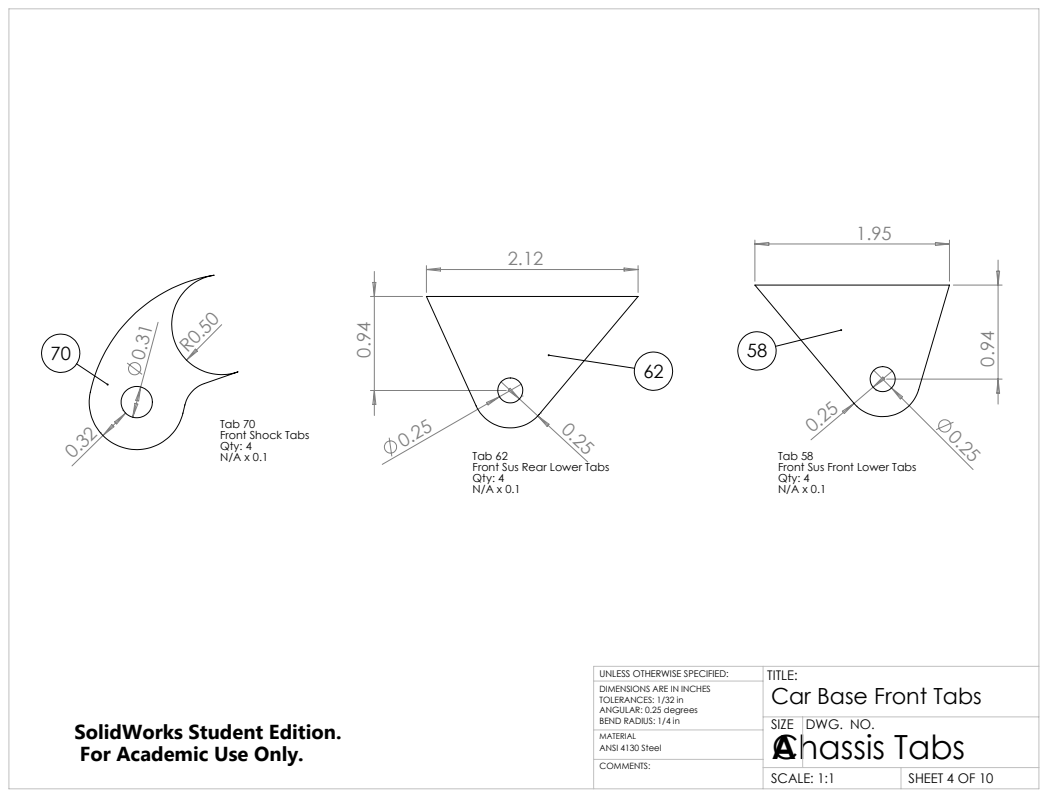
[picture p121: page 4]
Tab 62; DWG. NO.

Tab 70
Front Shock Tabs
Qty: 4

Tab 58
Front Sus Front Lower Tabs

Front Sus Rear Lower Tabs

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

TITLE:
Car Base Front Tabs
Chassis Tabs

SolidWorks Student Edition.
For Academic Use Only.

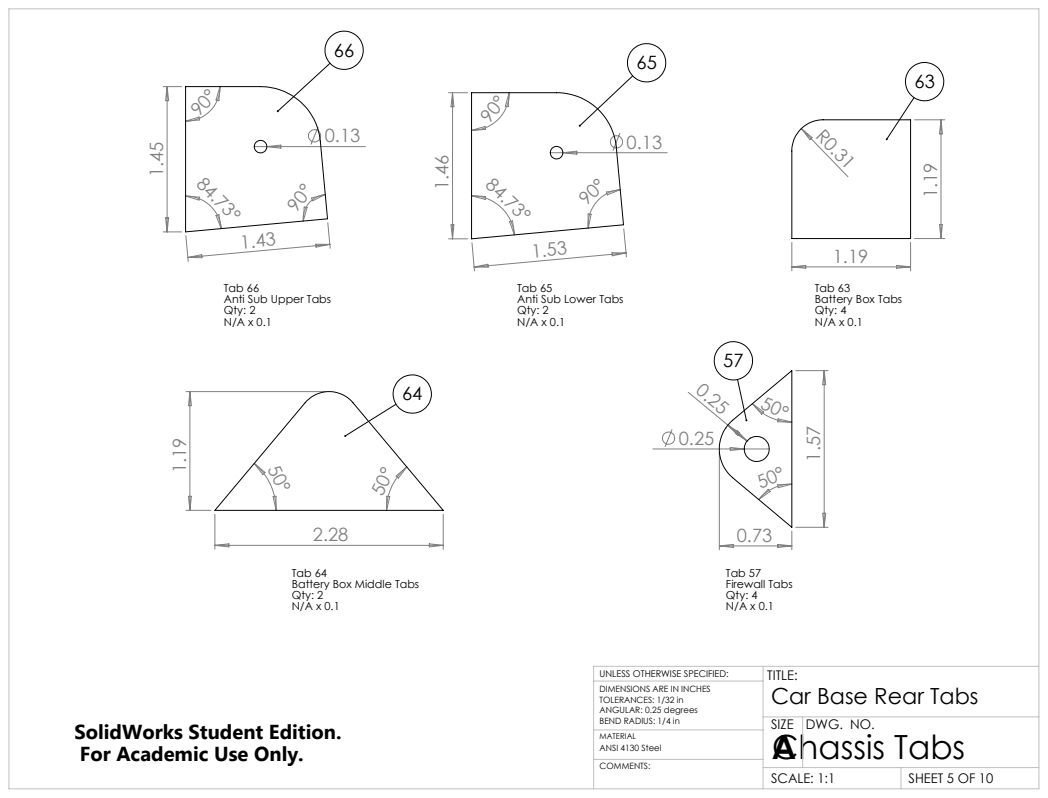
[picture p122: page 5]
Tab 57 Firewall Tabs Qty: 4 N/A x 0.1; Tab 63 Battery Box Tabs Qty: 4 N/A x 0.1; DWG. NO.

Tab 66
Anti Sub Upper Tabs
Qty: 2

Tab 65
Anti Sub Lower Tabs

Tab 64
Battery Box Middle Tabs

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

TITLE:
Car Base Rear Tabs
Chassis Tabs

SolidWorks Student Edition.
For Academic Use Only.

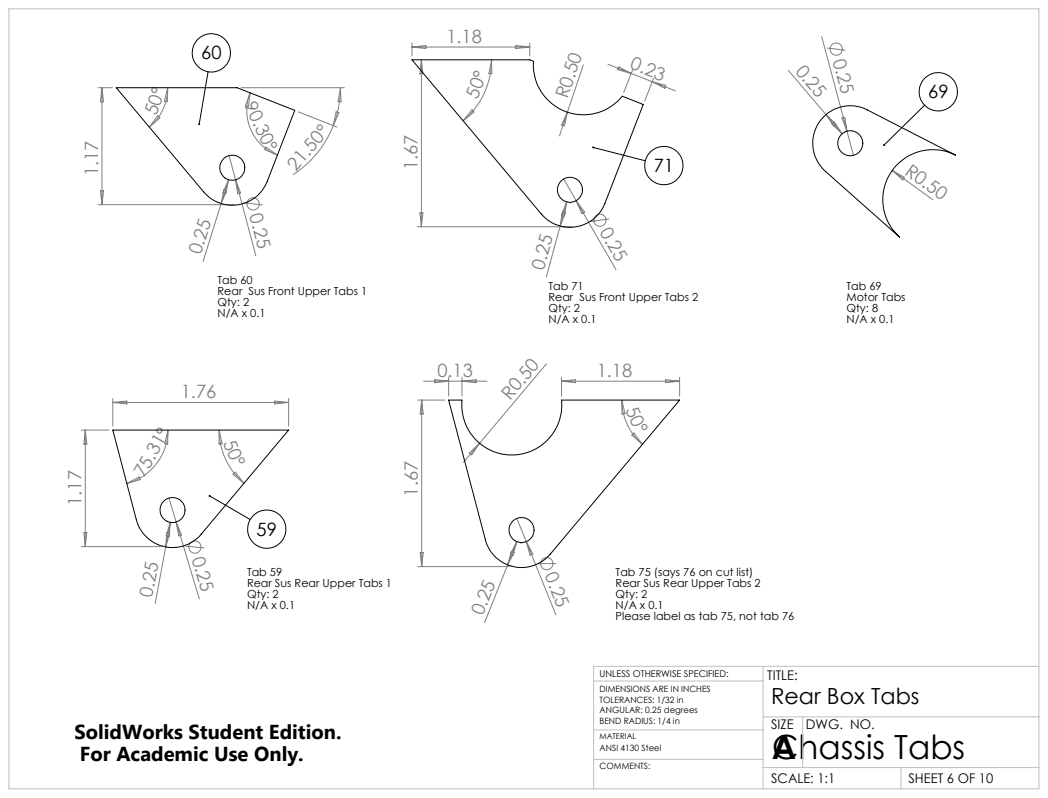
[picture p123: page 6]
Tab 69 Motor Tabs Qty: 8 N/A x 0.1; DWG. NO.

Tab 60
Rear Sus Front Upper Tabs 1
Qty: 2

Tab 71
Rear Sus Front Upper Tabs 2

Tab 59
Rear Sus Rear Upper Tabs 1

Tab 75 (says 76 on cut list)
Rear Sus Rear Upper Tabs 2
Please label as tab 75, not tab 76

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

TITLE:
Rear Box Tabs
Chassis Tabs

SolidWorks Student Edition.
For Academic Use Only.

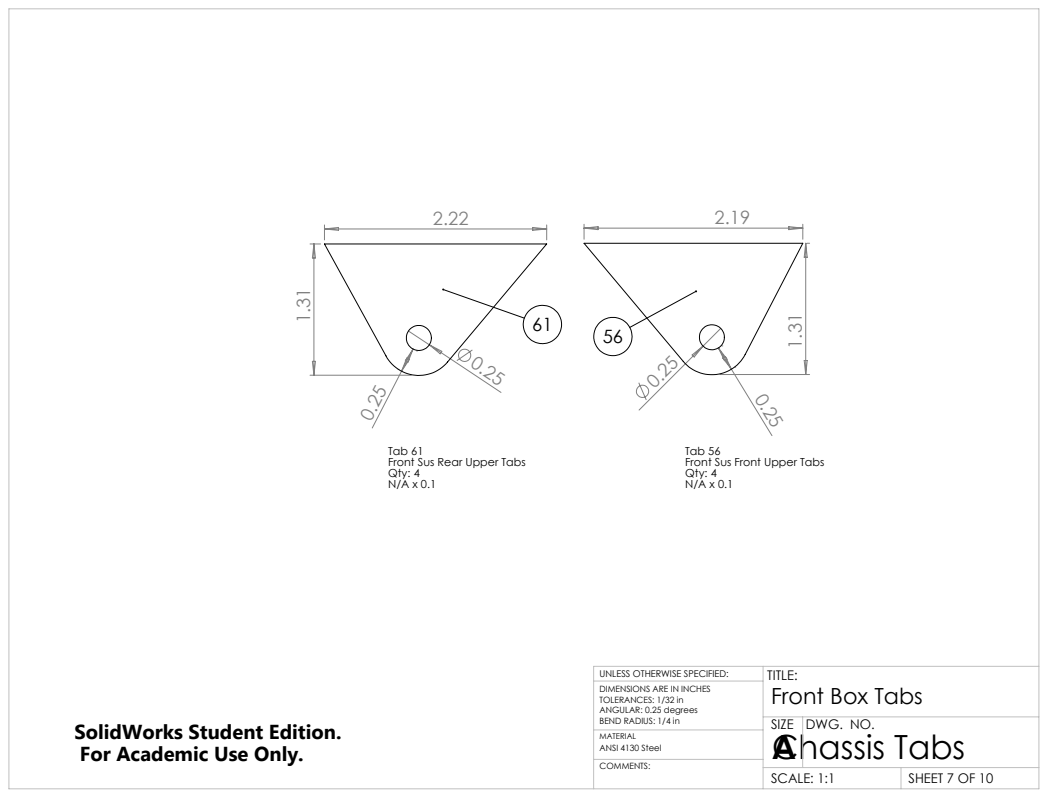
[picture p124: page 7]
DWG. NO.

Tab 61
Front Sus Rear Upper Tabs
Qty: 4

Tab 56
Front Sus Front Upper Tabs

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

TITLE:
Front Box Tabs
Chassis Tabs

SolidWorks Student Edition.
For Academic Use Only.

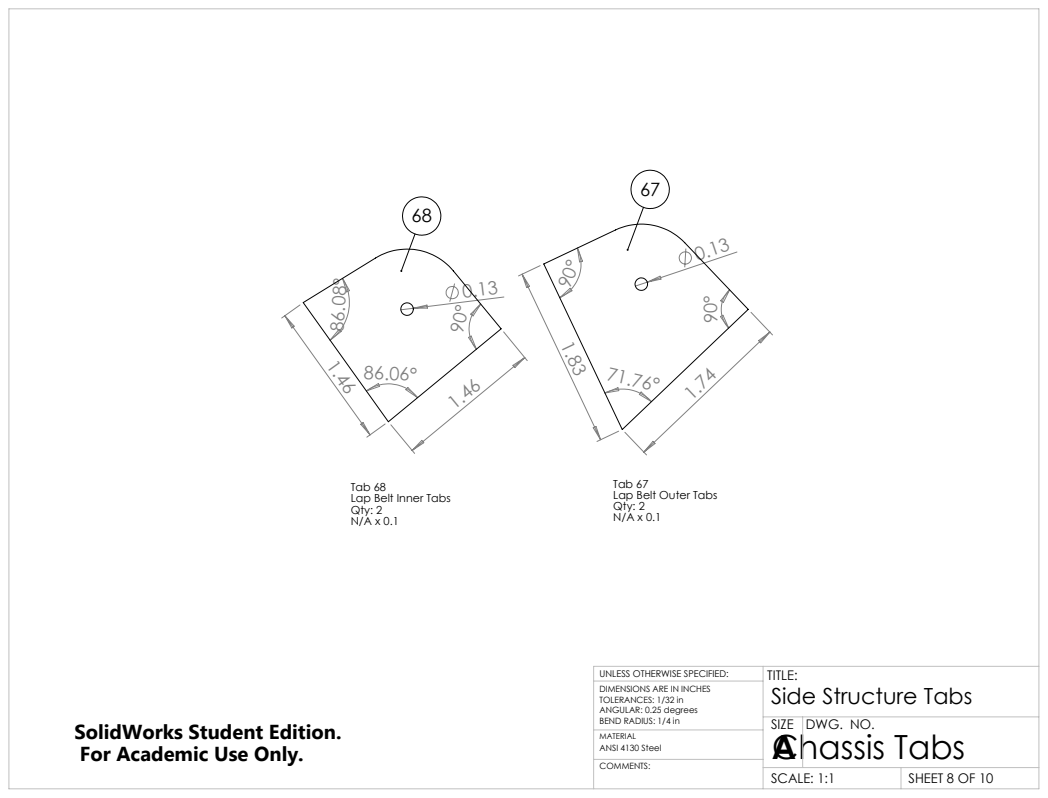
[picture p125: page 8]
DWG. NO.

Tab 68
Lap Belt Inner Tabs
Qty: 2

Tab 67
Lap Belt Outer Tabs

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

TITLE:
Side Structure Tabs
Chassis Tabs

SolidWorks Student Edition.
For Academic Use Only.

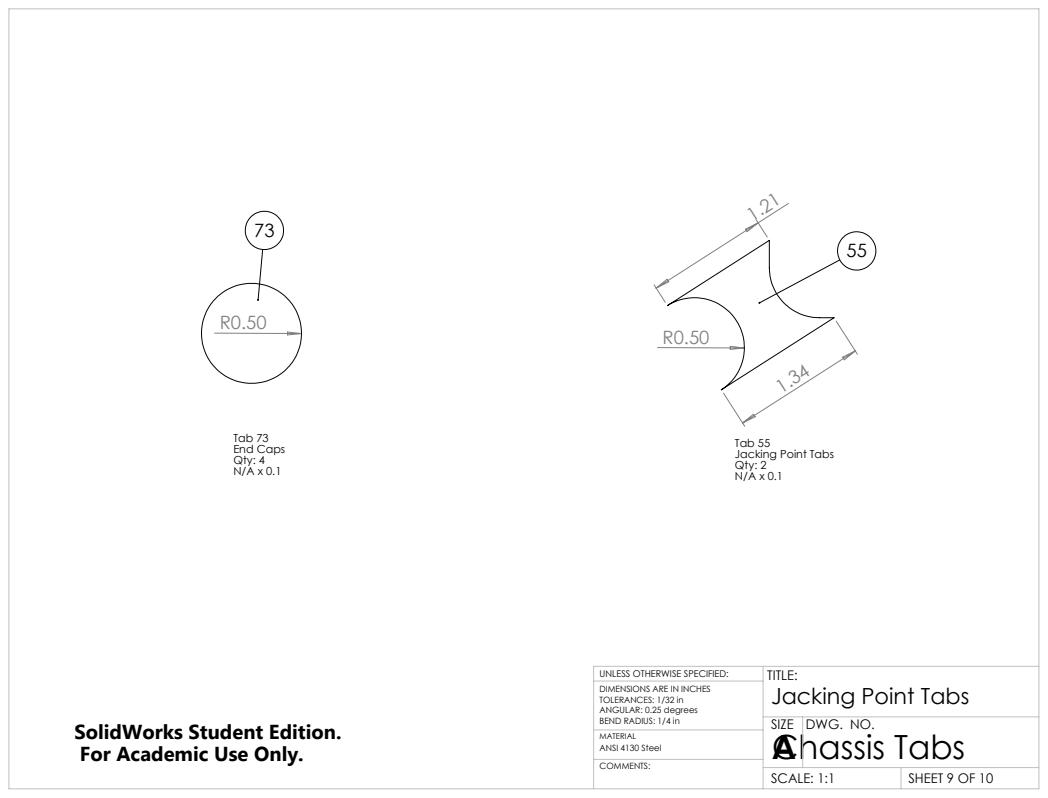
[picture p126: page 9]
Tab 55 Jacking Point Tabs Qty: 2 N/A x 0.1; Tab 73 End Caps Qty: 4 N/A x 0.1; DWG. NO.

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

TITLE:
Jacking Point Tabs
Chassis Tabs

SolidWorks Student Edition.
For Academic Use Only.

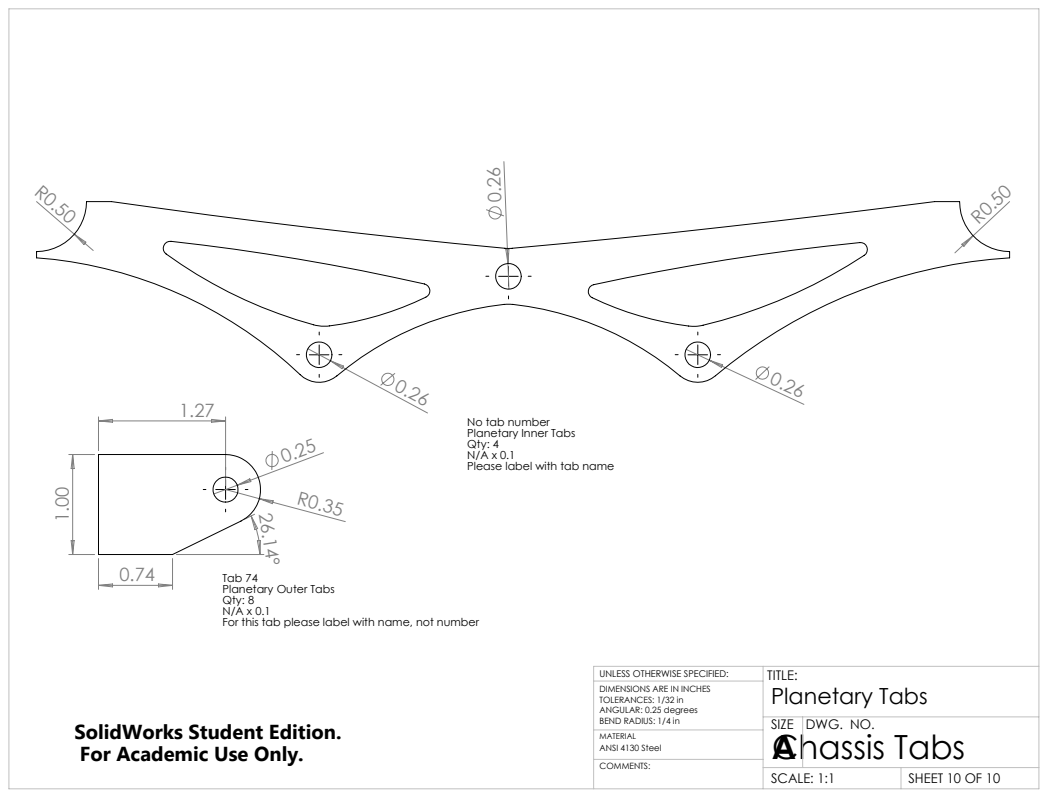
[picture p127: page 10]
Chassis Tabs; DWG. NO.; Planetary Tabs

No tab number
Planetary Inner Tabs
Qty: 4
Please label with tab name

Tab 74
Planetary Outer Tabs
Qty: 8
For this tab please label with name, not number

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

SolidWorks Student Edition.
For Academic Use Only.
