BDR16/ARCHIBALD-the-battery-box/CURRENT.16-17/Accumulator/Stacks/Thermal Simulation/SPICE Model/Cell.asc

C1: cap; {C}
C2: cap; {C}
C3: cap; {C}
C4: cap; {C}
C5: cap; {C}
C6: cap; {C}
C7: cap; {C}
C8: cap; {C}
C9: cap; {C}
C10: cap; {C}
C11: cap; {C}
C12: cap; {C}
C13: cap; {C}
C14: cap; {C}
C15: cap; {C}
C16: cap; {C}
C17: cap; {C}
C18: cap; {C}
C19: cap; {C}
C20: cap; {C}
C21: cap; {C}
C22: cap; {C}
C23: cap; {C}
C24: cap; {C}
C25: cap; {C}
I1: current; {Power}
I2: current; {Power}
I3: current; {Power}
I4: current; {Power}
I5: current; {Power}
I6: current; {Power}
I7: current; {Power}
I8: current; {Power}
I9: current; {Power}
I10: current; {Power}
I11: current; {Power}
I12: current; {Power}
I13: current; {Power}
I14: current; {Power}
I15: current; {Power}
I16: current; {Power}
I17: current; {Power}
I18: current; {Power}
I19: current; {Power}
I20: current; {Power}
I21: current; {Power}
I22: current; {Power}
I23: current; {Power}
I24: current; {Power}
I25: current; {Power}
R1: res; {R}
R2: res; {R}
R3: res; {R}
R4: res; {R}
R5: res; {R}
R6: res; {Rc}
R7: res; {Rc}
R8: res; {Rc}
R9: res; {Rc}
R10: res; {Rc}
R11: res; {R}
R12: res; {R}
R13: res; {R}
R14: res; {R}
R15: res; {R}
R16: res; {Rc}
R17: res; {Rc}
R18: res; {Rc}
R19: res; {Rc}
R20: res; {Rc}
R21: res; {R}
R22: res; {R}
R23: res; {R}
R24: res; {R}
R25: res; {R}
R26: res; {Rc}
R27: res; {Rc}
R28: res; {Rc}
R29: res; {Rc}
R30: res; {Rc}
R31: res; {R}
R32: res; {R}
R33: res; {R}
R34: res; {R}
R35: res; {R}
R36: res; {Rc}
R37: res; {Rc}
R38: res; {Rc}
R39: res; {Rc}
R40: res; {Rc}
R41: res; {R}
R42: res; {R}
R43: res; {R}
R44: res; {R}
R45: res; {R}
R46: res; {Rc}
R47: res; {Rc}
R48: res; {Rc}
R49: res; {Rc}
R50: res; {Rc}
R51: res; {PouchR}
Named nets: T1, T2, T3, T4, T5, T6, T7, T8, T9, T10, T11, T12, T13, T14, T15, T16, T17, T18, T19, T20, T21, T22, T23, T24, T25, T+, 0
.param TotCurrent = 200
.param TotResistance = 0.003
.param Num = 25
.param Current = 'TotCurrent / Num'
.param Resistance = 'TotResistance * Num'
.param Power = 'Current * Current * Resistance'
.param TotMass = 0.495
.param PackageMass = 0
.param SpecificHeat = 500
.param C = '(TotMass - PackageMass) * SpecificHeat / Num'
.param Height = '0.227-0.0045-0.017'
.param Width = '0.1606 - 0.0045'
.param PosThick = 0.000141
.param NegThick = 0.000097
.param SepThick = 0.000021
.param PouchThick = 0.000114
.param PosThermCond = 1.799
.param NegThermCond = 1.170
.param PosR = '(PosThick + SepThick) / (Height * Width * PosThermCond)'
.param NegR = '(NegThick + SepThick) / (Height * Width * NegThermCond)'
.param R = 'PosR + NegR'
.tran 90
.ic V(T1) = 0
.ic V(T2) = 0
.ic V(T3) = 0
.ic V(T4) = 0
.ic V(T5) = 0
.ic V(T6) = 0
.ic V(T7) = 0
.ic V(T8) = 0
.ic V(T9) = 0
.ic V(T10) = 0
.ic V(T11) = 0
.ic V(T12) = 0
.ic V(T13) = 0
.ic V(T14) = 0
.ic V(T15) = 0
.ic V(T16) = 0
.ic V(T17) = 0
.ic V(T18) = 0
.ic V(T19) = 0
.ic V(T17) = 0
.ic V(T20) = 0
.ic V(T21) = 0
.ic V(T22) = 0
.ic V(T23) = 0
.ic V(T25) = 0
.ic V(T24) = 0
.param Rc = 'R / 3'
Battery
Cell Power
Cell Capacitance
Cell Resistance
Initial Conditions
.param PouchR = '2 * 0.052'
