BDR16/ARCHIBALD-the-battery-box/CURRENT.16-17/Accumulator/Stacks/Thermal Simulation/SPICE Model/Module.asc

C1: cap; {Ca2}
C2: cap; {Ca2}
C3: cap; {Cf2}
C4: cap; {Cf2}
R1: res; {Rci}
R2: res; {Ri}
R3: res; {Rcia}
R4: res; {Ra2}
R5: res; {Ra2}
R6: res; {Rcia}
R7: res; {Ri}
R8: res; {Rci}
R9: res; {Rcf}
R10: res; {Rf}
R11: res; {Rcf}
X1: Cell
X3: Cell
Named nets: 0, Tf, Tb, Ta, Tcf, Tcb, Tff, Tfb
.tran 90
Cell Characteristics
.param Width = '0.1606 - 0.0045'
.param Height = '0.227 - 0.0045 - 0.017'
Insulation Resistance
.param InsThick = '3 * 0.0000254'
.param InsThermCond = 0.12
.param Rci = 'Ri / 3'
Aluminum Characteristics
.param AluThick = 0.0003
.param AluDensity = 2700
Aluminum Capacitance
.param AluSpecHeat = 900
.param Ca = 'Width * Height * AluThick * AluDensity * AluSpecHeat'
.param Ca2 = 'Ca / 2'
Aluminum Resistance
.param AluThermCond = 205
.param Ra = 'AluThick / (Width * Height * AluThermCond)'
.param Ra2 = 'Ra / 2'
.param Rcia = 'Rci'
Foam Characateristics
.param FoamThick = 0.0016
.param FoamDensity = 320
Foam Capacitance
.param FoamSpecHeat = 1200
.param Cf = 'Width * Height * FoamThick * FoamDensity * FoamSpecHeat'
.param Cf2 = 'Cf / 2'
Foam Resistance
.param FoamThermCond = 0.015
.param Rf = 'FoamThick / (Width * Height * FoamThermCond)'
.param Rcf = 'Rci'
.param Ri = 'InsThick / (Width * Height * InsThermCond)'
.ic V(Tcf) = 0
.ic V(Tcb) = 0
.ic V(Tff) = 0
.ic V(Tfb) = 0
Simulation Parameters
Contact Resistances
