BDR16/ARCHIBALD-the-battery-box/(commit log)

2016-11-20 ADDING RESOURCES FROM THE PAST BRUH
    All mechanical stuff from 2015-2016 design cycle has been added in the
    appropriate folder.
    [0 Gauge Lug.SLDPRT, 1590J Lid - Modified.sldasm, 1590J Lid.sldprt, 1590JF Box.sldprt, A123 Amp20 Old.SLDPRT, AMS.SLDASM, ASTM D149 IEC 60243 Specimen.SLDPRT, Accumulator Box HV HC Panel CAM.SLDPRT]
2016-11-20 more resource and file management changes
    [0 Gauge Lug.SLDPRT, 1590J Lid - Modified.sldasm, 1590J Lid.sldprt, 1590JF Box.sldprt, A123 Amp20 Old.SLDPRT, AMS.SLDASM, ASTM D149 IEC 60243 Specimen.SLDPRT, Accumulator Box HV HC Panel CAM.SLDPRT]
2016-11-20 more resources bruh
    [Accumulator Upper Tab.SLDPRT, BBB Board.SLDPRT, BBB Box.SLDPRT, BBB.SLDASM, Extra Tab.SLDPRT, Firewall.SLDPRT, FirewallAttachToBodyDante1.SLDPRT, Planetary Outer Tabs.sldprt]
2016-11-21 resources added in the new folder for starting to redesign the battery box
    [Even Stack.SLDASM, FirewallAttachToBodyDante1.SLDPRT, Odd Stack.SLDASM, Sixer Stack.SLDASM]
2016-12-09 Excel spreadsheet with our measurements for battery box options
    Tall box, long box, short box, balanced box, you name it
    [Measurements.xlsm]
2016-12-13 Added files for a stack with copper dividers.
    Still needs some work, but the basic idea is there
    [Cell_A.SLDPRT, Cell_B.SLDPRT, Copper_Divider.SLDPRT, Copper_Divider_A.SLDPRT, Copper_Divider_B.SLDPRT, End_Plate.SLDPRT, Heatsink.SLDPRT, Neoprene_Insulation_A.SLDPRT]
2016-12-15 Minor adjustments to all parts and assemblies
    [Cell_A.SLDPRT, Cell_B.SLDPRT, Connecting_Rod.SLDPRT, Copper_Divider_A.SLDPRT, Copper_Divider_B.SLDPRT, End_Plate.SLDPRT, Heatsink.SLDPRT, Neoprene_Insulation_A.SLDPRT]
2016-12-15 Added rail and a working chassis assembly
    Gonna start adding rail to the chassis then choose box dimensions and do
    the female rail system and then fit them together in chassis to see the
    fit
    [Chassis box working model.SLDASM, Measurements.xlsm, Rail.SLDPRT]
2016-12-15 work on chassis
    [Chassis box working model.SLDASM]
2016-12-15 Rail has been simulated
    with the entire weight of battery box at 9 times gravity; there are now
    3 rails in the chassis to be put in final position; also started making
    a box to fit in these mounting points
    [Aydin_working_box.SLDPRT, Chassis box working model.SLDASM, Rail.SLDPRT]
2016-12-16 Rail system simulated or attempted to. Had to simplify the system.
    anyways, our rail is tough as hell, as is so I am going to make a
    smaller one to give more space for box and save weight
    [Aydin_working_box.SLDPRT, BOX4simulatingmount2chassis.SLDASM, Chassis box working model.SLDASM, Rail.SLDPRT, rail-mk.2.SLDPRT]
2016-12-18 box simulations & module-fit
    simulated rails with solid box with correct gravity this time
    [Aydin_boxmodulefit.SLDPRT, Aydin_working_box.SLDPRT, BOX4simulatingmount2chassis.SLDASM, Chassis box working model.SLDASM, Rail.SLDPRT]
2016-12-18 added lid tabs
    [Aydin_boxmodulefit.SLDPRT]
2016-12-18 THE ASSEMBLY HAS STARTED
    lid, box, assembly, waiting for mods
    [Aydin_boxmodulefit.SLDPRT, BOX-LID-MOD.SLDASM, LID.SLDPRT]
2016-12-18 Added updated stacks and parts
    [Cell_A.SLDPRT, Cell_A_End.SLDPRT, Cell_B.SLDPRT, Cell_B_End.sldprt, Connecting_Rod.SLDPRT, Copper_Divider_A.SLDPRT, Copper_Divider_B.SLDPRT, End_Plate.SLDPRT]
